nikolozka/Fibel2/Fib2_Docs/Audio/Screenshot 2024-04-28 at 23.19.49.png

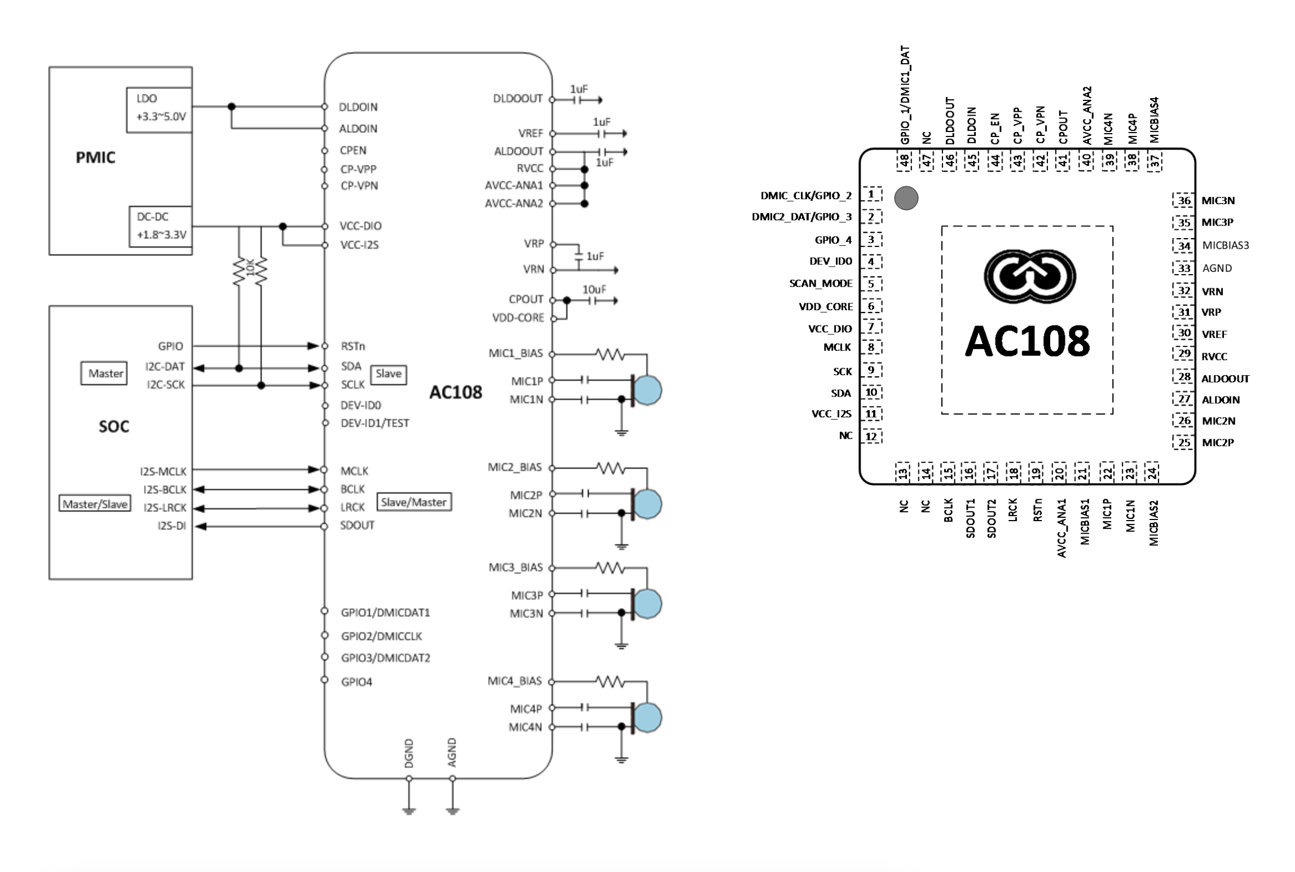
Fib2_Docs/Audio/Screenshot 2024-04-28 at 23.19.49.png
