nikolozka/Fibel2/Fib2_Docs/Jetson/Jetson_Orin_Nano_DevKit_Carrier_Board_Reference_Design_Files_A04_20230320/P3768_A04_BOM.xls

Nvidia Multi-Level BOM With AML
Target Part : | 699-13768-0000-400,NVIDIA,A (Design)
Execution Time : | 2023-02-26 17:52 PST
Configuration : | Date Effectivity: Date=2023-02-25, View=Design, Applied to Top=False, Use Default=False
Name | Qty | Ref Des | Manufacturer Part Number | Manufacturer
CAP NCS X5R 0402 0.1uF +/-10% 6.3V | 1 | C134 | C1005X5R1C104K050BA | TDK Corporation of America
 |  |  | 0402X104K6R3CT | Walsin Technology Corporation USA
 |  |  | CL05A104KQ5NNNC | SAMSUNG ELECTRONICS CO., LTD.
 |  |  | CC0402KRX5R5BB104 | Yageo Corporation
 |  |  | NMC0402X5R104K6.3TRPF | NIC COMPONENTS CORP.
 |  |  | JMK105BJ104KV-F | Taiyo Yuden Co., Ltd.
 |  |  | GRM155R60J104KA01D | Murata Manufacturing Co., Ltd.
 |  |  | C0402C104K9PACTU | KEMET Corporation
 |  |  | 04026D104KAT2A | KYOCERA Corporation
IC SERIAL EEPROM 1.0MHz DFN08 AT24C02D-MAHM-T | 1 | U17 | AT24C02D-MAHM-T | Microchip Technology, Inc.
RES 0402 10kohm 5% 62.5mW | 4 | R129, R126, R127, R131 | NRC04J103TRF | NIC COMPONENTS CORP.
 |  |  | MCR01SMQPJ103 | ROHM Co., Ltd.
 |  |  | RTT02103JTH | RALEC ELEC
 |  |  | RK73B1ETTP103J | KOA Speer Electronics, Inc.
 |  |  | RC0402JR-0710KL | Yageo Corporation
 |  |  | WR04X103 JTL | Walsin Technology Corporation USA
 |  |  | RC1005J103CS | SAMSUNG ELECTRONICS CO., LTD.
 |  |  | CRCW040210K0JNED | Vishay Americas Inc.
 |  |  | TFGL0402R1002J-T10 | Thin Film Technology Corporation
 |  |  | ERJ2GEJ103X | Panasonic Electronic Devices Co., Ltd.
CAP NCS X5R 0402 0.1uF +/-10% 6.3V | 3 | C132, C429, C430 | C1005X5R1C104K050BA | TDK Corporation of America
 |  |  | 0402X104K6R3CT | Walsin Technology Corporation USA
 |  |  | CL05A104KQ5NNNC | SAMSUNG ELECTRONICS CO., LTD.
 |  |  | CC0402KRX5R5BB104 | Yageo Corporation
 |  |  | NMC0402X5R104K6.3TRPF | NIC COMPONENTS CORP.
 |  |  | JMK105BJ104KV-F | Taiyo Yuden Co., Ltd.
 |  |  | GRM155R60J104KA01D | Murata Manufacturing Co., Ltd.
 |  |  | C0402C104K9PACTU | KEMET Corporation
 |  |  | 04026D104KAT2A | KYOCERA Corporation
Connector (TH High Temp) WIRE TO BOARD WAFER MALE VERT 4 POS 1.25mm PITCH 2.4mm MAX PIN LENGTH | 1 | J13 | 50275-00471-003 | Aces Electronic Co., Ltd.
IC GENERAL Level Shifter SC70_6 SN74LVC1T45DCKR | 1 | U15 | SN74LVC1T45DCKR | Texas Instruments, Inc.
RES 0402 100kohm 1% 62.5mW | 1 | R119 | ERJ2RKF1003X | Matsushita Electric Works, Ltd.
 |  |  | WR04X1003FTL | Walsin Technology Corporation USA
 |  |  | TFGL0402R1003F-T10 | Thin Film Technology Corporation
 |  |  | RC1005F104CS | SAMSUNG ELECTRONICS CO., LTD.
 |  |  | RC0402FR-07100KL | Yageo Corporation
 |  |  | NRC04F1003TRF | NIC COMPONENTS CORP.
 |  |  | CRCW0402100KFKED | Vishay Americas Inc.
 |  |  | MCR01SMQPF1003 | ROHM Co., Ltd.
 |  |  | RTT021003FTH | RALEC ELEC
 |  |  | RK73H1ETTP1003F | KOA Speer Electronics, Inc.
RES 0402 10kohm 5% 62.5mW | 2 | R123, R124 | NRC04J103TRF | NIC COMPONENTS CORP.
 |  |  | MCR01SMQPJ103 | ROHM Co., Ltd.
 |  |  | RTT02103JTH | RALEC ELEC
 |  |  | RK73B1ETTP103J | KOA Speer Electronics, Inc.
 |  |  | RC0402JR-0710KL | Yageo Corporation
 |  |  | WR04X103 JTL | Walsin Technology Corporation USA
 |  |  | RC1005J103CS | SAMSUNG ELECTRONICS CO., LTD.
 |  |  | CRCW040210K0JNED | Vishay Americas Inc.
 |  |  | TFGL0402R1002J-T10 | Thin Film Technology Corporation
 |  |  | ERJ2GEJ103X | Panasonic Electronic Devices Co., Ltd.
RES 0402 130ohm 5% 62.5mW | 1 | R543 | MCR01SMQPJ131 | ROHM Co., Ltd.
 |  |  | TFGL0402R1300J-T10 | Thin Film Technology Corporation
 |  |  | ERJ2GEJ131X | Matsushita Electric Works, Ltd.
 |  |  | NRC04J131TRF | NIC COMPONENTS CORP.
 |  |  | WR04X131 JTL | Walsin Technology Corporation USA
 |  |  | RC0402JR-07130RL | Yageo Corporation
 |  |  | RTT02131JTH | RALEC ELEC
 |  |  | RK73B1ETTP131J | KOA Speer Electronics, Inc.
 |  |  | RC1005J131CS | SAMSUNG ELECTRONICS CO., LTD.
 |  |  | CRCW0402130RJNED | Vishay Americas Inc.
RES 0402 4.7kohm 5% 62.5mW | 1 | R122 | RTT02472JTH | RALEC ELEC
 |  |  | CRCW04024K70JNED | Vishay Americas Inc.
 |  |  | WR04X472 JTL | Walsin Technology Corporation USA
 |  |  | ERJ2GEJ472X | Matsushita Electric Works, Ltd.
 |  |  | NRC04J472TRF | NIC COMPONENTS CORP.
 |  |  | RM04JTN472 | TA-I Technology Co., Ltd.
 |  |  | TFGL0402R4701J-T10 | Thin Film Technology Corporation
 |  |  | MCR01SMQPJ472 | ROHM Co., Ltd.
 |  |  | RC0402JR-074K7L | Yageo Corporation
 |  |  | RC1005J472CS | SAMSUNG ELECTRONICS CO., LTD.
 |  |  | RK73B1ETTP472J | KOA Speer Electronics, Inc.
N-CH MOSFET DFN1006 0.95A 12V 0.83W GLS3261NG-1DL3R | 1 | Q20 | GLS3261NG-1DL3R | LISION TECHNOLOGY INC.
OPTO LED SMD BRILLIANT YELLOW GREEN 0603 | 1 | DS1 | EAST1608GA9 | Everlight Electronics Co., Ltd.
RES 0402 1.8kohm 5% 62.5mW | 1 | R7 | RTT02182JTH | RALEC ELEC
 |  |  | RC0402JR-071K8L | Yageo Corporation
 |  |  | TFGL0402R1801J-T10 | Thin Film Technology Corporation
 |  |  | RC1005J182CS | SAMSUNG ELECTRONICS CO., LTD.
 |  |  | RK73B1ETTP182J | KOA Speer Electronics, Inc.
 |  |  | WR04X182 JTL | Walsin Technology Corporation USA
 |  |  | CRCW04021K80JNED | Vishay Americas Inc.
 |  |  | NRC04J182TRF | NIC COMPONENTS CORP.
 |  |  | ERJ2GEJ182X | Matsushita Electric Works, Ltd.
 |  |  | MCR01SMQPJ182 | ROHM Co., Ltd.
RES SCD 0402 0 OHM 1AMP | 1 | R1 | RTT02000JTH | RALEC ELEC
 |  |  | RC1005J000CS | SAMSUNG
 |  |  | WR04X000PTL | Walsin Technology Corporation USA
 |  |  | ERJ2GE0R00X | Panasonic Electric Works Co. Ltd.
 |  |  | TFGL0402WJUMPF-T10 | Thin Film Technology Corporation
N-CH MOSFET DFN1006 0.95A 12V 0.83W GLS3261NG-1DL3R | 1 | Q1 | GLS3261NG-1DL3R | LISION TECHNOLOGY INC.
CAP NCS X5R 0402 0.1uF +/-10% 6.3V | 2 | C129, C130 | C1005X5R1C104K050BA | TDK Corporation of America
 |  |  | 0402X104K6R3CT | Walsin Technology Corporation USA
 |  |  | CL05A104KQ5NNNC | SAMSUNG ELECTRONICS CO., LTD.
 |  |  | CC0402KRX5R5BB104 | Yageo Corporation
 |  |  | NMC0402X5R104K6.3TRPF | NIC COMPONENTS CORP.
 |  |  | JMK105BJ104KV-F | Taiyo Yuden Co., Ltd.
 |  |  | GRM155R60J104KA01D | Murata Manufacturing Co., Ltd.
 |  |  | C0402C104K9PACTU | KEMET Corporation
 |  |  | 04026D104KAT2A | KYOCERA Corporation
IC GENERAL Level Shifter DFN8 TXB0302DQMR | 1 | U16 | TXB0302DQMR | Texas Instruments, Inc.
RES 0402 100kohm 1% 62.5mW | 2 | R121, R125 | ERJ2RKF1003X | Matsushita Electric Works, Ltd.
 |  |  | WR04X1003FTL | Walsin Technology Corporation USA
 |  |  | TFGL0402R1003F-T10 | Thin Film Technology Corporation
 |  |  | RC1005F104CS | SAMSUNG ELECTRONICS CO., LTD.
 |  |  | RC0402FR-07100KL | Yageo Corporation
 |  |  | NRC04F1003TRF | NIC COMPONENTS CORP.
 |  |  | CRCW0402100KFKED | Vishay Americas Inc.
 |  |  | MCR01SMQPF1003 | ROHM Co., Ltd.
 |  |  | RTT021003FTH | RALEC ELEC
 |  |  | RK73H1ETTP1003F | KOA Speer Electronics, Inc.
RES SCD 0402 0 OHM 1AMP | 1 | R120 | RTT02000JTH | RALEC ELEC
 |  |  | RC1005J000CS | SAMSUNG
 |  |  | WR04X000PTL | Walsin Technology Corporation USA
 |  |  | ERJ2GE0R00X | Panasonic Electric Works Co. Ltd.
 |  |  | TFGL0402WJUMPF-T10 | Thin Film Technology Corporation
CAP X5R 0402 1uF +/-20% 16V | 1 | C357 | CC0402KRX5R7BB105 | Yageo Corporation
 |  |  | V105K0402X5R160NBT | Guangdong Viiyong Electronics Technology Co., Ltd
 |  |  | 0402X105M160CT | Walsin Technology Corporation USA
 |  |  | CL05A105KO5NNNC | Samsung Electro-Mechanics Co., Ltd.
 |  |  | EMK105BJ105KV-F | Taiyo Yuden Co., Ltd.
 |  |  | C1005X5R1C105M050BC | TDK Corporation of America
 |  |  | 0402X105K160CT | Walsin Technology Corporation USA
 |  |  | V105M0402X5R160NBT | Guangdong Viiyong Electronics Technology Co., Ltd
CAP NCS X5R 0603 10uF +/-20% 6.3V | 1 | C164 | C0603C106M9PAC | KEMET Corporation
 |  |  | 06036D106MAT2A | AVX Corporation
 |  |  | CC0603MRX5R5BB106 | Yageo Corporation
 |  |  | CL10A106MQ8NNNC | Samsung Electro-Mechanics Co., Ltd.
 |  |  | GRM188R60J106ME47D | Murata Manufacturing Co., Ltd.
 |  |  | JMK107BJ106MA-T | Taiyo Yuden Co., Ltd.
 |  |  | 0603X106M6R3CT | Walsin Technology Corporation USA
 |  |  | V106M0603X5R6R3NKT | Guangdong Viiyong Electronics Technology Co., Ltd
 |  |  | JMK107ABJ106MA-T | TAIYO YUDEN (U.S.A) INC.
CAP C0G 0402 33pF +/-5% 50V | 1 | C165 | GRM1555C1H330JA01D | Murata Manufacturing Co., Ltd.
 |  |  | CL05C330JB5NNNC | SAMSUNG ELECTRONICS CO., LTD.
 |  |  | CC0402JRNPO9BN330 | Yageo Corporation
 |  |  | 04025A330CAT2A | KYOCERA Corporation
 |  |  | C0402C330J5GACTU | KEMET Corporation
 |  |  | UMK105CG330JV-F | Taiyo Yuden Co., Ltd.
 |  |  | 0402N330J500CT | Walsin Technology Corporation USA
 |  |  | NMC0402NP0330J50TRPF | NIC COMPONENTS CORP.
 |  |  | C1005C0G1H330J050BA | TDK Corporation of America
 |  |  | C0402N330J050T | Holy Stone Enterprise (Hong Kong) Co., Ltd.
 |  |  | V330J0402C0G500NBT | Guangdong Viiyong Electronics Technology Co., Ltd
CAP X7R 0402 1.5nF +/-10% 16V | 1 | C428 | CC0402KRX7R7BB152 | Yageo Corporation
 |  |  | EMK105B7152KV-F | Taiyo Yuden Co., Ltd.
 |  |  | 0402B152K160CT | Walsin Technology Corporation USA
 |  |  | V152K0402X7R160NBT | Guangdong Viiyong Electronics Technology Co., Ltd
 |  |  | CL05B152KO5NNNC | Samsung Electro-Mechanics Co., Ltd.
CAP NCS X5R 0805 22uF +/-20% 6.3V | 3 | C358, C166, C167 | CC0805MKX5R5BB226 | Yageo Corporation
 |  |  | V226M0805X5R6R3NHP | Guangdong Viiyong Electronics Technology Co., Ltd
 |  |  | GRM21BR60J226ME39L | Murata Manufacturing Co., Ltd.
 |  |  | C2012X5R0J226MT | TDK Corporation of America
 |  |  | CL21A226MQQNNNE | Samsung Electro-Mechanics Co., Ltd.
 |  |  | CC0805MRX5R5BB226 | Yageo Corporation
 |  |  | GRM21AR60J226ME47 | Murata Manufacturing Co., Ltd.
 |  |  | 0805X226M6R3CT | Walsin Technology Corporation USA
 |  |  | C0805C226M9PAC | KEMET Corporation
 |  |  | JMK212BJ226MG-T | Taiyo Yuden Co., Ltd.
 |  |  | C0805B226M007T | Holy Stone Enterprise (Hong Kong) Co., Ltd.
IND 2520 METAL DUST 2.2uH 20% 2.2A 102mohm 0 0Hz 0Hz | 1 | L19 | HMLQ25201T-2R2MSR | Cyntec Co., Ltd.
RES 0402 100ohm 1% 62.5mW | 1 | R176 | RK73H1ETTP1000F | KOA Speer Electronics, Inc.
 |  |  | MCR01SMQPF1000 | ROHM Co., Ltd.
 |  |  | RC1005F101CS | SAMSUNG ELECTRONICS CO., LTD.
 |  |  | TFGL0402R1000F-T10 | Thin Film Technology Corporation
 |  |  | CRCW0402100RFKED | Vishay Americas Inc.
 |  |  | RC0402FR-07100RL | Yageo Corporation
 |  |  | RTT021000FTH | RALEC ELEC
 |  |  | WR04X1000FTL | Walsin Technology Corporation USA
 |  |  | ERJ2RKF1000X | Matsushita Electric Works, Ltd.
 |  |  | NRC04F1000TRF | NIC COMPONENTS CORP.
 |  |  | RM04FTN1000 | TA-I Technology Co., Ltd.
RES 0402 100kohm 1% 62.5mW | 1 | R177 | ERJ2RKF1003X | Matsushita Electric Works, Ltd.
 |  |  | WR04X1003FTL | Walsin Technology Corporation USA
 |  |  | TFGL0402R1003F-T10 | Thin Film Technology Corporation
 |  |  | RC1005F104CS | SAMSUNG ELECTRONICS CO., LTD.
 |  |  | RC0402FR-07100KL | Yageo Corporation
 |  |  | NRC04F1003TRF | NIC COMPONENTS CORP.
 |  |  | CRCW0402100KFKED | Vishay Americas Inc.
 |  |  | MCR01SMQPF1003 | ROHM Co., Ltd.
 |  |  | RTT021003FTH | RALEC ELEC
 |  |  | RK73H1ETTP1003F | KOA Speer Electronics, Inc.
RES 0402 121kohm 1% 62.5mW | 1 | R178 | TFGL0402R1213F-T10 | Thin Film Technology Corporation
 |  |  | RTT021213FTH | RALEC ELEC
 |  |  | ERJ2RKF1213X | Matsushita Electric Works, Ltd.
 |  |  | WR04X1213FTL | Walsin Technology Corporation USA
 |  |  | CRCW0402121KFKED | Vishay Americas Inc.
 |  |  | RK73H1ETTP1213F | KOA Speer Electronics, Inc.
 |  |  | MCR01SMQPF1213 | ROHM Co., Ltd.
 |  |  | NRC04F1213TRF | NIC COMPONENTS CORP.
 |  |  | RC1005F1213CS | SAMSUNG ELECTRONICS CO., LTD.
 |  |  | RC0402FR-07121KL | Yageo Corporation
RES 0402 130ohm 5% 62.5mW | 1 | R439 | MCR01SMQPJ131 | ROHM Co., Ltd.
 |  |  | TFGL0402R1300J-T10 | Thin Film Technology Corporation
 |  |  | ERJ2GEJ131X | Matsushita Electric Works, Ltd.
 |  |  | NRC04J131TRF | NIC COMPONENTS CORP.
 |  |  | WR04X131 JTL | Walsin Technology Corporation USA
 |  |  | RC0402JR-07130RL | Yageo Corporation
 |  |  | RTT02131JTH | RALEC ELEC
 |  |  | RK73B1ETTP131J | KOA Speer Electronics, Inc.
 |  |  | RC1005J131CS | SAMSUNG ELECTRONICS CO., LTD.
 |  |  | CRCW0402130RJNED | Vishay Americas Inc.
RES SCD 0402 0 OHM 1AMP | 1 | R441 | RTT02000JTH | RALEC ELEC
 |  |  | RC1005J000CS | SAMSUNG
 |  |  | WR04X000PTL | Walsin Technology Corporation USA
 |  |  | ERJ2GE0R00X | Panasonic Electric Works Co. Ltd.
 |  |  | TFGL0402WJUMPF-T10 | Thin Film Technology Corporation
VREG CONTROLLER/DRIVER/FET DFN10 Buck 1Ph 1MHz 0.6V 3.3V 1% % GS7303ACTD-R | 1 | U26 | GS7303ACTD-R | Green Solution Technology Co.,LTD.
CAP X5R 0402 0.47uF +/-10% 25V | 1 | C427 | C1005X5R1E474K050BB | TDK Corporation of America
 |  |  | CL05A474KA5NNNC | Samsung Electro-Mechanics Co., Ltd.
CAP NCS X5R 0805 22uF +/-20% 25V | 1 | C305 | C2012X5R1E226M125AC | TDK Corporation of America
 |  |  | GRM21BR61E226ME44L | Murata Manufacturing Co., Ltd.
 |  |  | CL21A226MAQNNNE | Samsung Electro-Mechanics Co., Ltd.
 |  |  | CL21A226MAYNNNE | Samsung Electro-Mechanics Co., Ltd.
 |  |  | CC0805MKX5R8BB226 | Yageo Corporation
CAP NCS X5R 0805 4.7uF +/-10% 25V | 1 | C303 | 0805X475K250CT | Walsin Technology Corporation USA
 |  |  | CL21A475KAQNNNE | Samsung Electro-Mechanics Co., Ltd.
CAP X7R 0805 1uF +/-10% 25V | 1 | C304 | C2012X7R1E105KT | TDK Corporation of America
 |  |  | TMK212B7105KG-T | Taiyo Yuden Co., Ltd.
 |  |  | CL21B105KAFNNNE | Samsung Electro-Mechanics Co., Ltd.
RES 0402 10kohm 5% 62.5mW | 3 | R381, R523, R380 | NRC04J103TRF | NIC COMPONENTS CORP.
 |  |  | MCR01SMQPJ103 | ROHM Co., Ltd.
 |  |  | RTT02103JTH | RALEC ELEC
 |  |  | RK73B1ETTP103J | KOA Speer Electronics, Inc.
 |  |  | RC0402JR-0710KL | Yageo Corporation
 |  |  | WR04X103 JTL | Walsin Technology Corporation USA
 |  |  | RC1005J103CS | SAMSUNG ELECTRONICS CO., LTD.
 |  |  | CRCW040210K0JNED | Vishay Americas Inc.
 |  |  | TFGL0402R1002J-T10 | Thin Film Technology Corporation
 |  |  | ERJ2GEJ103X | Panasonic Electronic Devices Co., Ltd.
RES 0402 1Mohm 5% 62.5mW | 2 | R524, R479 | WR04X105 JTL | Walsin Technology Corporation USA
 |  |  | RK73B1ETTP105J | KOA Speer Electronics, Inc.
 |  |  | TFGL0402R1004J-T10 | Thin Film Technology Corporation
 |  |  | NRC04J105TRF | NIC COMPONENTS CORP.
 |  |  | RC1005J105CS | SAMSUNG ELECTRONICS CO., LTD.
 |  |  | MCR01SMQPJ105 | ROHM Co., Ltd.
 |  |  | CRCW04021M00JNED | Vishay Americas Inc.
 |  |  | RTT02105JTH | RALEC ELEC
 |  |  | RC0402JR-071ML | Yageo Corporation
 |  |  | ERJ2GEJ105X | Matsushita Electric Works, Ltd.
RES 0402 15kohm 5% 62.5mW | 1 | R384 | WR04X153 JTL | Walsin Technology Corporation USA
 |  |  | RK73B1ETTP153J | KOA Speer Electronics, Inc.
 |  |  | NRC04J153TRF | NIC COMPONENTS CORP.
 |  |  | RC0402JR-0715KL | Yageo Corporation
 |  |  | RC1005J153CS | SAMSUNG ELECTRONICS CO., LTD.
 |  |  | TFGL0402R1502J-T10 | Thin Film Technology Corporation
 |  |  | RTT02153JTH | RALEC ELEC
 |  |  | ERJ2GEJ153X | Matsushita Electric Works, Ltd.
 |  |  | MCR01SMQPJ153 | ROHM Co., Ltd.
 |  |  | CRCW040215K0JNED | Vishay Americas Inc.
RES 0402 33kohm 5% 62.5mW | 1 | R383 | RC0402JR-0733KL | Yageo Corporation
 |  |  | MCR01SMQPJ333 | ROHM Co., Ltd.
 |  |  | NRC04J333TRF | NIC COMPONENTS CORP.
 |  |  | CRCW040233K0JNED | Vishay Americas Inc.
 |  |  | RK73B1ETTP333J | KOA Speer Electronics, Inc.
 |  |  | RC1005J333CS | SAMSUNG ELECTRONICS CO., LTD.
 |  |  | TFGL0402R3302J-T10 | Thin Film Technology Corporation
 |  |  | RTT02333JTH | RALEC ELEC
 |  |  | WR04X333 JTL | Walsin Technology Corporation USA
 |  |  | ERJ2GEJ333X | Matsushita Electric Works, Ltd.
RES SCD 0402 0 OHM 1AMP | 1 | R526 | RTT02000JTH | RALEC ELEC
 |  |  | RC1005J000CS | SAMSUNG
 |  |  | WR04X000PTL | Walsin Technology Corporation USA
 |  |  | ERJ2GE0R00X | Panasonic Electric Works Co. Ltd.
 |  |  | TFGL0402WJUMPF-T10 | Thin Film Technology Corporation
P-CH MOSFET DFN3X3 -17A 25V 30W AONR21357 | 4 | Q47, Q50, Q48, Q49 | AONR21357 | Alpha and Omega Semiconductor Incorporated
N-CH MOSFET NCS SOT323_1G1D1S 0.115A 20V 0.15W 2N7002_SERIES | 1 | Q56 | 2N7002HWG-3T3R | LISION TECHNOLOGY INC.
 |  |  | 2N7002W | PANJIT SEMICONDUCTOR
 |  |  | 2N7002W-7-F | Diodes Incorporated
DUAL N-CH MOSFET NCS SOT363 0.2A 0.2A 20V 20V 0.2W 0.2W BSS138 | 2 | Q57, Q46 | BSS138DW-7-F | Diodes Incorporated
 |  |  | PJT138K_R1_00001 | Pan Jit Americas, Inc.
 |  |  | LS6033DNG-3T6R | LISION TECHNOLOGY INC.
CAP TA-Polymer SMD_7343 100uF +/-20% 25V 40mohm 3.1mm Black | 2 | C146, C145 | T521D107M025ATE040 | KEMET Corporation
CAP NCS X5R 0402 0.1uF +/-10% 6.3V | 2 | C4, C5 | C1005X5R1C104K050BA | TDK Corporation of America
 |  |  | 0402X104K6R3CT | Walsin Technology Corporation USA
 |  |  | CL05A104KQ5NNNC | SAMSUNG ELECTRONICS CO., LTD.
 |  |  | CC0402KRX5R5BB104 | Yageo Corporation
 |  |  | NMC0402X5R104K6.3TRPF | NIC COMPONENTS CORP.
 |  |  | JMK105BJ104KV-F | Taiyo Yuden Co., Ltd.
 |  |  | GRM155R60J104KA01D | Murata Manufacturing Co., Ltd.
 |  |  | C0402C104K9PACTU | KEMET Corporation
 |  |  | 04026D104KAT2A | KYOCERA Corporation
Connector (Edge) DDR4 SO-DIMM SOCKET 260 PIN RA BLACK 0.5mm PITCH | 1 | J2 | 2309413-1 | TE Connectivity Ltd.
DIODE SMD SCHOTTKY BARRIER 40V 3.0A SOD-123 | 1 | D4 | LS34SG | LISION TECHNOLOGY INC.
DIODE NORM TPD1E10B06 1 Line Bi-Directional 6V 12pF | 3 | D1, D3, D2 | TPD1E10B06DPYR | Texas Instruments, Inc.
RES 0402 10kohm 5% 62.5mW | 2 | R9, R231 | NRC04J103TRF | NIC COMPONENTS CORP.
 |  |  | MCR01SMQPJ103 | ROHM Co., Ltd.
 |  |  | RTT02103JTH | RALEC ELEC
 |  |  | RK73B1ETTP103J | KOA Speer Electronics, Inc.
 |  |  | RC0402JR-0710KL | Yageo Corporation
 |  |  | WR04X103 JTL | Walsin Technology Corporation USA
 |  |  | RC1005J103CS | SAMSUNG ELECTRONICS CO., LTD.
 |  |  | CRCW040210K0JNED | Vishay Americas Inc.
 |  |  | TFGL0402R1002J-T10 | Thin Film Technology Corporation
 |  |  | ERJ2GEJ103X | Panasonic Electronic Devices Co., Ltd.
CAP X5R 0603 1uF +/-20% 25V | 1 | C168 | V105M0603X5R250NDT | Guangdong Viiyong Electronics Technology Co., Ltd
 |  |  | CL10A105KA8NNNC | Samsung Electro-Mechanics Co., Ltd.
 |  |  | TMK107 BJ105KA-T | TAIYO YUDEN (U.S.A) INC.
 |  |  | C1608X5R1E105K080AC | TDK Corporation of America
 |  |  | 0603X105K250CT | Walsin Technology Corporation USA
 |  |  | CC0603KRX5R8BB105 | Yageo Corporation
CAP NCS X5R 0805 22uF +/-20% 25V | 2 | C204, C203 | C2012X5R1E226M125AC | TDK Corporation of America
 |  |  | GRM21BR61E226ME44L | Murata Manufacturing Co., Ltd.
 |  |  | CL21A226MAQNNNE | Samsung Electro-Mechanics Co., Ltd.
 |  |  | CL21A226MAYNNNE | Samsung Electro-Mechanics Co., Ltd.
 |  |  | CC0805MKX5R8BB226 | Yageo Corporation
CAP NCS X5R 0603 0.1uF +/-10% 25V | 1 | C171 | 0603X104K250CT | Walsin Technology Corporation USA
 |  |  | GRM188R61E104KA01D | Murata Manufacturing Co., Ltd.
 |  |  | NMC0603X5R104K25TRPF | NIC COMPONENTS CORP.
 |  |  | TMK107BJ104KA-T | Taiyo Yuden Co., Ltd.
 |  |  | 06033D104KAT2A | KYOCERA Corporation
 |  |  | CC0603KRX7R8BB104 | Yageo Corporation
 |  |  | CL10A104KA8NNNC | SAMSUNG ELECTRONICS CO., LTD.
 |  |  | C0603C104K3PACTU | KEMET Corporation
 |  |  | C1608X5R1H104K080AA | TDK Corporation of America
Connector (TH High Temp) POWER JACK 24V 5A | 1 | J16 | 2DC-0005B206F | Singatron Enterprise Co., Ltd. USA
ZENER SOD323 DDZ22BSF-7 0.9V 0.5W NOM 21.71V breakdown voltage | 1 | D65 | DDZ22BSF-7 | Diodes Incorporated
RES 0402 100kohm 1% 62.5mW | 2 | R182, R181 | ERJ2RKF1003X | Matsushita Electric Works, Ltd.
 |  |  | WR04X1003FTL | Walsin Technology Corporation USA
 |  |  | TFGL0402R1003F-T10 | Thin Film Technology Corporation
 |  |  | RC1005F104CS | SAMSUNG ELECTRONICS CO., LTD.
 |  |  | RC0402FR-07100KL | Yageo Corporation
 |  |  | NRC04F1003TRF | NIC COMPONENTS CORP.
 |  |  | CRCW0402100KFKED | Vishay Americas Inc.
 |  |  | MCR01SMQPF1003 | ROHM Co., Ltd.
 |  |  | RTT021003FTH | RALEC ELEC
 |  |  | RK73H1ETTP1003F | KOA Speer Electronics, Inc.
RES 0306_JUMPER 0ohm 0.05ohm 0.1W 0306 power jumper | 2 | R260, R261 | RM06JTN0 | TA-I Technology Co., Ltd.
 |  |  | TFGL0603WJUMPF-T5 | Thin Film Technology Corporation
 |  |  | RC0603JR-070RL | Yageo Corporation
 |  |  | RTT03000JTP | RALEC ELECTRONIC CORPORATION
 |  |  | WR06X000PTL | Walsin Technology Corporation USA
 |  |  | RC1608J000CS | SAMSUNG ELECTRONICS CO., LTD.
P-CH MOSFET DFN3X3 -17A 25V 30W AONR21357 | 1 | Q25 | AONR21357 | Alpha and Omega Semiconductor Incorporated
CAP X7R 0805 4.7uF +/-10% 25V | 1 | C307 | C2012X7R1E475K | TDK Corporation of America
 |  |  | GRM21BR71E475KA73L | Murata Manufacturing Co., Ltd.
 |  |  | TMK212AB7475KG-T | TAIYO YUDEN (U.S.A) INC.
 |  |  | C2012X7R475KFPS | Darfon Electronic Corp
 |  |  | CL21B475KAFNNNE | Samsung Electro-Mechanics Co., Ltd.
CAP NCS X7R 0603 1uF +/-10% 25V | 1 | C316 | CC0603KRX7R8BB105 | Yageo Corporation
 |  |  | CL10B105KA8NNNC | Samsung Electro-Mechanics Co., Ltd.
 |  |  | TMK107 B7105KA-T | TAIYO YUDEN (U.S.A) INC.
 |  |  | GRM188R71E105KA12D | Murata Manufacturing Co., Ltd.
 |  |  | C1608X7R1E105KT | TDK Corporation of America
 |  |  | 0603B105K250CT | Walsin Technology Corporation USA
CAP NCS X6S 0805 22uF +/-20% 16V | 2 | C324, C323 | CM21X6S226M16AT | KYOCERA Corporation
 |  |  | C2012X6S1C226M125AC | TDK Corporation of America
 |  |  | GRM21BC81C226ME44L | Murata Manufacturing Co., Ltd.
 |  |  | 0805S226M160CT | Walsin Technology Corporation USA
 |  |  | CC0805MKX6S7BB226 | Yageo Corporation
 |  |  | C2012X6S226MEPS | Darfon Electronic Corp
 |  |  | C0805S226M016T | Holy Stone Enterprise (Hong Kong) Co., Ltd.
 |  |  | EDK212BC6226MG-T | Taiyo Yuden Co., Ltd.
CAP TA-Polymer SMD_3528 150uF +/-20% 6.3V 25mohm 2mm Black | 1 | C326 | T520B157M006ATE025 | KEMET Corporation
CAP NCS X6S 0805 10uF +/-10% 25V | 3 | C320, C315, C317 | 0805S106K250CT | Walsin Technology Corporation USA
 |  |  | GRM21BC81E106KE11L | Murata Manufacturing Co., Ltd.
 |  |  | CL21X106KAYNNNE | Samsung Electro-Mechanics Co., Ltd.
CAP NCS X7R 0402 0.1uF 10% 16V | 1 | C325 | C0402C104K4RACTU | KEMET Corporation
 |  |  | V104K0402X7R160NBT | Guangdong Viiyong Electronics Technology Co., Ltd
 |  |  | 0402YC104KAT2A | KYOCERA Corporation
 |  |  | HCE0402X104K016T | Holy Stone Enterprise (Hong Kong) Co., Ltd.
 |  |  | GRM155R71C104KA88D | Murata Manufacturing Co., Ltd.
 |  |  | 0402B104K160CT | Walsin Technology Corporation USA
 |  |  | CC0402KRX7R7BB104 | Yageo Corporation
 |  |  | CL05B104KO5NNNC | SAMSUNG ELECTRONICS CO., LTD.
 |  |  | C1005X7R104KETS | Darfon Electronic Corp
CAP X7R 0402 0.1uF +/-20% 50V | 2 | C311, C331 | CC0402KRX7R9BB104 | Yageo Corporation
 |  |  | C1005X7R1H104M050BB | TDK Corporation of America
 |  |  | UMK105B7104KV-FR | Taiyo Yuden Co., Ltd.
 |  |  | C1005X7R104MGTS | Darfon Electronic Corp
 |  |  | GRM155R71H104ME14D | Murata Manufacturing Co., Ltd.
 |  |  | CL05B104KB5NNNC | Samsung Electro-Mechanics Co., Ltd.
 |  |  | V104M0402X7R500NCT | Guangdong Viiyong Electronics Technology Co., Ltd
 |  |  | 04025C104KAT2A | AVX Corporation
CAP X6S 1206 22uF +/-10% 25V | 1 | C321 | CL31X226KAHN3NE | SAMSUNG ELECTRONICS CO., LTD.
CAP X7R 0402 0.1uF +/-10% 25V | 1 | C310 | C1005X7R104KFTS | Darfon Electronic Corp
 |  |  | CC0402JRX7R8BB104 | Yageo Corporation
 |  |  | TMK105B7104KV-FR | Taiyo Yuden Co., Ltd.
 |  |  | GRM155R71E104KE14D | Murata Manufacturing Co., Ltd.
 |  |  | CL05B104KA5NNNC | SAMSUNG ELECTRONICS CO., LTD.
 |  |  | 0402B104K250CT | Walsin Technology Corporation USA
 |  |  | C1005X7R1E104K050BB | TDK Corporation of America
CAP C0G 0402 330pF +/-5% 50V | 1 | C322 | C0402N331J050T | Holy Stone Enterprise (Hong Kong) Co., Ltd.
 |  |  | CL05C331JB5NNNC | SAMSUNG ELECTRONICS CO., LTD.
 |  |  | NMC0402NP0331J50TRPF | NIC COMPONENTS CORP.
 |  |  | GRM1555C1H331JA01D | Murata Manufacturing Co., Ltd.
 |  |  | 0402N331J500CT | Walsin Technology Corporation USA
 |  |  | CC0402JRNPO9BN331 | Yageo Corporation
 |  |  | 04025A331JAT2A | KYOCERA Corporation
 |  |  | C0402C331J5GACTU | KEMET Corporation
 |  |  | V331J0402C0G500NBT | Guangdong Viiyong Electronics Technology Co., Ltd
 |  |  | C1005C0G1H331J050BA | TDK Corporation of America
 |  |  | UMK105CG331JV-F | Taiyo Yuden Co., Ltd.
CAP C0G 0402 560pF +/-5% 50V | 1 | C314 | C1005NP0561JGTS | Darfon Electronic Corp
 |  |  | V561J0402C0G500NBT | Guangdong Viiyong Electronics Technology Co., Ltd
 |  |  | 0402N561J500CT | Walsin Technology Corporation USA
 |  |  | CC0402JRNPO9BN561 | Yageo Corporation
 |  |  | UMK105CG561JV-F | Taiyo Yuden Co., Ltd.
 |  |  | CL05C561JB5NNNC | Samsung Electro-Mechanics Co., Ltd.
CAP X7R 0402 1nF +/-10% 16V | 1 | C312 | 0402YC102KAT2A | KYOCERA Corporation
 |  |  | CC0402KRX7R7BB102 | Yageo Corporation
 |  |  | GRM155R71C102KA01D | Murata Manufacturing Co., Ltd.
 |  |  | NMC0402X7R102K16TRPF | NIC COMPONENTS CORP.
 |  |  | C1005X7R1E102K050BA | TDK Corporation of America
 |  |  | EMK105B7102KV-F | Taiyo Yuden Co., Ltd.
 |  |  | C0402C102K4RACTU | KEMET Corporation
 |  |  | C0402X102K016T | Holy Stone Enterprise (Hong Kong) Co., Ltd.
 |  |  | V102K0402X7R160NBT | Guangdong Viiyong Electronics Technology Co., Ltd
 |  |  | 0402B102K160CT | Walsin Technology Corporation USA
 |  |  | CL05B102KO5NNNC | Samsung Electro-Mechanics Co., Ltd.
CAP X7R 0402 47nF +/-10% 16V | 1 | C309 | C1005X7R1C473K050BC | TDK Corporation of America
 |  |  | GRM155R71C473KA01D | Murata Manufacturing Co., Ltd.
 |  |  | 0402YC473KAT2A | KYOCERA Corporation
 |  |  | C0402C473K4RACTU | KEMET Corporation
 |  |  | C0402X473K016T | Holy Stone Enterprise (Hong Kong) Co., Ltd.
 |  |  | NMC0402X7R473K16TRPF | NIC COMPONENTS CORP.
 |  |  | CC0402KRX7R7BB473 | Yageo Corporation
 |  |  | EMK105B7473KV-F | Taiyo Yuden Co., Ltd.
 |  |  | V473K0402X7R160NBT | Guangdong Viiyong Electronics Technology Co., Ltd
 |  |  | 0402B473K160CT | Walsin Technology Corporation USA
 |  |  | CL05B473KO5NNNC | Samsung Electro-Mechanics Co., Ltd.
CAP NCS X5R 0402 0.1uF +/-20% 25V | 1 | C319 | CC0402MRX5R8BB104 | Yageo Corporation
 |  |  | 0402X104M250CT | Walsin Technology Corporation USA
IND 7_6X7_6 metal 3.3uH 20% 10A 21.45mohm -1 -1KHz 29MHz | 1 | L44 | XAL7030-332MEC | Coilcraft Incorporated
RES 0402 100ohm 1% 62.5mW | 1 | R404 | RK73H1ETTP1000F | KOA Speer Electronics, Inc.
 |  |  | MCR01SMQPF1000 | ROHM Co., Ltd.
 |  |  | RC1005F101CS | SAMSUNG ELECTRONICS CO., LTD.
 |  |  | TFGL0402R1000F-T10 | Thin Film Technology Corporation
 |  |  | CRCW0402100RFKED | Vishay Americas Inc.
 |  |  | RC0402FR-07100RL | Yageo Corporation
 |  |  | RTT021000FTH | RALEC ELEC
 |  |  | WR04X1000FTL | Walsin Technology Corporation USA
 |  |  | ERJ2RKF1000X | Matsushita Electric Works, Ltd.
 |  |  | NRC04F1000TRF | NIC COMPONENTS CORP.
 |  |  | RM04FTN1000 | TA-I Technology Co., Ltd.
RES 0402 10kohm 1% 62.5mW | 3 | R389, R406, R397 | RK73H1ETTP1002F | KOA Speer Electronics, Inc.
 |  |  | TFGL0402R1002F-T10 | Thin Film Technology Corporation
 |  |  | CRCW040210K0FKED | Vishay Americas Inc.
 |  |  | WR04X1002FTL | Walsin Technology Corporation USA
 |  |  | MCR01SMQPF1002 | ROHM Co., Ltd.
 |  |  | RM04FTN1002 | TA-I Technology Co., Ltd.
 |  |  | RTT021002FTH | RALEC ELEC
 |  |  | NRC04F1002TRF | NIC COMPONENTS CORP.
 |  |  | RC1005F103CS | SAMSUNG ELECTRONICS CO., LTD.
 |  |  | RC0402FR-0710KL | Yageo Corporation
 |  |  | ERJ2RKF1002X | Matsushita Electric Works, Ltd.
RES 0402 200kohm 1% 62.5mW | 1 | R403 | CRCW0402200KFKED | Vishay Americas Inc.
 |  |  | RK73H1ETTP2003F | KOA Speer Electronics, Inc.
 |  |  | RC0402FR-07200KL | Yageo Corporation
 |  |  | RC1005F204CS | SAMSUNG ELECTRONICS CO., LTD.
 |  |  | MCR01SMQPF2003 | ROHM Co., Ltd.
 |  |  | ERJ2RKF2003X | Matsushita Electric Works, Ltd.
 |  |  | WR04X2003FTL | Walsin Technology Corporation USA
 |  |  | RTT022003FTH | RALEC ELEC
 |  |  | NRC04F2003TRF | NIC COMPONENTS CORP.
 |  |  | TFGL0402R2003F-T10 | Thin Film Technology Corporation
RES 0402 56.2kohm 1% 62.5mW | 1 | R405 | CRCW040256K2FKED | Vishay Americas Inc.
 |  |  | WR04X5622FTL | Walsin Technology Corporation USA
 |  |  | RC1005F5622CS | SAMSUNG ELECTRONICS CO., LTD.
 |  |  | RM04FTN5622 | TA-I Technology Co., Ltd.
 |  |  | ERJ2RKF5622X | Matsushita Electric Works, Ltd.
 |  |  | TFGL0402R5622F-T10 | Thin Film Technology Corporation
 |  |  | RTT025622FTH | RALEC ELEC
 |  |  | NRC04F5622TRF | NIC COMPONENTS CORP.
 |  |  | RK73H1ETTP5622F | KOA Speer Electronics, Inc.
 |  |  | RC0402FR-0756K2L | Yageo Corporation
 |  |  | MCR01SMQPF5622 | ROHM Co., Ltd.
RES 0402 715kohm 1% 62.5mW | 1 | R402 | RC1005F7153CS | SAMSUNG ELECTRONICS CO., LTD.
 |  |  | TFGL0402R7153F-T10 | Thin Film Technology Corporation
 |  |  | RK73H1ETTP7153F | KOA Speer Electronics, Inc.
 |  |  | RTT027153FTH | RALEC ELEC
 |  |  | WR04X7153FTL | Walsin Technology Corporation USA
 |  |  | RC0402FR-07715KL | Yageo Corporation
 |  |  | MCR01SMQPF7153 | ROHM Co., Ltd.
 |  |  | CRCW0402715KFKED | Vishay Americas Inc.
 |  |  | ERJ2RKF7153X | Matsushita Electric Works, Ltd.
 |  |  | NRC04F7153TRF | NIC COMPONENTS CORP.
RES 0402 56kohm 5% 62.5mW | 1 | R387 | RK73B1ETTP563J | KOA Speer Electronics, Inc.
 |  |  | NRC04J563TRF | NIC COMPONENTS CORP.
 |  |  | TFGL0402R5602J-T10 | Thin Film Technology Corporation
 |  |  | MCR01SMQPJ563 | ROHM Co., Ltd.
 |  |  | ERJ2GEJ563X | Matsushita Electric Works, Ltd.
 |  |  | RTT02563JTH | RALEC ELEC
 |  |  | RC0402JR-0756KL | Yageo Corporation
 |  |  | WR04X563 JTL | Walsin Technology Corporation USA
 |  |  | RC1005J563CS | SAMSUNG ELECTRONICS CO., LTD.
 |  |  | CRCW040256K0JNED | Vishay Americas Inc.
RES 0402 0 OHM JUMPER 0.125W | 1 | R401 | CRCW04020000Z0EDHP | Vishay Americas Inc.
 |  |  | ERJU020R00X | Panasonic Corporation
 |  |  | WF04P000 PTL | Walsin Technology Corporation USA
RES SCD 0402 0 OHM 1AMP | 4 | R407, R510, R392, R399 | RTT02000JTH | RALEC ELEC
 |  |  | RC1005J000CS | SAMSUNG
 |  |  | WR04X000PTL | Walsin Technology Corporation USA
 |  |  | ERJ2GE0R00X | Panasonic Electric Works Co. Ltd.
 |  |  | TFGL0402WJUMPF-T10 | Thin Film Technology Corporation
VREG CONTROLLER/DRIVER/FET QFN4x4 Buck 1Ph 600.0 KHz 0.795 V 20.0 V 1.0 GS9230NVTQ-R | 1 | U3 | GS9230NVTQ-R | Green Solution Technology Co.,LTD.
CAP X7R 0805 4.7uF +/-10% 25V | 1 | C327 | C2012X7R1E475K | TDK Corporation of America
 |  |  | GRM21BR71E475KA73L | Murata Manufacturing Co., Ltd.
 |  |  | TMK212AB7475KG-T | TAIYO YUDEN (U.S.A) INC.
 |  |  | C2012X7R475KFPS | Darfon Electronic Corp
 |  |  | CL21B475KAFNNNE | Samsung Electro-Mechanics Co., Ltd.
CAP NCS X7R 0603 1uF +/-10% 25V | 1 | C336 | CC0603KRX7R8BB105 | Yageo Corporation
 |  |  | CL10B105KA8NNNC | Samsung Electro-Mechanics Co., Ltd.
 |  |  | TMK107 B7105KA-T | TAIYO YUDEN (U.S.A) INC.
 |  |  | GRM188R71E105KA12D | Murata Manufacturing Co., Ltd.
 |  |  | C1608X7R1E105KT | TDK Corporation of America
 |  |  | 0603B105K250CT | Walsin Technology Corporation USA
CAP NCS X6S 0805 22uF +/-20% 16V | 4 | C343, C344, C402, C401 | CM21X6S226M16AT | KYOCERA Corporation
 |  |  | C2012X6S1C226M125AC | TDK Corporation of America
 |  |  | GRM21BC81C226ME44L | Murata Manufacturing Co., Ltd.
 |  |  | 0805S226M160CT | Walsin Technology Corporation USA
 |  |  | CC0805MKX6S7BB226 | Yageo Corporation
 |  |  | C2012X6S226MEPS | Darfon Electronic Corp
 |  |  | C0805S226M016T | Holy Stone Enterprise (Hong Kong) Co., Ltd.
 |  |  | EDK212BC6226MG-T | Taiyo Yuden Co., Ltd.
CAP TA-Polymer SMD_3528 150uF +/-20% 6.3V 25mohm 2mm Black | 1 | C346 | T520B157M006ATE025 | KEMET Corporation
CAP NCS X6S 0805 10uF +/-10% 25V | 3 | C337, C340, C335 | 0805S106K250CT | Walsin Technology Corporation USA
 |  |  | GRM21BC81E106KE11L | Murata Manufacturing Co., Ltd.
 |  |  | CL21X106KAYNNNE | Samsung Electro-Mechanics Co., Ltd.
CAP NCS X7R 0402 0.1uF 10% 16V | 1 | C345 | C0402C104K4RACTU | KEMET Corporation
 |  |  | V104K0402X7R160NBT | Guangdong Viiyong Electronics Technology Co., Ltd
 |  |  | 0402YC104KAT2A | KYOCERA Corporation
 |  |  | HCE0402X104K016T | Holy Stone Enterprise (Hong Kong) Co., Ltd.
 |  |  | GRM155R71C104KA88D | Murata Manufacturing Co., Ltd.
 |  |  | 0402B104K160CT | Walsin Technology Corporation USA
 |  |  | CC0402KRX7R7BB104 | Yageo Corporation
 |  |  | CL05B104KO5NNNC | SAMSUNG ELECTRONICS CO., LTD.
 |  |  | C1005X7R104KETS | Darfon Electronic Corp
CAP X6S 1206 22uF +/-10% 25V | 1 | C341 | CL31X226KAHN3NE | SAMSUNG ELECTRONICS CO., LTD.
CAP X7R 0402 0.1uF +/-10% 25V | 1 | C330 | C1005X7R104KFTS | Darfon Electronic Corp
 |  |  | CC0402JRX7R8BB104 | Yageo Corporation
 |  |  | TMK105B7104KV-FR | Taiyo Yuden Co., Ltd.
 |  |  | GRM155R71E104KE14D | Murata Manufacturing Co., Ltd.
 |  |  | CL05B104KA5NNNC | SAMSUNG ELECTRONICS CO., LTD.
 |  |  | 0402B104K250CT | Walsin Technology Corporation USA
 |  |  | C1005X7R1E104K050BB | TDK Corporation of America
CAP C0G 0402 3.9pF +/-0.25pF 50V | 1 | C413 | GRM1555C1H3R9CA01D | Murata Manufacturing Co., Ltd.
 |  |  | C0402C399C5GACTU | KEMET Corporation
 |  |  | 0402N3R9C500CT | Walsin Technology Corporation USA
 |  |  | C0402N3R9C050T | Holy Stone Enterprise (Hong Kong) Co., Ltd.
 |  |  | C1005C0G1H3R9C050 | TDK Corporation of America
 |  |  | CC0402CRNPO9BN3R9 | Yageo Corporation
 |  |  | 04025A3R9CAT2A | KYOCERA Corporation
 |  |  | V3R9C0402C0G500NBT | Guangdong Viiyong Electronics Technology Co., Ltd
 |  |  | CL05C3R9CB5NNNC | SAMSUNG ELECTRONICS CO., LTD.
 |  |  | NMC0402NP03R9C50TRPF | NIC COMPONENTS CORP.
 |  |  | UMK105 CG3R9CV-F | Taiyo Yuden Co., Ltd.
CAP C0G 0402 330pF +/-5% 50V | 1 | C342 | C0402N331J050T | Holy Stone Enterprise (Hong Kong) Co., Ltd.
 |  |  | CL05C331JB5NNNC | SAMSUNG ELECTRONICS CO., LTD.
 |  |  | NMC0402NP0331J50TRPF | NIC COMPONENTS CORP.
 |  |  | GRM1555C1H331JA01D | Murata Manufacturing Co., Ltd.
 |  |  | 0402N331J500CT | Walsin Technology Corporation USA
 |  |  | CC0402JRNPO9BN331 | Yageo Corporation
 |  |  | 04025A331JAT2A | KYOCERA Corporation
 |  |  | C0402C331J5GACTU | KEMET Corporation
 |  |  | V331J0402C0G500NBT | Guangdong Viiyong Electronics Technology Co., Ltd
 |  |  | C1005C0G1H331J050BA | TDK Corporation of America
 |  |  | UMK105CG331JV-F | Taiyo Yuden Co., Ltd.
CAP C0G 0402 560pF +/-5% 50V | 1 | C334 | C1005NP0561JGTS | Darfon Electronic Corp
 |  |  | V561J0402C0G500NBT | Guangdong Viiyong Electronics Technology Co., Ltd
 |  |  | 0402N561J500CT | Walsin Technology Corporation USA
 |  |  | CC0402JRNPO9BN561 | Yageo Corporation
 |  |  | UMK105CG561JV-F | Taiyo Yuden Co., Ltd.
 |  |  | CL05C561JB5NNNC | Samsung Electro-Mechanics Co., Ltd.
CAP X7R 0402 1nF +/-10% 16V | 1 | C332 | 0402YC102KAT2A | KYOCERA Corporation
 |  |  | CC0402KRX7R7BB102 | Yageo Corporation
 |  |  | GRM155R71C102KA01D | Murata Manufacturing Co., Ltd.
 |  |  | NMC0402X7R102K16TRPF | NIC COMPONENTS CORP.
 |  |  | C1005X7R1E102K050BA | TDK Corporation of America
 |  |  | EMK105B7102KV-F | Taiyo Yuden Co., Ltd.
 |  |  | C0402C102K4RACTU | KEMET Corporation
 |  |  | C0402X102K016T | Holy Stone Enterprise (Hong Kong) Co., Ltd.
 |  |  | V102K0402X7R160NBT | Guangdong Viiyong Electronics Technology Co., Ltd
 |  |  | 0402B102K160CT | Walsin Technology Corporation USA
 |  |  | CL05B102KO5NNNC | Samsung Electro-Mechanics Co., Ltd.
CAP X7R 0402 10nF +/-10% 25V | 1 | C329 | C1005X7R1E103K050BA | TDK Corporation of America
 |  |  | CGA2B2X7R1E103K050BA | TDK Corporation of America
 |  |  | C0402X103K025T | Holy Stone Enterprise (Hong Kong) Co., Ltd.
 |  |  | CC0402KRX7R8BB103 | Yageo Corporation
 |  |  | 04023C103KAT2A | KYOCERA Corporation
 |  |  | CL05B103KA5NNNC | Samsung Electro-Mechanics Co., Ltd.
 |  |  | C0402C103K3RACTU | KEMET Corporation
 |  |  | C1005X7R103KFTS | Darfon Electronic Corp
 |  |  | TMK105B7103KV-F | Taiyo Yuden Co., Ltd.
 |  |  | NMC0402X7R103K25TRPF | NIC COMPONENTS CORP.
 |  |  | 0402B103K250CT | Walsin Technology Corporation USA
 |  |  | GRM155R71E103KA01D | Murata Manufacturing Co., Ltd.
 |  |  | V103K0402X7R250NBT | Guangdong Viiyong Electronics Technology Co., Ltd
CAP NCS X5R 0402 0.1uF +/-20% 25V | 1 | C339 | CC0402MRX5R8BB104 | Yageo Corporation
 |  |  | 0402X104M250CT | Walsin Technology Corporation USA
IND 7_6X7_6 metal 3.3uH 20% 10A 21.45mohm -1 -1KHz 29MHz | 1 | L45 | XAL7030-332MEC | Coilcraft Incorporated
RES 0402 100ohm 1% 62.5mW | 1 | R423 | RK73H1ETTP1000F | KOA Speer Electronics, Inc.
 |  |  | MCR01SMQPF1000 | ROHM Co., Ltd.
 |  |  | RC1005F101CS | SAMSUNG ELECTRONICS CO., LTD.
 |  |  | TFGL0402R1000F-T10 | Thin Film Technology Corporation
 |  |  | CRCW0402100RFKED | Vishay Americas Inc.
 |  |  | RC0402FR-07100RL | Yageo Corporation
 |  |  | RTT021000FTH | RALEC ELEC
 |  |  | WR04X1000FTL | Walsin Technology Corporation USA
 |  |  | ERJ2RKF1000X | Matsushita Electric Works, Ltd.
 |  |  | NRC04F1000TRF | NIC COMPONENTS CORP.
 |  |  | RM04FTN1000 | TA-I Technology Co., Ltd.
RES 0402 10kohm 1% 62.5mW | 1 | R408 | RK73H1ETTP1002F | KOA Speer Electronics, Inc.
 |  |  | TFGL0402R1002F-T10 | Thin Film Technology Corporation
 |  |  | CRCW040210K0FKED | Vishay Americas Inc.
 |  |  | WR04X1002FTL | Walsin Technology Corporation USA
 |  |  | MCR01SMQPF1002 | ROHM Co., Ltd.
 |  |  | RM04FTN1002 | TA-I Technology Co., Ltd.
 |  |  | RTT021002FTH | RALEC ELEC
 |  |  | NRC04F1002TRF | NIC COMPONENTS CORP.
 |  |  | RC1005F103CS | SAMSUNG ELECTRONICS CO., LTD.
 |  |  | RC0402FR-0710KL | Yageo Corporation
 |  |  | ERJ2RKF1002X | Matsushita Electric Works, Ltd.
RES 0402 100kohm 1% 62.5mW | 1 | R204 | ERJ2RKF1003X | Matsushita Electric Works, Ltd.
 |  |  | WR04X1003FTL | Walsin Technology Corporation USA
 |  |  | TFGL0402R1003F-T10 | Thin Film Technology Corporation
 |  |  | RC1005F104CS | SAMSUNG ELECTRONICS CO., LTD.
 |  |  | RC0402FR-07100KL | Yageo Corporation
 |  |  | NRC04F1003TRF | NIC COMPONENTS CORP.
 |  |  | CRCW0402100KFKED | Vishay Americas Inc.
 |  |  | MCR01SMQPF1003 | ROHM Co., Ltd.
 |  |  | RTT021003FTH | RALEC ELEC
 |  |  | RK73H1ETTP1003F | KOA Speer Electronics, Inc.
RES 0402 11.3kohm 1% 62.5mW | 1 | R416 | RC1005F1132CS | SAMSUNG ELECTRONICS CO., LTD.
 |  |  | RM04FTN1132 | TA-I Technology Co., Ltd.
 |  |  | CRCW040211K3FKED | Vishay Americas Inc.
 |  |  | TFGL0402R1132F-T10 | Thin Film Technology Corporation
 |  |  | NRC04F1132TRF | NIC COMPONENTS CORP.
 |  |  | RC0402FR-0711K3L | Yageo Corporation
 |  |  | RK73H1ETTP1132F | KOA Speer Electronics, Inc.
 |  |  | MCR01SMQPF1132 | ROHM Co., Ltd.
 |  |  | WR04X1132FTL | Walsin Technology Corporation USA
 |  |  | RTT021132FTH | RALEC ELEC
 |  |  | ERJ2RKF1132X | Matsushita Electric Works, Ltd.
RES 0402 14.3kohm 1% 62.5mW | 1 | R425 | RTT021432FTH | RALEC ELEC
 |  |  | NRC04F1432TRF | NIC COMPONENTS CORP.
 |  |  | RK73H1ETTP1432F | KOA Speer Electronics, Inc.
 |  |  | RC1005F1432CS | SAMSUNG ELECTRONICS CO., LTD.
 |  |  | MCR01SMQPF1432 | ROHM Co., Ltd.
 |  |  | RC0402FR-0714K3L | Yageo Corporation
 |  |  | CRCW040214K3FKED | Vishay Americas Inc.
 |  |  | WR04X1432FTL | Walsin Technology Corporation USA
 |  |  | TFGL0402R1432F-T10 | Thin Film Technology Corporation
 |  |  | ERJ2RKF1432X | Matsushita Electric Works, Ltd.
 |  |  | RM04FTN1432 | TA-I Technology Co., Ltd.
RES 0402 20kohm 1% 62.5mW | 1 | R414 | RK73H1ETTP2002F | KOA Speer Electronics, Inc.
 |  |  | RC1005F203CS | SAMSUNG ELECTRONICS CO., LTD.
 |  |  | RC0402FR-0720KL | Yageo Corporation
 |  |  | WR04X2002FTL | Walsin Technology Corporation USA
 |  |  | TFGL0402R2002F-T10 | Thin Film Technology Corporation
 |  |  | ERJ2RKF2002X | Matsushita Electric Works, Ltd.
 |  |  | RTT022002FTH | RALEC ELEC
 |  |  | CRCW040220K0FKED | Vishay Americas Inc.
 |  |  | NRC04F2002TRF | NIC COMPONENTS CORP.
 |  |  | MCR01SMQPF2002 | ROHM Co., Ltd.
RES 0402 200kohm 1% 62.5mW | 1 | R422 | CRCW0402200KFKED | Vishay Americas Inc.
 |  |  | RK73H1ETTP2003F | KOA Speer Electronics, Inc.
 |  |  | RC0402FR-07200KL | Yageo Corporation
 |  |  | RC1005F204CS | SAMSUNG ELECTRONICS CO., LTD.
 |  |  | MCR01SMQPF2003 | ROHM Co., Ltd.
 |  |  | ERJ2RKF2003X | Matsushita Electric Works, Ltd.
 |  |  | WR04X2003FTL | Walsin Technology Corporation USA
 |  |  | RTT022003FTH | RALEC ELEC
 |  |  | NRC04F2003TRF | NIC COMPONENTS CORP.
 |  |  | TFGL0402R2003F-T10 | Thin Film Technology Corporation
RES 0402 348kohm 1% 62.5mW | 1 | R421 | RC0402FR-07348KL | Yageo Corporation
 |  |  | ERJ2RKF3483X | Matsushita Electric Works, Ltd.
 |  |  | RK73H1ETTP3483F | KOA Speer Electronics, Inc.
 |  |  | RC1005F3483CS | SAMSUNG ELECTRONICS CO., LTD.
 |  |  | WR04X3483FTL | Walsin Technology Corporation USA
 |  |  | RTT023483FTH | RALEC ELEC
 |  |  | TFGL0402R3483F-T10 | Thin Film Technology Corporation
 |  |  | NRC04F3483TRF | NIC COMPONENTS CORP.
 |  |  | RM04FTN3483 | TA-I Technology Co., Ltd.
 |  |  | CRCW0402348KFKED | Vishay Americas Inc.
 |  |  | MCR01SMQPF3483 | ROHM Co., Ltd.
RES 0402 47.5kohm 1% 62.5mW | 1 | R424 | CRCW040247K5FKED | Vishay Americas Inc.
 |  |  | RC1005F4752CS | SAMSUNG ELECTRONICS CO., LTD.
 |  |  | NRC04F4752TRF | NIC COMPONENTS CORP.
 |  |  | ERJ2RKF4752X | Matsushita Electric Works, Ltd.
 |  |  | RK73H1ETTP4752F | KOA Speer Electronics, Inc.
 |  |  | RTT024752FTH | RALEC ELEC
 |  |  | TFGL0402R4752F-T10 | Thin Film Technology Corporation
 |  |  | RC0402FR-0747K5L | Yageo Corporation
 |  |  | WR04X4752FTL | Walsin Technology Corporation USA
 |  |  | MCR01SMQPF4752 | ROHM Co., Ltd.
RES 0402 390ohm 5% 62.5mW | 1 | R411 | RC0402JR-07390RL | Yageo Corporation
 |  |  | TFGL0402R3900J-T10 | Thin Film Technology Corporation
 |  |  | RC1005J391CS | SAMSUNG ELECTRONICS CO., LTD.
 |  |  | WR04X391 JTL | Walsin Technology Corporation USA
 |  |  | CRCW0402390RJNED | Vishay Americas Inc.
 |  |  | ERJ2GEJ391X | Matsushita Electric Works, Ltd.
 |  |  | NRC04J391TRF | NIC COMPONENTS CORP.
 |  |  | MCR01SMQPJ391 | ROHM Co., Ltd.
 |  |  | RTT02391JTH | RALEC ELEC
 |  |  | RK73B1ETTP391J | KOA Speer Electronics, Inc.
RES 0402 1.27ohm 1% 62.5mW | 1 | R205 | NRC04F1R27TRF | NIC COMPONENTS CORP.
 |  |  | RK73H1ETTP1R27F | KOA Speer Electronics, Inc.
 |  |  | TFGL0402W1R27F-T10 | Thin Film Technology Corporation
 |  |  | RTT021R27FTH | RALEC ELEC
 |  |  | RC0402FR-071R27L | Yageo Corporation
 |  |  | WR04W1R27FTL | Walsin Technology Corporation USA
 |  |  | CRCW04021R27FKED | Vishay Americas Inc.
 |  |  | RC1005F1R27CS | SAMSUNG ELECTRONICS CO., LTD.
RES 0402 0 OHM JUMPER 0.125W | 1 | R420 | CRCW04020000Z0EDHP | Vishay Americas Inc.
 |  |  | ERJU020R00X | Panasonic Corporation
 |  |  | WF04P000 PTL | Walsin Technology Corporation USA
RES SCD 0402 0 OHM 1AMP | 3 | R418, R426, R511 | RTT02000JTH | RALEC ELEC
 |  |  | RC1005J000CS | SAMSUNG
 |  |  | WR04X000PTL | Walsin Technology Corporation USA
 |  |  | ERJ2GE0R00X | Panasonic Electric Works Co. Ltd.
 |  |  | TFGL0402WJUMPF-T10 | Thin Film Technology Corporation
XSTR N-CH ENHANCEMENT MODE MOSFET 20V 1.0A 45mOHM MAX @ 4.5V SOT-323 | 1 | Q37 | DMG1012UW-7 | Diodes Incorporated
N-CH MOSFET DFN1006 140.0mA 10.0V 350.0mW DMN26D0UFB4 | 1 | Q36 | DMN26D0UFB4-7 | Diodes Incorporated
VREG CONTROLLER/DRIVER/FET QFN4x4 Buck 1Ph 600.0 KHz 0.795 V 20.0 V 1.0 GS9230NVTQ-R | 1 | U4 | GS9230NVTQ-R | Green Solution Technology Co.,LTD.
CAP NCS X5R 0603 4.7uF +/-20% 6.3V | 1 | C36 | CC0603KRX5R5BB475 | Yageo Corporation
 |  |  | CL10A475KQ8NNNC | SAMSUNG ELECTRONICS CO., LTD.
 |  |  | 06036D475MAT2A | KYOCERA Corporation
 |  |  | CL10A475MQ8NNNC | Samsung Electro-Mechanics Co., Ltd.
 |  |  | 0603X475M6R3CT | Walsin Technology Corporation USA
 |  |  | V475M0603X5R6R3NDT | Guangdong Viiyong Electronics Technology Co., Ltd
 |  |  | CC0603MRX5R5BB475 | Yageo Corporation
 |  |  | C0603C475M9PAC | KEMET Corporation
 |  |  | C0603C475K9PACTU | KEMET Corporation
 |  |  | 06036D475KAT2A | KYOCERA Corporation
CAP C0G 0402 1nF +/-5% 50V | 1 | C34 | C1005NP0102JGTS | Darfon Electronic Corp
 |  |  | 0402N102J500CT | Walsin Technology Corporation USA
 |  |  | V102J0402C0G500NBT | Guangdong Viiyong Electronics Technology Co., Ltd
 |  |  | CC0402JRNPO9BN102 | Yageo Corporation
 |  |  | CL05C102JB5NNNC | Samsung Electro-Mechanics Co., Ltd.
 |  |  | GRM1555C1H102JA01D | Murata Manufacturing Co., Ltd.
 |  |  | UMK105CG102JV-F | Taiyo Yuden Co., Ltd.
CAP NCS X5R 0402 0.1uF +/-10% 6.3V | 1 | C32 | C1005X5R1C104K050BA | TDK Corporation of America
 |  |  | 0402X104K6R3CT | Walsin Technology Corporation USA
 |  |  | CL05A104KQ5NNNC | SAMSUNG ELECTRONICS CO., LTD.
 |  |  | CC0402KRX5R5BB104 | Yageo Corporation
 |  |  | NMC0402X5R104K6.3TRPF | NIC COMPONENTS CORP.
 |  |  | JMK105BJ104KV-F | Taiyo Yuden Co., Ltd.
 |  |  | GRM155R60J104KA01D | Murata Manufacturing Co., Ltd.
 |  |  | C0402C104K9PACTU | KEMET Corporation
 |  |  | 04026D104KAT2A | KYOCERA Corporation
CAP X5R 0402 1uF +/-10% 6.3V | 2 | C31, C30 | CL05A105KQ5NNNC | SAMSUNG ELECTRONICS CO., LTD.
 |  |  | GRM155R60J105KE19D | Murata Manufacturing Co., Ltd.
 |  |  | CL05A105KP5NNNC | Samsung Electro-Mechanics Co., Ltd.
 |  |  | 04026D105KAT2A | KYOCERA Corporation
 |  |  | V105K0402X5R6R3NBT | Guangdong Viiyong Electronics Technology Co., Ltd
 |  |  | CC0402KRX5R5BB105 | Yageo Corporation
 |  |  | JMK105BJ105KV-F | Taiyo Yuden Co., Ltd.
 |  |  | C0402C105K9PACTU | KEMET Corporation
 |  |  | C1005X5R1C105K050BC | TDK Corporation of America
 |  |  | NMC0402X5R105K6.3TRPF | NIC COMPONENTS CORP.
 |  |  | 0402X105K6R3CT | Walsin Technology Corporation USA
RES 0402 100kohm 1% 62.5mW | 1 | R31 | ERJ2RKF1003X | Matsushita Electric Works, Ltd.
 |  |  | WR04X1003FTL | Walsin Technology Corporation USA
 |  |  | TFGL0402R1003F-T10 | Thin Film Technology Corporation
 |  |  | RC1005F104CS | SAMSUNG ELECTRONICS CO., LTD.
 |  |  | RC0402FR-07100KL | Yageo Corporation
 |  |  | NRC04F1003TRF | NIC COMPONENTS CORP.
 |  |  | CRCW0402100KFKED | Vishay Americas Inc.
 |  |  | MCR01SMQPF1003 | ROHM Co., Ltd.
 |  |  | RTT021003FTH | RALEC ELEC
 |  |  | RK73H1ETTP1003F | KOA Speer Electronics, Inc.
RES 0402 309kohm 1% 62.5mW | 1 | R30 | CRCW0402309KFKED | Vishay Americas Inc.
 |  |  | NRC04F3093TRF | NIC COMPONENTS CORP.
 |  |  | WR04X3093FTL | Walsin Technology Corporation USA
 |  |  | MCR01SMQPF3093 | ROHM Co., Ltd.
 |  |  | RC1005F3093CS | SAMSUNG ELECTRONICS CO., LTD.
 |  |  | RK73H1ETTP3093F | KOA Speer Electronics, Inc.
 |  |  | TFGL0402R3093F-T10 | Thin Film Technology Corporation
 |  |  | ERJ2RKF3093X | Matsushita Electric Works, Ltd.
 |  |  | RC0402FR-07309KL | Yageo Corporation
 |  |  | RTT023093FTH | RALEC ELEC
VREG LINEAR SOT23_5_NOVR Standard 0.45V 0.8V 5.0V 2.0% % GS7116S5-ADJ-R | 1 | U6 | GS7116S5-ADJ-R | Green Solution Technology Co.,LTD.
CAP NCS X5R 0402 0.1uF +/-10% 6.3V | 1 | C410 | C1005X5R1C104K050BA | TDK Corporation of America
 |  |  | 0402X104K6R3CT | Walsin Technology Corporation USA
 |  |  | CL05A104KQ5NNNC | SAMSUNG ELECTRONICS CO., LTD.
 |  |  | CC0402KRX5R5BB104 | Yageo Corporation
 |  |  | NMC0402X5R104K6.3TRPF | NIC COMPONENTS CORP.
 |  |  | JMK105BJ104KV-F | Taiyo Yuden Co., Ltd.
 |  |  | GRM155R60J104KA01D | Murata Manufacturing Co., Ltd.
 |  |  | C0402C104K9PACTU | KEMET Corporation
 |  |  | 04026D104KAT2A | KYOCERA Corporation
CAP X5R 0402 1uF +/-10% 6.3V | 2 | C409, C411 | CL05A105KQ5NNNC | SAMSUNG ELECTRONICS CO., LTD.
 |  |  | GRM155R60J105KE19D | Murata Manufacturing Co., Ltd.
 |  |  | CL05A105KP5NNNC | Samsung Electro-Mechanics Co., Ltd.
 |  |  | 04026D105KAT2A | KYOCERA Corporation
 |  |  | V105K0402X5R6R3NBT | Guangdong Viiyong Electronics Technology Co., Ltd
 |  |  | CC0402KRX5R5BB105 | Yageo Corporation
 |  |  | JMK105BJ105KV-F | Taiyo Yuden Co., Ltd.
 |  |  | C0402C105K9PACTU | KEMET Corporation
 |  |  | C1005X5R1C105K050BC | TDK Corporation of America
 |  |  | NMC0402X5R105K6.3TRPF | NIC COMPONENTS CORP.
 |  |  | 0402X105K6R3CT | Walsin Technology Corporation USA
RES SCD 0402 0 OHM 1AMP | 1 | R516 | RTT02000JTH | RALEC ELEC
 |  |  | RC1005J000CS | SAMSUNG
 |  |  | WR04X000PTL | Walsin Technology Corporation USA
 |  |  | ERJ2GE0R00X | Panasonic Electric Works Co. Ltd.
 |  |  | TFGL0402WJUMPF-T10 | Thin Film Technology Corporation
VREG LINEAR SOT235 Low Drop Out/Fixed 0.6V 1.8V 1.8V 2% % AP2127K-1.8TRG1 | 1 | U5 | AP2127K-1.8TRG1 | Diodes Incorporated
CAP NCS X5R 0402 0.1uF +/-10% 6.3V | 2 | C142, C135 | C1005X5R1C104K050BA | TDK Corporation of America
 |  |  | 0402X104K6R3CT | Walsin Technology Corporation USA
 |  |  | CL05A104KQ5NNNC | SAMSUNG ELECTRONICS CO., LTD.
 |  |  | CC0402KRX5R5BB104 | Yageo Corporation
 |  |  | NMC0402X5R104K6.3TRPF | NIC COMPONENTS CORP.
 |  |  | JMK105BJ104KV-F | Taiyo Yuden Co., Ltd.
 |  |  | GRM155R60J104KA01D | Murata Manufacturing Co., Ltd.
 |  |  | C0402C104K9PACTU | KEMET Corporation
 |  |  | 04026D104KAT2A | KYOCERA Corporation
CAP X5R 0402 10nF +/-10% 16V | 1 | C169 | CL05B103KO5NNNC | SAMSUNG ELECTRONICS CO., LTD.
 |  |  | C1005X5R1C103K050BA | TDK Corporation of America
 |  |  | GRM155R61C103KA01D | Murata Manufacturing Co., Ltd.
 |  |  | 0402YD103KAT2A | KYOCERA Corporation
 |  |  | NMC0402X5R103K16TRPF | NIC COMPONENTS CORP.
 |  |  | C0402C103K4PACTU | KEMET Corporation
 |  |  | C0402B103K016T | Holy Stone Enterprise (Hong Kong) Co., Ltd.
 |  |  | V103K0402X5R160NBT | Guangdong Viiyong Electronics Technology Co., Ltd
 |  |  | EMK105BJ103KV-F | Taiyo Yuden Co., Ltd.
 |  |  | 0402B103K160CT | Walsin Technology Corporation USA
 |  |  | CC0402KRX5R8BB103 | Yageo Corporation
ZENER SOD523 BZT52C3V3T 0.9V 0.3W | 1 | D66 | BZT52C3V3T-7 | Diodes Incorporated
DIODE SMD DUAL SERIES SCHOTTKY 30V 200mA SOT-323 | 2 | D63, D62 | BAT54CW-7-F | Diodes Incorporated
IC NCS LOGIC Buffer - 74LVC1G07 SC70 Open-Drain Output | 1 | U19 | 74LVC1G07GW,125 | NEXPERIA
 |  |  | SN74LVC1G07DCKR | Texas Instruments, Inc.
IC GENERAL Level Shifter SC70_5 SN74LV1T125 | 2 | U23, U22 | SN74LV1T125DCKR | Texas Instruments, Inc.
IC PROCESSOR MICROCONTROLLER QFN20 EFM8SB10F2G | 1 | U18 | EFM8SB10F2G-A-QFN20 | Silicon Laboratories Inc.
RES 0402 10kohm 1% 62.5mW | 5 | R184, R139, R183, R224, R141 | RK73H1ETTP1002F | KOA Speer Electronics, Inc.
 |  |  | TFGL0402R1002F-T10 | Thin Film Technology Corporation
 |  |  | CRCW040210K0FKED | Vishay Americas Inc.
 |  |  | WR04X1002FTL | Walsin Technology Corporation USA
 |  |  | MCR01SMQPF1002 | ROHM Co., Ltd.
 |  |  | RM04FTN1002 | TA-I Technology Co., Ltd.
 |  |  | RTT021002FTH | RALEC ELEC
 |  |  | NRC04F1002TRF | NIC COMPONENTS CORP.
 |  |  | RC1005F103CS | SAMSUNG ELECTRONICS CO., LTD.
 |  |  | RC0402FR-0710KL | Yageo Corporation
 |  |  | ERJ2RKF1002X | Matsushita Electric Works, Ltd.
RES 0402 100kohm 1% 62.5mW | 6 | R144, R196, R138, R170, R203, R166 | ERJ2RKF1003X | Matsushita Electric Works, Ltd.
 |  |  | WR04X1003FTL | Walsin Technology Corporation USA
 |  |  | TFGL0402R1003F-T10 | Thin Film Technology Corporation
 |  |  | RC1005F104CS | SAMSUNG ELECTRONICS CO., LTD.
 |  |  | RC0402FR-07100KL | Yageo Corporation
 |  |  | NRC04F1003TRF | NIC COMPONENTS CORP.
 |  |  | CRCW0402100KFKED | Vishay Americas Inc.
 |  |  | MCR01SMQPF1003 | ROHM Co., Ltd.
 |  |  | RTT021003FTH | RALEC ELEC
 |  |  | RK73H1ETTP1003F | KOA Speer Electronics, Inc.
RES 0402 19.6kohm 1% 62.5mW | 1 | R142 | TFGL0402R1962F-T10 | Thin Film Technology Corporation
 |  |  | NRC04F1962TRF | NIC COMPONENTS CORP.
 |  |  | RTT021962FTH | RALEC ELEC
 |  |  | RC0402FR-0719K6L | Yageo Corporation
 |  |  | RK73H1ETTP1962F | KOA Speer Electronics, Inc.
 |  |  | CRCW040219K6FKED | Vishay Americas Inc.
 |  |  | WR04X1962FTL | Walsin Technology Corporation USA
 |  |  | MCR01SMQPF1962 | ROHM Co., Ltd.
 |  |  | RC1005F1962CS | SAMSUNG ELECTRONICS CO., LTD.
 |  |  | RM04FTN1962 | TA-I Technology Co., Ltd.
 |  |  | ERJ2RKF1962X | Matsushita Electric Works, Ltd.
RES 0402 5.11kohm 1% 62.5mW | 1 | R195 | RTT025111FTH | RALEC ELEC
 |  |  | NRC04F5111TRF | NIC COMPONENTS CORP.
 |  |  | RK73H1ETTP5111F | KOA Speer Electronics, Inc.
 |  |  | TFGL0402R5111F-T10 | Thin Film Technology Corporation
 |  |  | RC1005F5111CS | SAMSUNG ELECTRONICS CO., LTD.
 |  |  | MCR01SMQPF5111 | ROHM Co., Ltd.
 |  |  | RC0402FR-075K11L | Yageo Corporation
 |  |  | ERJ2RKF5111X | Matsushita Electric Works, Ltd.
 |  |  | CRCW04025K11FKED | Vishay Americas Inc.
 |  |  | WR04X5111FTL | Walsin Technology Corporation USA
RES 0402 1kohm 5% 62.5mW | 2 | R542, R525 | NRC04J102TRF | NIC COMPONENTS CORP.
 |  |  | RTT02102JTH | RALEC ELEC
 |  |  | MCR01SMQPJ102 | ROHM Co., Ltd.
 |  |  | CRCW04021K00JNED | Vishay Americas Inc.
 |  |  | TFGL0402R1001J-T10 | Thin Film Technology Corporation
 |  |  | WR04X102 JTL | Walsin Technology Corporation USA
 |  |  | RK73B1ETTP102J | KOA Speer Electronics, Inc.
 |  |  | RC0402JR-071KL | Yageo Corporation
 |  |  | RC1005J102CS | SAMSUNG ELECTRONICS CO., LTD.
 |  |  | ERJ2GEJ102X | Matsushita Electric Works, Ltd.
RES 0402 110ohm 5% 62.5mW | 1 | R165 | CRCW0402110RJNED | Vishay Americas Inc.
 |  |  | RTT02111JTH | RALEC ELEC
 |  |  | WR04X111 JTL | Walsin Technology Corporation USA
 |  |  | MCR01SMQPJ111 | ROHM Co., Ltd.
 |  |  | RK73B1ETTP111J | KOA Speer Electronics, Inc.
 |  |  | ERJ2GEJ111X | Matsushita Electric Works, Ltd.
 |  |  | RC1005J111CS | SAMSUNG ELECTRONICS CO., LTD.
 |  |  | NRC04J111TRF | NIC COMPONENTS CORP.
 |  |  | TFGL0402R1100J-T10 | Thin Film Technology Corporation
 |  |  | RC0402JR-07110RL | Yageo Corporation
RES 0402 4.7kohm 5% 62.5mW | 1 | R140 | RTT02472JTH | RALEC ELEC
 |  |  | CRCW04024K70JNED | Vishay Americas Inc.
 |  |  | WR04X472 JTL | Walsin Technology Corporation USA
 |  |  | ERJ2GEJ472X | Matsushita Electric Works, Ltd.
 |  |  | NRC04J472TRF | NIC COMPONENTS CORP.
 |  |  | RM04JTN472 | TA-I Technology Co., Ltd.
 |  |  | TFGL0402R4701J-T10 | Thin Film Technology Corporation
 |  |  | MCR01SMQPJ472 | ROHM Co., Ltd.
 |  |  | RC0402JR-074K7L | Yageo Corporation
 |  |  | RC1005J472CS | SAMSUNG ELECTRONICS CO., LTD.
 |  |  | RK73B1ETTP472J | KOA Speer Electronics, Inc.
RES 0402 91kohm 5% 62.5mW | 1 | R226 | RTT02913JTH | RALEC ELEC
 |  |  | RK73B1ETTP913J | KOA Speer Electronics, Inc.
 |  |  | RC1005J913CS | SAMSUNG ELECTRONICS CO., LTD.
 |  |  | NRC04J913TRF | NIC COMPONENTS CORP.
 |  |  | WR04X913 JTL | Walsin Technology Corporation USA
 |  |  | RC0402JR-0791KL | Yageo Corporation
 |  |  | ERJ2GEJ913X | Matsushita Electric Works, Ltd.
 |  |  | MCR01SMQPJ913 | ROHM Co., Ltd.
 |  |  | CRCW040291K0JNED | Vishay Americas Inc.
 |  |  | TFGL0402R9102J-T10 | Thin Film Technology Corporation
XSTR P-CH ENHANCEMENT MODE FET 20V -130mA 10OHM MAX @ -5V SOT-323 | 1 | Q28 | BSS84W-7-F | Diodes Incorporated
N-CH MOSFET NCS SOT323_1G1D1S 0.115A 20V 0.15W 2N7002_SERIES | 1 | Q29 | 2N7002HWG-3T3R | LISION TECHNOLOGY INC.
 |  |  | 2N7002W | PANJIT SEMICONDUCTOR
 |  |  | 2N7002W-7-F | Diodes Incorporated
CAP NCS X5R 0402 0.1uF +/-10% 6.3V | 4 | C125, C126, C128, C124 | C1005X5R1C104K050BA | TDK Corporation of America
 |  |  | 0402X104K6R3CT | Walsin Technology Corporation USA
 |  |  | CL05A104KQ5NNNC | SAMSUNG ELECTRONICS CO., LTD.
 |  |  | CC0402KRX5R5BB104 | Yageo Corporation
 |  |  | NMC0402X5R104K6.3TRPF | NIC COMPONENTS CORP.
 |  |  | JMK105BJ104KV-F | Taiyo Yuden Co., Ltd.
 |  |  | GRM155R60J104KA01D | Murata Manufacturing Co., Ltd.
 |  |  | C0402C104K9PACTU | KEMET Corporation
 |  |  | 04026D104KAT2A | KYOCERA Corporation
Header (TH High Temp) DUAL ROW 2X20 MALE VERT 2.54mm PITCH | 1 | J12 | 27-0169H-220-1G-H | Astron Technology Corp.
DIODE Bi-Directional Protection Diode 1 Line LESD5VD8LCG-R 5.5V 1.2pF | 4 | D79, D78, D80, D77 | LESD5VD8LCG-R | LISION TECHNOLOGY INC.
IC GENERAL LevelShifter QFN20 TXB0108RGYR | 3 | U12, U13, U14 | TXB0108RGYR | Texas Instruments, Inc.
RES 0402 100kohm 1% 62.5mW | 3 | R117, R118, R179 | ERJ2RKF1003X | Matsushita Electric Works, Ltd.
 |  |  | WR04X1003FTL | Walsin Technology Corporation USA
 |  |  | TFGL0402R1003F-T10 | Thin Film Technology Corporation
 |  |  | RC1005F104CS | SAMSUNG ELECTRONICS CO., LTD.
 |  |  | RC0402FR-07100KL | Yageo Corporation
 |  |  | NRC04F1003TRF | NIC COMPONENTS CORP.
 |  |  | CRCW0402100KFKED | Vishay Americas Inc.
 |  |  | MCR01SMQPF1003 | ROHM Co., Ltd.
 |  |  | RTT021003FTH | RALEC ELEC
 |  |  | RK73H1ETTP1003F | KOA Speer Electronics, Inc.
RES 0402 20kohm 1% 62.5mW | 1 | R115 | RK73H1ETTP2002F | KOA Speer Electronics, Inc.
 |  |  | RC1005F203CS | SAMSUNG ELECTRONICS CO., LTD.
 |  |  | RC0402FR-0720KL | Yageo Corporation
 |  |  | WR04X2002FTL | Walsin Technology Corporation USA
 |  |  | TFGL0402R2002F-T10 | Thin Film Technology Corporation
 |  |  | ERJ2RKF2002X | Matsushita Electric Works, Ltd.
 |  |  | RTT022002FTH | RALEC ELEC
 |  |  | CRCW040220K0FKED | Vishay Americas Inc.
 |  |  | NRC04F2002TRF | NIC COMPONENTS CORP.
 |  |  | MCR01SMQPF2002 | ROHM Co., Ltd.
RES 0402 1Mohm 5% 62.5mW | 1 | R116 | WR04X105 JTL | Walsin Technology Corporation USA
 |  |  | RK73B1ETTP105J | KOA Speer Electronics, Inc.
 |  |  | TFGL0402R1004J-T10 | Thin Film Technology Corporation
 |  |  | NRC04J105TRF | NIC COMPONENTS CORP.
 |  |  | RC1005J105CS | SAMSUNG ELECTRONICS CO., LTD.
 |  |  | MCR01SMQPJ105 | ROHM Co., Ltd.
 |  |  | CRCW04021M00JNED | Vishay Americas Inc.
 |  |  | RTT02105JTH | RALEC ELEC
 |  |  | RC0402JR-071ML | Yageo Corporation
 |  |  | ERJ2GEJ105X | Matsushita Electric Works, Ltd.
RES 0402 47kohm 5% 62.5mW | 1 | R180 | WR04X473 JTL | Walsin Technology Corporation USA
 |  |  | RK73B1ETTP473J | KOA Speer Electronics, Inc.
 |  |  | RC0402JR-0747KL | Yageo Corporation
 |  |  | ERJ2GEJ473X | Matsushita Electric Works, Ltd.
 |  |  | NRC04J473TRF | NIC COMPONENTS CORP.
 |  |  | TFGL0402R4702J-T10 | Thin Film Technology Corporation
 |  |  | CRCW040247K0JNED | Vishay Americas Inc.
 |  |  | MCR01SMQPJ473 | ROHM Co., Ltd.
 |  |  | RC1005J473CS | SAMSUNG ELECTRONICS CO., LTD.
 |  |  | RTT02473JTH | RALEC ELEC
P-CH MOSFET SOT323_1G1D1S -1.37A 8.0V 0.329W NTS4101PT1G | 1 | Q23 | NTS4101PT1G | ON Semiconductor Corporation
BJTD SOT363 -100.0mA -100.0mA -50.0V NST45010MW6T1G 0.1mW 0.1mW | 1 | Q24 | NST45010MW6T1G | ON Semiconductor Corporation
CAP X5R 0402 10nF +/-10% 16V | 1 | C133 | CL05B103KO5NNNC | SAMSUNG ELECTRONICS CO., LTD.
 |  |  | C1005X5R1C103K050BA | TDK Corporation of America
 |  |  | GRM155R61C103KA01D | Murata Manufacturing Co., Ltd.
 |  |  | 0402YD103KAT2A | KYOCERA Corporation
 |  |  | NMC0402X5R103K16TRPF | NIC COMPONENTS CORP.
 |  |  | C0402C103K4PACTU | KEMET Corporation
 |  |  | C0402B103K016T | Holy Stone Enterprise (Hong Kong) Co., Ltd.
 |  |  | V103K0402X5R160NBT | Guangdong Viiyong Electronics Technology Co., Ltd
 |  |  | EMK105BJ103KV-F | Taiyo Yuden Co., Ltd.
 |  |  | 0402B103K160CT | Walsin Technology Corporation USA
 |  |  | CC0402KRX5R8BB103 | Yageo Corporation
Header (TH High Temp) 1X12 RA Black HF 2.54mm PITCH | 1 | J14 | G2100CE04C-016-H | Wieson America Inc.
DIODE NORM TPD1E10B06 1 Line Bi-Directional 6V 12pF | 3 | D49, D81, D48 | TPD1E10B06DPYR | Texas Instruments, Inc.
RES 0402 499ohm 1% 62.5mW | 1 | R136 | CRCW0402499RFKED | Vishay Americas Inc.
 |  |  | NRC04F4990TRF | NIC COMPONENTS CORP.
 |  |  | RK73H1ETTP4990F | KOA Speer Electronics, Inc.
 |  |  | TFGL0402R4990F-T10 | Thin Film Technology Corporation
 |  |  | RC1005F4990CS | SAMSUNG ELECTRONICS CO., LTD.
 |  |  | RC0402FR-07499RL | Yageo Corporation
 |  |  | MCR01SMQPF4990 | ROHM Co., Ltd.
 |  |  | RTT024990FTH | RALEC ELEC
 |  |  | WR04X4990FTL | Walsin Technology Corporation USA
 |  |  | ERJ2RKF4990X | Matsushita Electric Works, Ltd.
RES 0402 10kohm 5% 62.5mW | 2 | R223, R135 | NRC04J103TRF | NIC COMPONENTS CORP.
 |  |  | MCR01SMQPJ103 | ROHM Co., Ltd.
 |  |  | RTT02103JTH | RALEC ELEC
 |  |  | RK73B1ETTP103J | KOA Speer Electronics, Inc.
 |  |  | RC0402JR-0710KL | Yageo Corporation
 |  |  | WR04X103 JTL | Walsin Technology Corporation USA
 |  |  | RC1005J103CS | SAMSUNG ELECTRONICS CO., LTD.
 |  |  | CRCW040210K0JNED | Vishay Americas Inc.
 |  |  | TFGL0402R1002J-T10 | Thin Film Technology Corporation
 |  |  | ERJ2GEJ103X | Panasonic Electronic Devices Co., Ltd.
RES SCD 0402 0 OHM 1AMP | 1 | R133 | RTT02000JTH | RALEC ELEC
 |  |  | RC1005J000CS | SAMSUNG
 |  |  | WR04X000PTL | Walsin Technology Corporation USA
 |  |  | ERJ2GE0R00X | Panasonic Electric Works Co. Ltd.
 |  |  | TFGL0402WJUMPF-T10 | Thin Film Technology Corporation
N-CH MOSFET DFN1006 0.95A 12V 0.83W GLS3261NG-1DL3R | 1 | Q21 | GLS3261NG-1DL3R | LISION TECHNOLOGY INC.
CAP NCS X5R 0402 0.1uF +/-10% 6.3V | 2 | C371, C106 | C1005X5R1C104K050BA | TDK Corporation of America
 |  |  | 0402X104K6R3CT | Walsin Technology Corporation USA
 |  |  | CL05A104KQ5NNNC | SAMSUNG ELECTRONICS CO., LTD.
 |  |  | CC0402KRX5R5BB104 | Yageo Corporation
 |  |  | NMC0402X5R104K6.3TRPF | NIC COMPONENTS CORP.
 |  |  | JMK105BJ104KV-F | Taiyo Yuden Co., Ltd.
 |  |  | GRM155R60J104KA01D | Murata Manufacturing Co., Ltd.
 |  |  | C0402C104K9PACTU | KEMET Corporation
 |  |  | 04026D104KAT2A | KYOCERA Corporation
Interconnect (SMD) FFC 22PIN BLACK RA | 2 | J20, J21 | 54548-2272 | Molex-Japan Co., Ltd
DIODE Bi-Directional Protection Diode 1 Line LESD5VD8LCG-R 5.5V 1.2pF | 24 | D35, D34, D26, D37, D32, D31, D39, D33, D42, D41, D46, D40, D38, D36, D28, D27, D30, D43, D25, D45, D47, D24, D29, D44 | LESD5VD8LCG-R | LISION TECHNOLOGY INC.
IC ESD PROTECTED HIGH-SPEED USB 2.0 (480-Mbps) 1:2 MULTIPLEXER/DEMULTIPLEXER SWITCH WITH SINGLE ENABLE UQFN-10 | 1 | U11 | TS3USB30ERSWR | Texas Instruments, Inc.
IC GENERAL Level Shifter SC70_5 SN74LV1T125 | 2 | U57, U58 | SN74LV1T125DCKR | Texas Instruments, Inc.
RES 0402 1kohm 5% 62.5mW | 4 | R453, R452, R454, R451 | NRC04J102TRF | NIC COMPONENTS CORP.
 |  |  | RTT02102JTH | RALEC ELEC
 |  |  | MCR01SMQPJ102 | ROHM Co., Ltd.
 |  |  | CRCW04021K00JNED | Vishay Americas Inc.
 |  |  | TFGL0402R1001J-T10 | Thin Film Technology Corporation
 |  |  | WR04X102 JTL | Walsin Technology Corporation USA
 |  |  | RK73B1ETTP102J | KOA Speer Electronics, Inc.
 |  |  | RC0402JR-071KL | Yageo Corporation
 |  |  | RC1005J102CS | SAMSUNG ELECTRONICS CO., LTD.
 |  |  | ERJ2GEJ102X | Matsushita Electric Works, Ltd.
RES 0402 10kohm 5% 62.5mW | 1 | R450 | NRC04J103TRF | NIC COMPONENTS CORP.
 |  |  | MCR01SMQPJ103 | ROHM Co., Ltd.
 |  |  | RTT02103JTH | RALEC ELEC
 |  |  | RK73B1ETTP103J | KOA Speer Electronics, Inc.
 |  |  | RC0402JR-0710KL | Yageo Corporation
 |  |  | WR04X103 JTL | Walsin Technology Corporation USA
 |  |  | RC1005J103CS | SAMSUNG ELECTRONICS CO., LTD.
 |  |  | CRCW040210K0JNED | Vishay Americas Inc.
 |  |  | TFGL0402R1002J-T10 | Thin Film Technology Corporation
 |  |  | ERJ2GEJ103X | Panasonic Electronic Devices Co., Ltd.
RES SCD 0402 0 OHM 1AMP | 1 | R95 | RTT02000JTH | RALEC ELEC
 |  |  | RC1005J000CS | SAMSUNG
 |  |  | WR04X000PTL | Walsin Technology Corporation USA
 |  |  | ERJ2GE0R00X | Panasonic Electric Works Co. Ltd.
 |  |  | TFGL0402WJUMPF-T10 | Thin Film Technology Corporation
CAP TA-Polymer SMD_3528 330uF +/-20% 6.3V 40mohm 2.1mm Black | 1 | C105 | T520B337M006ATE040 | KEMET Corporation
CAP NCS X7R 0402 0.1uF 10% 16V | 6 | C174, C236, C359, C364, C365, C102 | C0402C104K4RACTU | KEMET Corporation
 |  |  | V104K0402X7R160NBT | Guangdong Viiyong Electronics Technology Co., Ltd
 |  |  | 0402YC104KAT2A | KYOCERA Corporation
 |  |  | HCE0402X104K016T | Holy Stone Enterprise (Hong Kong) Co., Ltd.
 |  |  | GRM155R71C104KA88D | Murata Manufacturing Co., Ltd.
 |  |  | 0402B104K160CT | Walsin Technology Corporation USA
 |  |  | CC0402KRX7R7BB104 | Yageo Corporation
 |  |  | CL05B104KO5NNNC | SAMSUNG ELECTRONICS CO., LTD.
 |  |  | C1005X7R104KETS | Darfon Electronic Corp
CAP NCS X5R 0603 4.7uF +/-20% 6.3V | 1 | C360 | CC0603KRX5R5BB475 | Yageo Corporation
 |  |  | CL10A475KQ8NNNC | SAMSUNG ELECTRONICS CO., LTD.
 |  |  | 06036D475MAT2A | KYOCERA Corporation
 |  |  | CL10A475MQ8NNNC | Samsung Electro-Mechanics Co., Ltd.
 |  |  | 0603X475M6R3CT | Walsin Technology Corporation USA
 |  |  | V475M0603X5R6R3NDT | Guangdong Viiyong Electronics Technology Co., Ltd
 |  |  | CC0603MRX5R5BB475 | Yageo Corporation
 |  |  | C0603C475M9PAC | KEMET Corporation
 |  |  | C0603C475K9PACTU | KEMET Corporation
 |  |  | 06036D475KAT2A | KYOCERA Corporation
CAP NCS X5R 0603 10uF +/-20% 6.3V | 2 | C362, C363 | C0603C106M9PAC | KEMET Corporation
 |  |  | 06036D106MAT2A | AVX Corporation
 |  |  | CC0603MRX5R5BB106 | Yageo Corporation
 |  |  | CL10A106MQ8NNNC | Samsung Electro-Mechanics Co., Ltd.
 |  |  | GRM188R60J106ME47D | Murata Manufacturing Co., Ltd.
 |  |  | JMK107BJ106MA-T | Taiyo Yuden Co., Ltd.
 |  |  | 0603X106M6R3CT | Walsin Technology Corporation USA
 |  |  | V106M0603X5R6R3NKT | Guangdong Viiyong Electronics Technology Co., Ltd
 |  |  | JMK107ABJ106MA-T | TAIYO YUDEN (U.S.A) INC.
CAP C0G 0402 220pF +/-5% 50V | 2 | C368, C369 | C0402N221J050T | Holy Stone Enterprise (Hong Kong) Co., Ltd.
 |  |  | 0402N221J500CT | Walsin Technology Corporation USA
 |  |  | C1005C0G1H221J050BA | TDK Corporation of America
 |  |  | CL05C221JB5NNNC | SAMSUNG ELECTRONICS CO., LTD.
 |  |  | UMK105CG221JV-F | Taiyo Yuden Co., Ltd.
 |  |  | V221J0402C0G500NBT | Guangdong Viiyong Electronics Technology Co., Ltd
 |  |  | CC0402JRNPO9BN221 | Yageo Corporation
 |  |  | NMC0402NP0221J50TRPF | NIC COMPONENTS CORP.
 |  |  | VJ0402A221JXACW1BC | Vishay Americas Inc.
 |  |  | 04025A221JAT2A | KYOCERA Corporation
 |  |  | GRM1555C1H221JA01D | Murata Manufacturing Co., Ltd.
 |  |  | C0402C221J5GACTU | KEMET Corporation
CAP X7R 0402 10nF +/-10% 25V | 1 | C361 | C1005X7R1E103K050BA | TDK Corporation of America
 |  |  | CGA2B2X7R1E103K050BA | TDK Corporation of America
 |  |  | C0402X103K025T | Holy Stone Enterprise (Hong Kong) Co., Ltd.
 |  |  | CC0402KRX7R8BB103 | Yageo Corporation
 |  |  | 04023C103KAT2A | KYOCERA Corporation
 |  |  | CL05B103KA5NNNC | Samsung Electro-Mechanics Co., Ltd.
 |  |  | C0402C103K3RACTU | KEMET Corporation
 |  |  | C1005X7R103KFTS | Darfon Electronic Corp
 |  |  | TMK105B7103KV-F | Taiyo Yuden Co., Ltd.
 |  |  | NMC0402X7R103K25TRPF | NIC COMPONENTS CORP.
 |  |  | 0402B103K250CT | Walsin Technology Corporation USA
 |  |  | GRM155R71E103KA01D | Murata Manufacturing Co., Ltd.
 |  |  | V103K0402X7R250NBT | Guangdong Viiyong Electronics Technology Co., Ltd
CAP NCS X5R 0402 0.1uF +/-10% 6.3V | 8 | C94, C101, C99, C100, C97, C95, C98, C96 | C1005X5R1C104K050BA | TDK Corporation of America
 |  |  | 0402X104K6R3CT | Walsin Technology Corporation USA
 |  |  | CL05A104KQ5NNNC | SAMSUNG ELECTRONICS CO., LTD.
 |  |  | CC0402KRX5R5BB104 | Yageo Corporation
 |  |  | NMC0402X5R104K6.3TRPF | NIC COMPONENTS CORP.
 |  |  | JMK105BJ104KV-F | Taiyo Yuden Co., Ltd.
 |  |  | GRM155R60J104KA01D | Murata Manufacturing Co., Ltd.
 |  |  | C0402C104K9PACTU | KEMET Corporation
 |  |  | 04026D104KAT2A | KYOCERA Corporation
Interconnect (SMD) DISPLAY PORT FEMALE RA 20 POS 0.5mm PITCH BLACK Short NPTH | 1 | J8 | AC3167-0011-014-HH | Wieson America Inc.
PROTECT TPD4E02B04DQAR 2 Diffpair Bi-Directional 6.7V 0.37pF | 3 | D22, D21, D23 | TPD4E02B04DQAR | Texas Instruments, Inc.
IC LOGIC Gates - NOT SN74LVC1G04 SC70 | 1 | U49 | SN74LVC1G04DCKR | Texas Instruments, Inc.
IC GENERAL AUX / DDC Interface QFN12 PI3AUX221ZTAEX AUX / DDC INTERFACE | 1 | U50 | PI3AUX221ZTAEX | Diodes Incorporated
RES 0402 5.1Mohm 5% 62.5mW | 1 | R306 | RTT02515JTH | RALEC ELEC
 |  |  | ERJ2GEJ515X | Matsushita Electric Works, Ltd.
 |  |  | TFGL0402R5104J-T10 | Thin Film Technology Corporation
 |  |  | MCR01SMQPJ515 | ROHM Co., Ltd.
 |  |  | RC0402JR-075M1L | Yageo Corporation
 |  |  | RK73B1ETTP515J | KOA Speer Electronics, Inc.
 |  |  | WR04X515 JTL | Walsin Technology Corporation USA
 |  |  | RC1005J515CS | SAMSUNG ELECTRONICS CO., LTD.
 |  |  | NRC04J515TRF | NIC COMPONENTS CORP.
 |  |  | CRCW04025M10JNED | Vishay Americas Inc.
RES SCD 0402 0 OHM 1AMP | 11 | R557, R77, R83, R91, R79, R78, R81, R446, R84, R82, R80 | RTT02000JTH | RALEC ELEC
 |  |  | RC1005J000CS | SAMSUNG
 |  |  | WR04X000PTL | Walsin Technology Corporation USA
 |  |  | ERJ2GE0R00X | Panasonic Electric Works Co. Ltd.
 |  |  | TFGL0402WJUMPF-T10 | Thin Film Technology Corporation
VREG SOT23_5B Switch 2.0V 5.5V GS7612S5MC-R | 1 | U10 | GS7612S5MC-R | Green Solution Technology Co.,LTD.
CAP C0G 0402 100pF +/-5% 50V | 1 | C138 | UMK105CG101JV-F | Taiyo Yuden Co., Ltd.
 |  |  | 0402N101F500CT | Walsin Technology Corporation USA
 |  |  | GRM1555C1H101JA01D | Murata Manufacturing Co., Ltd.
 |  |  | 0402N101J500CT | Walsin Technology Corporation USA
 |  |  | C0402C101J5GACTU | KEMET Corporation
 |  |  | C1005C0G1H101J050BA | TDK Corporation of America
 |  |  | CL05C101JB5NNNC | Samsung Electro-Mechanics Co., Ltd.
 |  |  | V101F0402C0G500NBT | Guangdong Viiyong Electronics Technology Co., Ltd
 |  |  | CL05C101JB5NNNC | SAMSUNG ELECTRONICS CO., LTD.
 |  |  | GCM1555C1H101FA16D | Murata Manufacturing Co., Ltd.
 |  |  | C0402N101J050T | Holy Stone Enterprise (Hong Kong) Co., Ltd.
 |  |  | 04025A101JAT2A | KYOCERA Corporation
 |  |  | CC0402JRNPO9BN101 | Yageo Corporation
 |  |  | C1005NP0101JGTS | Darfon Electronic Corp
 |  |  | V101J0402C0G500NBT | Guangdong Viiyong Electronics Technology Co., Ltd
 |  |  | NMC0402NP0101J50TRPF | NIC COMPONENTS CORP.
CAP NCS X5R 0402 0.1uF +/-10% 6.3V | 1 | C137 | C1005X5R1C104K050BA | TDK Corporation of America
 |  |  | 0402X104K6R3CT | Walsin Technology Corporation USA
 |  |  | CL05A104KQ5NNNC | SAMSUNG ELECTRONICS CO., LTD.
 |  |  | CC0402KRX5R5BB104 | Yageo Corporation
 |  |  | NMC0402X5R104K6.3TRPF | NIC COMPONENTS CORP.
 |  |  | JMK105BJ104KV-F | Taiyo Yuden Co., Ltd.
 |  |  | GRM155R60J104KA01D | Murata Manufacturing Co., Ltd.
 |  |  | C0402C104K9PACTU | KEMET Corporation
 |  |  | 04026D104KAT2A | KYOCERA Corporation
CAP X5R 0402 10nF +/-10% 16V | 1 | C136 | CL05B103KO5NNNC | SAMSUNG ELECTRONICS CO., LTD.
 |  |  | C1005X5R1C103K050BA | TDK Corporation of America
 |  |  | GRM155R61C103KA01D | Murata Manufacturing Co., Ltd.
 |  |  | 0402YD103KAT2A | KYOCERA Corporation
 |  |  | NMC0402X5R103K16TRPF | NIC COMPONENTS CORP.
 |  |  | C0402C103K4PACTU | KEMET Corporation
 |  |  | C0402B103K016T | Holy Stone Enterprise (Hong Kong) Co., Ltd.
 |  |  | V103K0402X5R160NBT | Guangdong Viiyong Electronics Technology Co., Ltd
 |  |  | EMK105BJ103KV-F | Taiyo Yuden Co., Ltd.
 |  |  | 0402B103K160CT | Walsin Technology Corporation USA
 |  |  | CC0402KRX5R8BB103 | Yageo Corporation
Connector (TH High Temp) RJ45 w/ Magnetics GigaBit and PoE RA FEMALE 18POS | 1 | J15 | G7412CE04K-004-H | Wieson America Inc.
RES 0402 110ohm 5% 62.5mW | 1 | R146 | CRCW0402110RJNED | Vishay Americas Inc.
 |  |  | RTT02111JTH | RALEC ELEC
 |  |  | WR04X111 JTL | Walsin Technology Corporation USA
 |  |  | MCR01SMQPJ111 | ROHM Co., Ltd.
 |  |  | RK73B1ETTP111J | KOA Speer Electronics, Inc.
 |  |  | ERJ2GEJ111X | Matsushita Electric Works, Ltd.
 |  |  | RC1005J111CS | SAMSUNG ELECTRONICS CO., LTD.
 |  |  | NRC04J111TRF | NIC COMPONENTS CORP.
 |  |  | TFGL0402R1100J-T10 | Thin Film Technology Corporation
 |  |  | RC0402JR-07110RL | Yageo Corporation
RES 0402 120ohm 5% 62.5mW | 1 | R147 | ERJ2GEJ121X | Matsushita Electric Works, Ltd.
 |  |  | RC1005J121CS | SAMSUNG ELECTRONICS CO., LTD.
 |  |  | TFGL0402R1200J-T10 | Thin Film Technology Corporation
 |  |  | CRCW0402120RJNED | Vishay Americas Inc.
 |  |  | RTT02121JTH | RALEC ELEC
 |  |  | RC0402JR-07120RL | Yageo Corporation
 |  |  | MCR01SMQPJ121 | ROHM Co., Ltd.
 |  |  | WR04X121 JTL | Walsin Technology Corporation USA
 |  |  | RK73B1ETTP121J | KOA Speer Electronics, Inc.
 |  |  | NRC04J121TRF | NIC COMPONENTS CORP.
RES SCD 0603 0R0 JUMPER Rmax R05 1/10W | 3 | R152, R151, R153 | TFGL0603WJUMPF-T5 | Thin Film Technology Corporation
 |  |  | RC0603JR-070RL | Yageo Corporation
 |  |  | RC1608J000CS | SAMSUNG
 |  |  | RTT03000JTP | RALEC ELECTRONIC CORPORATION
 |  |  | WR06X000PTL | Walsin Technology Corporation USA
RES SCD 0402 0 OHM 1AMP | 3 | R148, R149, R150 | RTT02000JTH | RALEC ELEC
 |  |  | RC1005J000CS | SAMSUNG
 |  |  | WR04X000PTL | Walsin Technology Corporation USA
 |  |  | ERJ2GE0R00X | Panasonic Electric Works Co. Ltd.
 |  |  | TFGL0402WJUMPF-T10 | Thin Film Technology Corporation
CAP NCS X5R 0603 10uF +/-20% 6.3V | 2 | C109, C108 | C0603C106M9PAC | KEMET Corporation
 |  |  | 06036D106MAT2A | AVX Corporation
 |  |  | CC0603MRX5R5BB106 | Yageo Corporation
 |  |  | CL10A106MQ8NNNC | Samsung Electro-Mechanics Co., Ltd.
 |  |  | GRM188R60J106ME47D | Murata Manufacturing Co., Ltd.
 |  |  | JMK107BJ106MA-T | Taiyo Yuden Co., Ltd.
 |  |  | 0603X106M6R3CT | Walsin Technology Corporation USA
 |  |  | V106M0603X5R6R3NKT | Guangdong Viiyong Electronics Technology Co., Ltd
 |  |  | JMK107ABJ106MA-T | TAIYO YUDEN (U.S.A) INC.
CAP NCS X5R 0402 0.1uF +/-10% 6.3V | 5 | C375, C111, C112, C113, C110 | C1005X5R1C104K050BA | TDK Corporation of America
 |  |  | 0402X104K6R3CT | Walsin Technology Corporation USA
 |  |  | CL05A104KQ5NNNC | SAMSUNG ELECTRONICS CO., LTD.
 |  |  | CC0402KRX5R5BB104 | Yageo Corporation
 |  |  | NMC0402X5R104K6.3TRPF | NIC COMPONENTS CORP.
 |  |  | JMK105BJ104KV-F | Taiyo Yuden Co., Ltd.
 |  |  | GRM155R60J104KA01D | Murata Manufacturing Co., Ltd.
 |  |  | C0402C104K9PACTU | KEMET Corporation
 |  |  | 04026D104KAT2A | KYOCERA Corporation
Interconnect (SMD) CONN SMD M.2 TYPE FEMALE RA 67 POS 0.5MM PITCH KEY E | 1 | J10 | 2199230-4 | Tyco Electronics Corporation
DIODE Bi-Directional Protection Diode 1 Line LESD5VD8LCG-R 5.5V 1.2pF | 2 | D76, D75 | LESD5VD8LCG-R | LISION TECHNOLOGY INC.
IC NCS LOGIC Buffer - 74LVC1G07 SC70 Open-Drain Output | 2 | U53, U1 | 74LVC1G07GW,125 | NEXPERIA
 |  |  | SN74LVC1G07DCKR | Texas Instruments, Inc.
Standoff Round F-F M3 x 2.5mm x 5.56mm Steel Plated | 1 | MEC1 | DCS-00517-N1-GP3 | Cooler Master Co. Ltd
RES 0402 10kohm 5% 62.5mW | 1 | R13 | NRC04J103TRF | NIC COMPONENTS CORP.
 |  |  | MCR01SMQPJ103 | ROHM Co., Ltd.
 |  |  | RTT02103JTH | RALEC ELEC
 |  |  | RK73B1ETTP103J | KOA Speer Electronics, Inc.
 |  |  | RC0402JR-0710KL | Yageo Corporation
 |  |  | WR04X103 JTL | Walsin Technology Corporation USA
 |  |  | RC1005J103CS | SAMSUNG ELECTRONICS CO., LTD.
 |  |  | CRCW040210K0JNED | Vishay Americas Inc.
 |  |  | TFGL0402R1002J-T10 | Thin Film Technology Corporation
 |  |  | ERJ2GEJ103X | Panasonic Electronic Devices Co., Ltd.
RES 0402 47kohm 5% 62.5mW | 3 | R103, R102, R99 | WR04X473 JTL | Walsin Technology Corporation USA
 |  |  | RK73B1ETTP473J | KOA Speer Electronics, Inc.
 |  |  | RC0402JR-0747KL | Yageo Corporation
 |  |  | ERJ2GEJ473X | Matsushita Electric Works, Ltd.
 |  |  | NRC04J473TRF | NIC COMPONENTS CORP.
 |  |  | TFGL0402R4702J-T10 | Thin Film Technology Corporation
 |  |  | CRCW040247K0JNED | Vishay Americas Inc.
 |  |  | MCR01SMQPJ473 | ROHM Co., Ltd.
 |  |  | RC1005J473CS | SAMSUNG ELECTRONICS CO., LTD.
 |  |  | RTT02473JTH | RALEC ELEC
N-CH MOSFET DFN1006 0.95A 12V 0.83W GLS3261NG-1DL3R | 2 | Q17, Q18 | GLS3261NG-1DL3R | LISION TECHNOLOGY INC.
CAP NCS X5R 0603 10uF +/-20% 6.3V | 1 | C114 | C0603C106M9PAC | KEMET Corporation
 |  |  | 06036D106MAT2A | AVX Corporation
 |  |  | CC0603MRX5R5BB106 | Yageo Corporation
 |  |  | CL10A106MQ8NNNC | Samsung Electro-Mechanics Co., Ltd.
 |  |  | GRM188R60J106ME47D | Murata Manufacturing Co., Ltd.
 |  |  | JMK107BJ106MA-T | Taiyo Yuden Co., Ltd.
 |  |  | 0603X106M6R3CT | Walsin Technology Corporation USA
 |  |  | V106M0603X5R6R3NKT | Guangdong Viiyong Electronics Technology Co., Ltd
 |  |  | JMK107ABJ106MA-T | TAIYO YUDEN (U.S.A) INC.
CAP NCS X5R 0402 0.1uF +/-10% 6.3V | 2 | C144, C115 | C1005X5R1C104K050BA | TDK Corporation of America
 |  |  | 0402X104K6R3CT | Walsin Technology Corporation USA
 |  |  | CL05A104KQ5NNNC | SAMSUNG ELECTRONICS CO., LTD.
 |  |  | CC0402KRX5R5BB104 | Yageo Corporation
 |  |  | NMC0402X5R104K6.3TRPF | NIC COMPONENTS CORP.
 |  |  | JMK105BJ104KV-F | Taiyo Yuden Co., Ltd.
 |  |  | GRM155R60J104KA01D | Murata Manufacturing Co., Ltd.
 |  |  | C0402C104K9PACTU | KEMET Corporation
 |  |  | 04026D104KAT2A | KYOCERA Corporation
CAP NCS X5R 0402 0.22uF +/-10% 6.3V | 8 | C117, C120, C118, C119, C122, C121, C116, C123 | 04026D224KAT2A | KYOCERA Corporation
 |  |  | C1005X5R1C224K050BB | TDK Corporation of America
 |  |  | JMK105BJ224KV-F | Taiyo Yuden Co., Ltd.
 |  |  | 0402X224K6R3CT | Walsin Technology Corporation USA
 |  |  | GRM155R60J224KE01D | Murata Manufacturing Co., Ltd.
 |  |  | CL05A224KQ5NNNC | SAMSUNG ELECTRONICS CO., LTD.
 |  |  | NMC0402X5R224K6.3TRPF | NIC COMPONENTS CORP.
 |  |  | C0402C224K9PACTU | KEMET Corporation
 |  |  | CC0402KRX5R5BB224 | Yageo Corporation
Interconnect (SMD) CONN SMD M.2 TYPE FEMALE RA 67 POS 0.5MM PITCH | 1 | J11 | 1-2199230-5 | TE Connectivity Ltd.
OSC SMD_32X25 32.768KHz 25ppm 2.97V 3.63V 15pF D3SX003270004E | 1 | Y2 | D3SX003270004E | HOSONIC ELECTRONIC CO., LTD.
Standoff Round F-F M3 x 2.5mm x 5.56mm Steel Plated | 1 | MEC2 | DCS-00517-N1-GP3 | Cooler Master Co. Ltd
RES 0402 33ohm 5% 62.5mW | 1 | R517 | ERJ2GEJ330X | Matsushita Electric Works, Ltd.
 |  |  | RK73B1ETTP330J | KOA Speer Electronics, Inc.
 |  |  | RM04JTN330 | TA-I Technology Co., Ltd.
 |  |  | RC1005J330CS | SAMSUNG ELECTRONICS CO., LTD.
 |  |  | CRCW040233R0JNED | Vishay Americas Inc.
 |  |  | RTT02330JTH | RALEC ELEC
 |  |  | MCR01SMQPJ330 | ROHM Co., Ltd.
 |  |  | TFGL0402R33R0J-T10 | Thin Film Technology Corporation
 |  |  | RC0402JR-0733RL | Yageo Corporation
 |  |  | WR04X330 JTL | Walsin Technology Corporation USA
 |  |  | NRC04J330TRF | NIC COMPONENTS CORP.
CAP NCS X5R 0603 10uF +/-20% 6.3V | 1 | C393 | C0603C106M9PAC | KEMET Corporation
 |  |  | 06036D106MAT2A | AVX Corporation
 |  |  | CC0603MRX5R5BB106 | Yageo Corporation
 |  |  | CL10A106MQ8NNNC | Samsung Electro-Mechanics Co., Ltd.
 |  |  | GRM188R60J106ME47D | Murata Manufacturing Co., Ltd.
 |  |  | JMK107BJ106MA-T | Taiyo Yuden Co., Ltd.
 |  |  | 0603X106M6R3CT | Walsin Technology Corporation USA
 |  |  | V106M0603X5R6R3NKT | Guangdong Viiyong Electronics Technology Co., Ltd
 |  |  | JMK107ABJ106MA-T | TAIYO YUDEN (U.S.A) INC.
CAP NCS X5R 0402 0.1uF +/-10% 6.3V | 3 | C391, C394, C392 | C1005X5R1C104K050BA | TDK Corporation of America
 |  |  | 0402X104K6R3CT | Walsin Technology Corporation USA
 |  |  | CL05A104KQ5NNNC | SAMSUNG ELECTRONICS CO., LTD.
 |  |  | CC0402KRX5R5BB104 | Yageo Corporation
 |  |  | NMC0402X5R104K6.3TRPF | NIC COMPONENTS CORP.
 |  |  | JMK105BJ104KV-F | Taiyo Yuden Co., Ltd.
 |  |  | GRM155R60J104KA01D | Murata Manufacturing Co., Ltd.
 |  |  | C0402C104K9PACTU | KEMET Corporation
 |  |  | 04026D104KAT2A | KYOCERA Corporation
CAP NCS X5R 0402 0.22uF +/-10% 6.3V | 4 | C395, C396, C398, C397 | 04026D224KAT2A | KYOCERA Corporation
 |  |  | C1005X5R1C224K050BB | TDK Corporation of America
 |  |  | JMK105BJ224KV-F | Taiyo Yuden Co., Ltd.
 |  |  | 0402X224K6R3CT | Walsin Technology Corporation USA
 |  |  | GRM155R60J224KE01D | Murata Manufacturing Co., Ltd.
 |  |  | CL05A224KQ5NNNC | SAMSUNG ELECTRONICS CO., LTD.
 |  |  | NMC0402X5R224K6.3TRPF | NIC COMPONENTS CORP.
 |  |  | C0402C224K9PACTU | KEMET Corporation
 |  |  | CC0402KRX5R5BB224 | Yageo Corporation
Interconnect (SMD) CONN SMD M.2 TYPE FEMALE RA 67 POS 0.5MM PITCH | 1 | J24 | 1-2199230-5 | TE Connectivity Ltd.
OSC SMD_32X25 32.768KHz 25ppm 2.97V 3.63V 15pF D3SX003270004E | 1 | Y4 | D3SX003270004E | HOSONIC ELECTRONIC CO., LTD.
IC NCS LOGIC Buffer - 74LVC1G07 SC70 Open-Drain Output | 1 | U56 | 74LVC1G07GW,125 | NEXPERIA
 |  |  | SN74LVC1G07DCKR | Texas Instruments, Inc.
Standoff Round F-F M3 x 2.5mm x 5.56mm Steel Plated | 1 | MEC3 | DCS-00517-N1-GP3 | Cooler Master Co. Ltd
RES 0402 10kohm 5% 62.5mW | 2 | R497, R518 | NRC04J103TRF | NIC COMPONENTS CORP.
 |  |  | MCR01SMQPJ103 | ROHM Co., Ltd.
 |  |  | RTT02103JTH | RALEC ELEC
 |  |  | RK73B1ETTP103J | KOA Speer Electronics, Inc.
 |  |  | RC0402JR-0710KL | Yageo Corporation
 |  |  | WR04X103 JTL | Walsin Technology Corporation USA
 |  |  | RC1005J103CS | SAMSUNG ELECTRONICS CO., LTD.
 |  |  | CRCW040210K0JNED | Vishay Americas Inc.
 |  |  | TFGL0402R1002J-T10 | Thin Film Technology Corporation
 |  |  | ERJ2GEJ103X | Panasonic Electronic Devices Co., Ltd.
RES 0402 33ohm 5% 62.5mW | 1 | R519 | ERJ2GEJ330X | Matsushita Electric Works, Ltd.
 |  |  | RK73B1ETTP330J | KOA Speer Electronics, Inc.
 |  |  | RM04JTN330 | TA-I Technology Co., Ltd.
 |  |  | RC1005J330CS | SAMSUNG ELECTRONICS CO., LTD.
 |  |  | CRCW040233R0JNED | Vishay Americas Inc.
 |  |  | RTT02330JTH | RALEC ELEC
 |  |  | MCR01SMQPJ330 | ROHM Co., Ltd.
 |  |  | TFGL0402R33R0J-T10 | Thin Film Technology Corporation
 |  |  | RC0402JR-0733RL | Yageo Corporation
 |  |  | WR04X330 JTL | Walsin Technology Corporation USA
 |  |  | NRC04J330TRF | NIC COMPONENTS CORP.
RES SCD 0402 0 OHM 1AMP | 11 | R467, R458, R469, R512, R465, R471, R463, R460, R513, R473, R514 | RTT02000JTH | RALEC ELEC
 |  |  | RC1005J000CS | SAMSUNG
 |  |  | WR04X000PTL | Walsin Technology Corporation USA
 |  |  | ERJ2GE0R00X | Panasonic Electric Works Co. Ltd.
 |  |  | TFGL0402WJUMPF-T10 | Thin Film Technology Corporation
CAP X5R 0402 1uF +/-20% 16V | 1 | C390 | CC0402KRX5R7BB105 | Yageo Corporation
 |  |  | V105K0402X5R160NBT | Guangdong Viiyong Electronics Technology Co., Ltd
 |  |  | 0402X105M160CT | Walsin Technology Corporation USA
 |  |  | CL05A105KO5NNNC | Samsung Electro-Mechanics Co., Ltd.
 |  |  | EMK105BJ105KV-F | Taiyo Yuden Co., Ltd.
 |  |  | C1005X5R1C105M050BC | TDK Corporation of America
 |  |  | 0402X105K160CT | Walsin Technology Corporation USA
 |  |  | V105M0402X5R160NBT | Guangdong Viiyong Electronics Technology Co., Ltd
CAP NCS X7R 0402 0.1uF 10% 16V | 4 | C386, C384, C385, C388 | C0402C104K4RACTU | KEMET Corporation
 |  |  | V104K0402X7R160NBT | Guangdong Viiyong Electronics Technology Co., Ltd
 |  |  | 0402YC104KAT2A | KYOCERA Corporation
 |  |  | HCE0402X104K016T | Holy Stone Enterprise (Hong Kong) Co., Ltd.
 |  |  | GRM155R71C104KA88D | Murata Manufacturing Co., Ltd.
 |  |  | 0402B104K160CT | Walsin Technology Corporation USA
 |  |  | CC0402KRX7R7BB104 | Yageo Corporation
 |  |  | CL05B104KO5NNNC | SAMSUNG ELECTRONICS CO., LTD.
 |  |  | C1005X7R104KETS | Darfon Electronic Corp
CAP NCS X5R 0603 4.7uF +/-20% 6.3V | 2 | C381, C389 | CC0603KRX5R5BB475 | Yageo Corporation
 |  |  | CL10A475KQ8NNNC | SAMSUNG ELECTRONICS CO., LTD.
 |  |  | 06036D475MAT2A | KYOCERA Corporation
 |  |  | CL10A475MQ8NNNC | Samsung Electro-Mechanics Co., Ltd.
 |  |  | 0603X475M6R3CT | Walsin Technology Corporation USA
 |  |  | V475M0603X5R6R3NDT | Guangdong Viiyong Electronics Technology Co., Ltd
 |  |  | CC0603MRX5R5BB475 | Yageo Corporation
 |  |  | C0603C475M9PAC | KEMET Corporation
 |  |  | C0603C475K9PACTU | KEMET Corporation
 |  |  | 06036D475KAT2A | KYOCERA Corporation
CAP C0G 0402 390pF +/-5% 50V | 2 | C383, C382 | V391J0402C0G500NBT | Guangdong Viiyong Electronics Technology Co., Ltd
 |  |  | 0402N391J500CT | Walsin Technology Corporation USA
 |  |  | CC0402JRNPO9BN391 | Yageo Corporation
 |  |  | CL05C391JB5NNNC | Samsung Electro-Mechanics Co., Ltd.
 |  |  | UMK105CG391JV-F | Taiyo Yuden Co., Ltd.
CAP NCS X5R 0402 0.1uF +/-10% 6.3V | 5 | C377, C379, C380, C39, C378 | C1005X5R1C104K050BA | TDK Corporation of America
 |  |  | 0402X104K6R3CT | Walsin Technology Corporation USA
 |  |  | CL05A104KQ5NNNC | SAMSUNG ELECTRONICS CO., LTD.
 |  |  | CC0402KRX5R5BB104 | Yageo Corporation
 |  |  | NMC0402X5R104K6.3TRPF | NIC COMPONENTS CORP.
 |  |  | JMK105BJ104KV-F | Taiyo Yuden Co., Ltd.
 |  |  | GRM155R60J104KA01D | Murata Manufacturing Co., Ltd.
 |  |  | C0402C104K9PACTU | KEMET Corporation
 |  |  | 04026D104KAT2A | KYOCERA Corporation
CONNECTOR SMD USB TYPE C FEMALE RA 24 POS 0.5mm PITCH | 1 | J5 | 12401826E412A | Amphenol Interconnect Products Corporation
PROTECT TPD4E02B04DQAR 2 Diffpair Bi-Directional 6.7V 0.37pF | 3 | D69, D68, D67 | TPD4E02B04DQAR | Texas Instruments, Inc.
PROTECT MSMP20A-M3/89A 1 Line Uni-Directional 22.2V 102pF HBM 8KV contact ESD | 1 | D5 | MSMP20A-M3/89A | Vishay Americas Inc.
IC LOGIC PCIE MUX - 1 Differential Channel - 2:1 PI3DBS12212AZBSEX TQFN_20_R | 1 | U37 | PI3DBS12212AZBSEX | Diodes Incorporated
IC GENERAL Integrated Load Switch SOT23_5B AP22811AW5-7 UL switch w/ 2A limit and fault indicator | 1 | U55 | AP22811AW5-7 | Diodes Incorporated
IC CONTROLLER USB FUSB301TMX QFN10 Type-C CC Controller | 1 | U54 | FUSB301TMX | ON Semiconductor Corporation
RES 0402 10kohm 5% 62.5mW | 2 | R491, R492 | NRC04J103TRF | NIC COMPONENTS CORP.
 |  |  | MCR01SMQPJ103 | ROHM Co., Ltd.
 |  |  | RTT02103JTH | RALEC ELEC
 |  |  | RK73B1ETTP103J | KOA Speer Electronics, Inc.
 |  |  | RC0402JR-0710KL | Yageo Corporation
 |  |  | WR04X103 JTL | Walsin Technology Corporation USA
 |  |  | RC1005J103CS | SAMSUNG ELECTRONICS CO., LTD.
 |  |  | CRCW040210K0JNED | Vishay Americas Inc.
 |  |  | TFGL0402R1002J-T10 | Thin Film Technology Corporation
 |  |  | ERJ2GEJ103X | Panasonic Electronic Devices Co., Ltd.
RES 0402 100kohm 5% 62.5mW | 1 | R485 | ERJ2GEJ104X | Matsushita Electric Works, Ltd.
 |  |  | MCR01SMQPJ104 | ROHM Co., Ltd.
 |  |  | WR04X104 JTL | Walsin Technology Corporation USA
 |  |  | RC1005J104CS | SAMSUNG ELECTRONICS CO., LTD.
 |  |  | CRCW0402100KJNED | Vishay Americas Inc.
 |  |  | RTT02104JTH | RALEC ELEC
 |  |  | NRC04J104TRF | NIC COMPONENTS CORP.
 |  |  | RK73B1ETTP104J | KOA Speer Electronics, Inc.
 |  |  | RC0402JR-07100KL | Yageo Corporation
 |  |  | TFGL0402R1003J-T10 | Thin Film Technology Corporation
RES 0402 5.1kohm 5% 62.5mW | 1 | R486 | RK73B1ETTP512J | KOA Speer Electronics, Inc.
 |  |  | CRCW04025K10JNED | Vishay Americas Inc.
 |  |  | TFGL0402R5101J-T10 | Thin Film Technology Corporation
 |  |  | NRC04J512TRF | NIC COMPONENTS CORP.
 |  |  | RTT02512JTH | RALEC ELEC
 |  |  | MCR01SMQPJ512 | ROHM Co., Ltd.
 |  |  | ERJ2GEJ512X | Matsushita Electric Works, Ltd.
 |  |  | RC1005J512CS | SAMSUNG ELECTRONICS CO., LTD.
 |  |  | WR04X512 JTL | Walsin Technology Corporation USA
 |  |  | RC0402JR-075K1L | Yageo Corporation
RES SCD 0402 0 OHM 1AMP | 8 | R488, R499, R490, R482, R489, R487, R493, R498 | RTT02000JTH | RALEC ELEC
 |  |  | RC1005J000CS | SAMSUNG
 |  |  | WR04X000PTL | Walsin Technology Corporation USA
 |  |  | ERJ2GE0R00X | Panasonic Electric Works Co. Ltd.
 |  |  | TFGL0402WJUMPF-T10 | Thin Film Technology Corporation
N-CH MOSFET SOT323_1G1D1S 0.27A 20V 0.44W DMN61D9UW-7 | 1 | Q54 | DMN61D9UW-7 | Diodes Incorporated
CAP TA-Polymer SMD_3528 330uF +/-20% 6.3V 40mohm 2.1mm Black | 2 | C160, C376 | T520B337M006ATE040 | KEMET Corporation
CAP NCS X5R 0603 4.7uF +/-20% 6.3V | 2 | C158, C127 | CC0603KRX5R5BB475 | Yageo Corporation
 |  |  | CL10A475KQ8NNNC | SAMSUNG ELECTRONICS CO., LTD.
 |  |  | 06036D475MAT2A | KYOCERA Corporation
 |  |  | CL10A475MQ8NNNC | Samsung Electro-Mechanics Co., Ltd.
 |  |  | 0603X475M6R3CT | Walsin Technology Corporation USA
 |  |  | V475M0603X5R6R3NDT | Guangdong Viiyong Electronics Technology Co., Ltd
 |  |  | CC0603MRX5R5BB475 | Yageo Corporation
 |  |  | C0603C475M9PAC | KEMET Corporation
 |  |  | C0603C475K9PACTU | KEMET Corporation
 |  |  | 06036D475KAT2A | KYOCERA Corporation
CAP NCS X5R 0603 10uF +/-20% 6.3V | 2 | C52, C58 | C0603C106M9PAC | KEMET Corporation
 |  |  | 06036D106MAT2A | AVX Corporation
 |  |  | CC0603MRX5R5BB106 | Yageo Corporation
 |  |  | CL10A106MQ8NNNC | Samsung Electro-Mechanics Co., Ltd.
 |  |  | GRM188R60J106ME47D | Murata Manufacturing Co., Ltd.
 |  |  | JMK107BJ106MA-T | Taiyo Yuden Co., Ltd.
 |  |  | 0603X106M6R3CT | Walsin Technology Corporation USA
 |  |  | V106M0603X5R6R3NKT | Guangdong Viiyong Electronics Technology Co., Ltd
 |  |  | JMK107ABJ106MA-T | TAIYO YUDEN (U.S.A) INC.
CAP C0G 0402 22pF +/-5% 50V | 2 | C61, C63 | GRM1555C1H220JA01D | Murata Manufacturing Co., Ltd.
 |  |  | C1005C0G1H220J050BA | TDK Corporation of America
 |  |  | C0402N220J050T | Holy Stone Enterprise (Hong Kong) Co., Ltd.
 |  |  | V220J0402C0G500NBT | Guangdong Viiyong Electronics Technology Co., Ltd
 |  |  | CC0402JRNPO9BN220 | Yageo Corporation
 |  |  | NMC0402NP0220J50TRPF | NIC COMPONENTS CORP.
 |  |  | 0402N220J500CT | Walsin Technology Corporation USA
 |  |  | 04025A220JAT2A | KYOCERA Corporation
 |  |  | CL05C220JB5NNNC | SAMSUNG ELECTRONICS CO., LTD.
 |  |  | C0402C220J5GACTU | KEMET Corporation
 |  |  | UMK105CG220JV-F | Taiyo Yuden Co., Ltd.
CAP NCS X5R 0402 0.1uF +/-10% 6.3V | 28 | C73, C74, C155, C45, C72, C75, C170, C252, C62, C48, C41, C51, C47, C40, C49, C172, C60, C65, C44, C67, C66, C55, C56, C64, C173, C46, C43, C42 | C1005X5R1C104K050BA | TDK Corporation of America
 |  |  | 0402X104K6R3CT | Walsin Technology Corporation USA
 |  |  | CL05A104KQ5NNNC | SAMSUNG ELECTRONICS CO., LTD.
 |  |  | CC0402KRX5R5BB104 | Yageo Corporation
 |  |  | NMC0402X5R104K6.3TRPF | NIC COMPONENTS CORP.
 |  |  | JMK105BJ104KV-F | Taiyo Yuden Co., Ltd.
 |  |  | GRM155R60J104KA01D | Murata Manufacturing Co., Ltd.
 |  |  | C0402C104K9PACTU | KEMET Corporation
 |  |  | 04026D104KAT2A | KYOCERA Corporation
Connector (TH High Temp) Dual USB3.1 Gen2 receptacle connector dip type | 2 | J7, J6 | G3509CE04C-008-H | Wieson America Inc.
XTAL SMD_32X25 12MHz 15ppm Fundamental 10pF 7M12070053 12MHz 15ppm Fundamental 10pF | 1 | Y1 | 7M12070053 | TXC CORPORATION
PROTECT TPD4E02B04DQAR 2 Diffpair Bi-Directional 6.7V 0.37pF | 6 | D13, D9, D10, D11, D12, D8 | TPD4E02B04DQAR | Texas Instruments, Inc.
IC GENERAL Integrated Load Switch SOT23_5B AP22811AW5-7 UL switch w/ 2A limit and fault indicator | 2 | U21, U25 | AP22811AW5-7 | Diodes Incorporated
IC CONTROLLER USB RTS5420-GR QFN88 USB 3.2 GEN2 HUB 4-PORT | 1 | U7 | RTS5420-GR | Realtek Semiconductor Corp.
IC SERIAL FLASH 104MHz SO8 W25Q20CLSNIG DUAL BANK 2M-bit 3.3V | 1 | U28 | W25Q20CLSNIG | Winbond Electronics Corporation
RES 0402 100kohm 1% 62.5mW | 2 | R36, R38 | ERJ2RKF1003X | Matsushita Electric Works, Ltd.
 |  |  | WR04X1003FTL | Walsin Technology Corporation USA
 |  |  | TFGL0402R1003F-T10 | Thin Film Technology Corporation
 |  |  | RC1005F104CS | SAMSUNG ELECTRONICS CO., LTD.
 |  |  | RC0402FR-07100KL | Yageo Corporation
 |  |  | NRC04F1003TRF | NIC COMPONENTS CORP.
 |  |  | CRCW0402100KFKED | Vishay Americas Inc.
 |  |  | MCR01SMQPF1003 | ROHM Co., Ltd.
 |  |  | RTT021003FTH | RALEC ELEC
 |  |  | RK73H1ETTP1003F | KOA Speer Electronics, Inc.
RES 0402 6.19kohm 1% 62.5mW | 1 | R35 | TFGL0402R6191F-T10 | Thin Film Technology Corporation
 |  |  | RK73H1ETTP6191F | KOA Speer Electronics, Inc.
 |  |  | NRC04F6191TRF | NIC COMPONENTS CORP.
 |  |  | RTT026191FTH | RALEC ELEC
 |  |  | ERJ2RKF6191X | Matsushita Electric Works, Ltd.
 |  |  | MCR01SMQPF6191 | ROHM Co., Ltd.
 |  |  | RC1005F6191CS | SAMSUNG ELECTRONICS CO., LTD.
 |  |  | CRCW04026K19FKED | Vishay Americas Inc.
 |  |  | RC0402FR-076K19L | Yageo Corporation
 |  |  | WR04X6191FTL | Walsin Technology Corporation USA
RES 0402 10kohm 5% 62.5mW | 6 | R40, R201, R200, R37, R174, R199 | NRC04J103TRF | NIC COMPONENTS CORP.
 |  |  | MCR01SMQPJ103 | ROHM Co., Ltd.
 |  |  | RTT02103JTH | RALEC ELEC
 |  |  | RK73B1ETTP103J | KOA Speer Electronics, Inc.
 |  |  | RC0402JR-0710KL | Yageo Corporation
 |  |  | WR04X103 JTL | Walsin Technology Corporation USA
 |  |  | RC1005J103CS | SAMSUNG ELECTRONICS CO., LTD.
 |  |  | CRCW040210K0JNED | Vishay Americas Inc.
 |  |  | TFGL0402R1002J-T10 | Thin Film Technology Corporation
 |  |  | ERJ2GEJ103X | Panasonic Electronic Devices Co., Ltd.
RES SCD 0402 0 OHM 1AMP | 24 | R169, R206, R219, R215, R220, R207, R212, R41, R217, R216, R44, R46, R167, R209, R221, R211, R47, R210, R214, R42, R45, R208, R213, R218 | RTT02000JTH | RALEC ELEC
 |  |  | RC1005J000CS | SAMSUNG
 |  |  | WR04X000PTL | Walsin Technology Corporation USA
 |  |  | ERJ2GE0R00X | Panasonic Electric Works Co. Ltd.
 |  |  | TFGL0402WJUMPF-T10 | Thin Film Technology Corporation
