nikolozka/Fibel2/Fib2_Docs/E-Ink/EPDiy/epdiy-v7_schematic.pdf

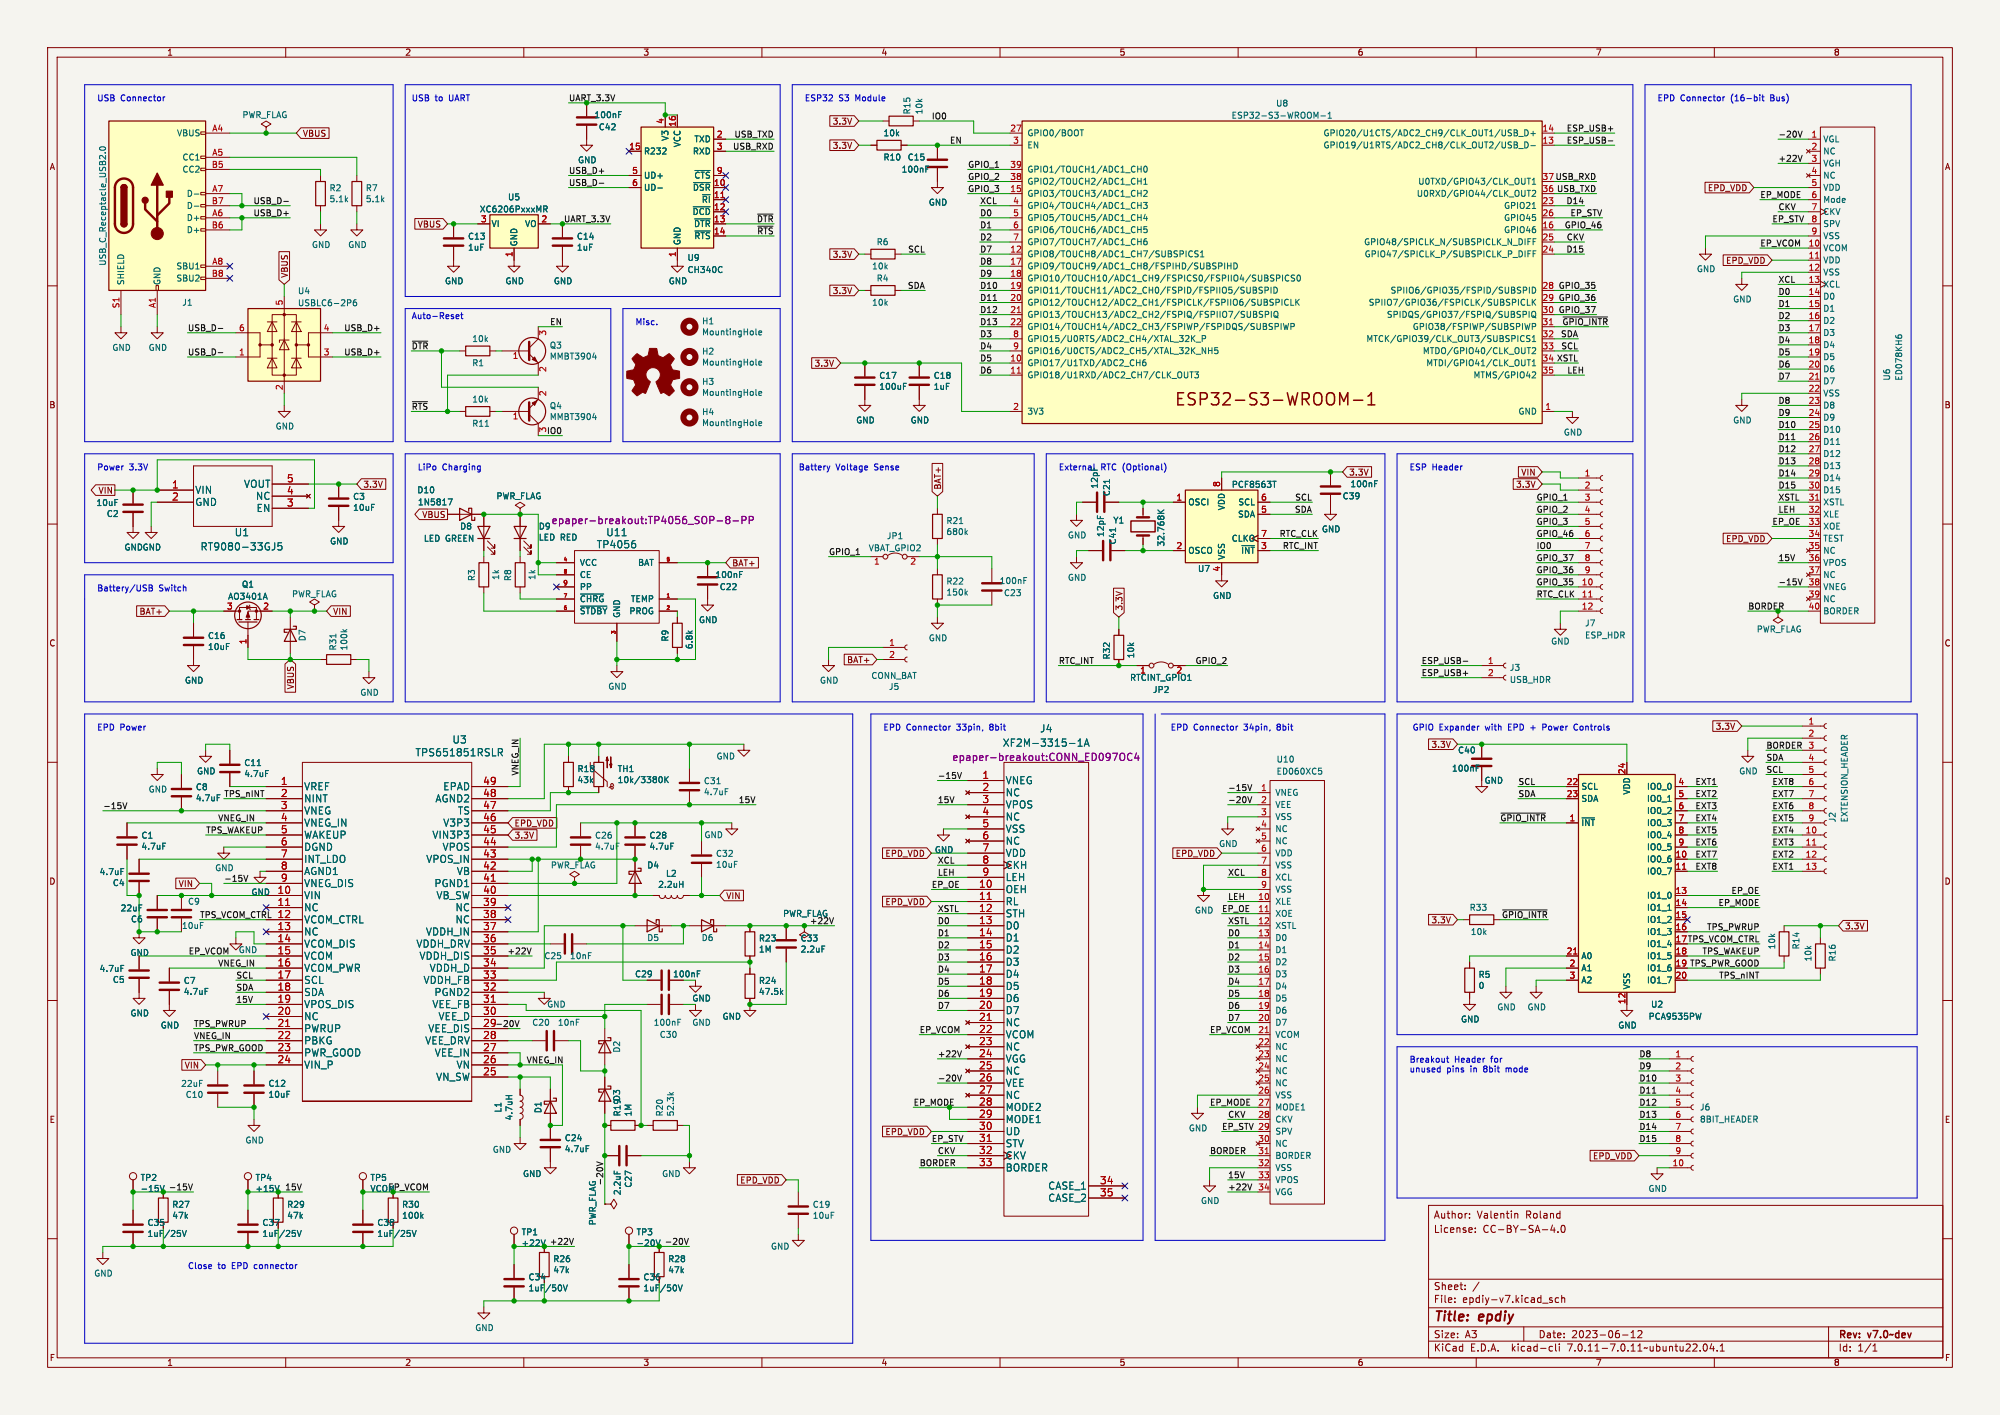
[picture p2: page 1]

1 ~{DSR} 10 ~{RI} 11 ~{DCD} 12 ~{DTR} 13 ~{RTS} 14 R232 15 VCC 16 TXD 2 RXD 3 V3

4 UD+ 5 UD- 6 ~{CTS}9 U9 CH340C GND R32 10k

4 UD+ 5 UD- 6 ~{CTS}9 GND

4 SDA 5 SCL 6 CLKO 7 VDD

3 VCC 4 BAT 5 ~{STDBY} 6 ~{CHRG} 7 CE 8 PP 9 D9

3 VCC 4 BAT 5 ~{STDBY} 6 ~{CHRG} 7 CE 8 PP 9 U11 TP4056

Close to EPD connector
