nikolozka/Fibel2/Fib2_Docs/E-Ink/6inch-e-Paper-Adapter-Schematic.pdf

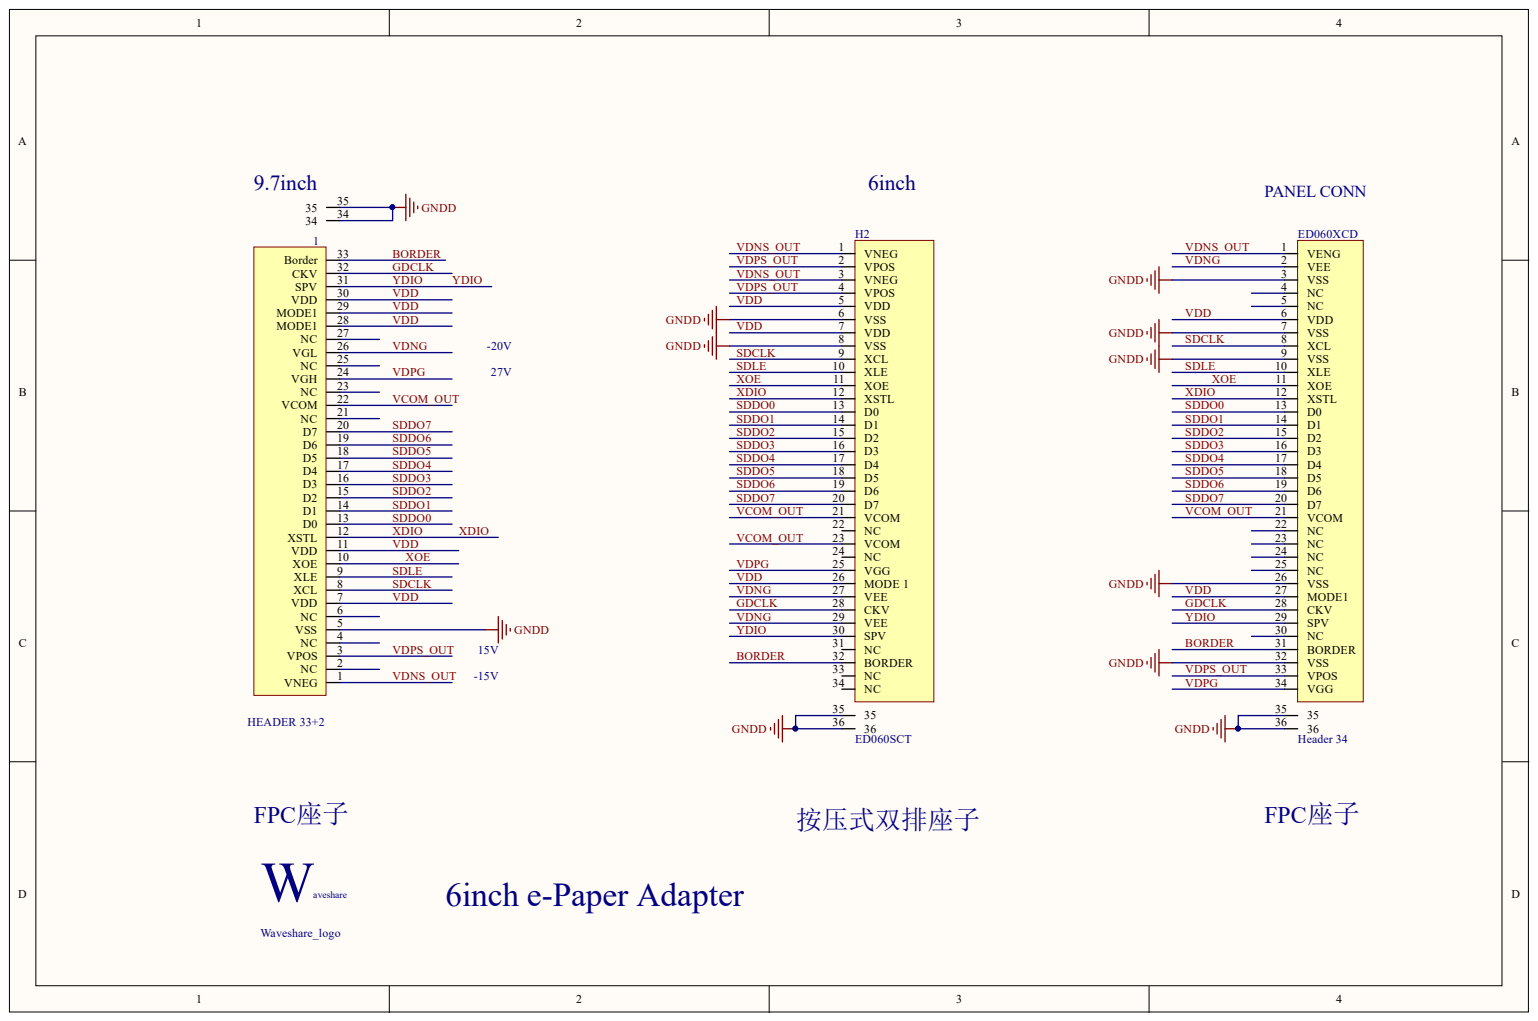
[picture p3: page 1]
