nikolozka/Fibel2/Fibel2.kicad_pcb

## KiCad design Fibel2.kicad_pcb (2024-07-19)

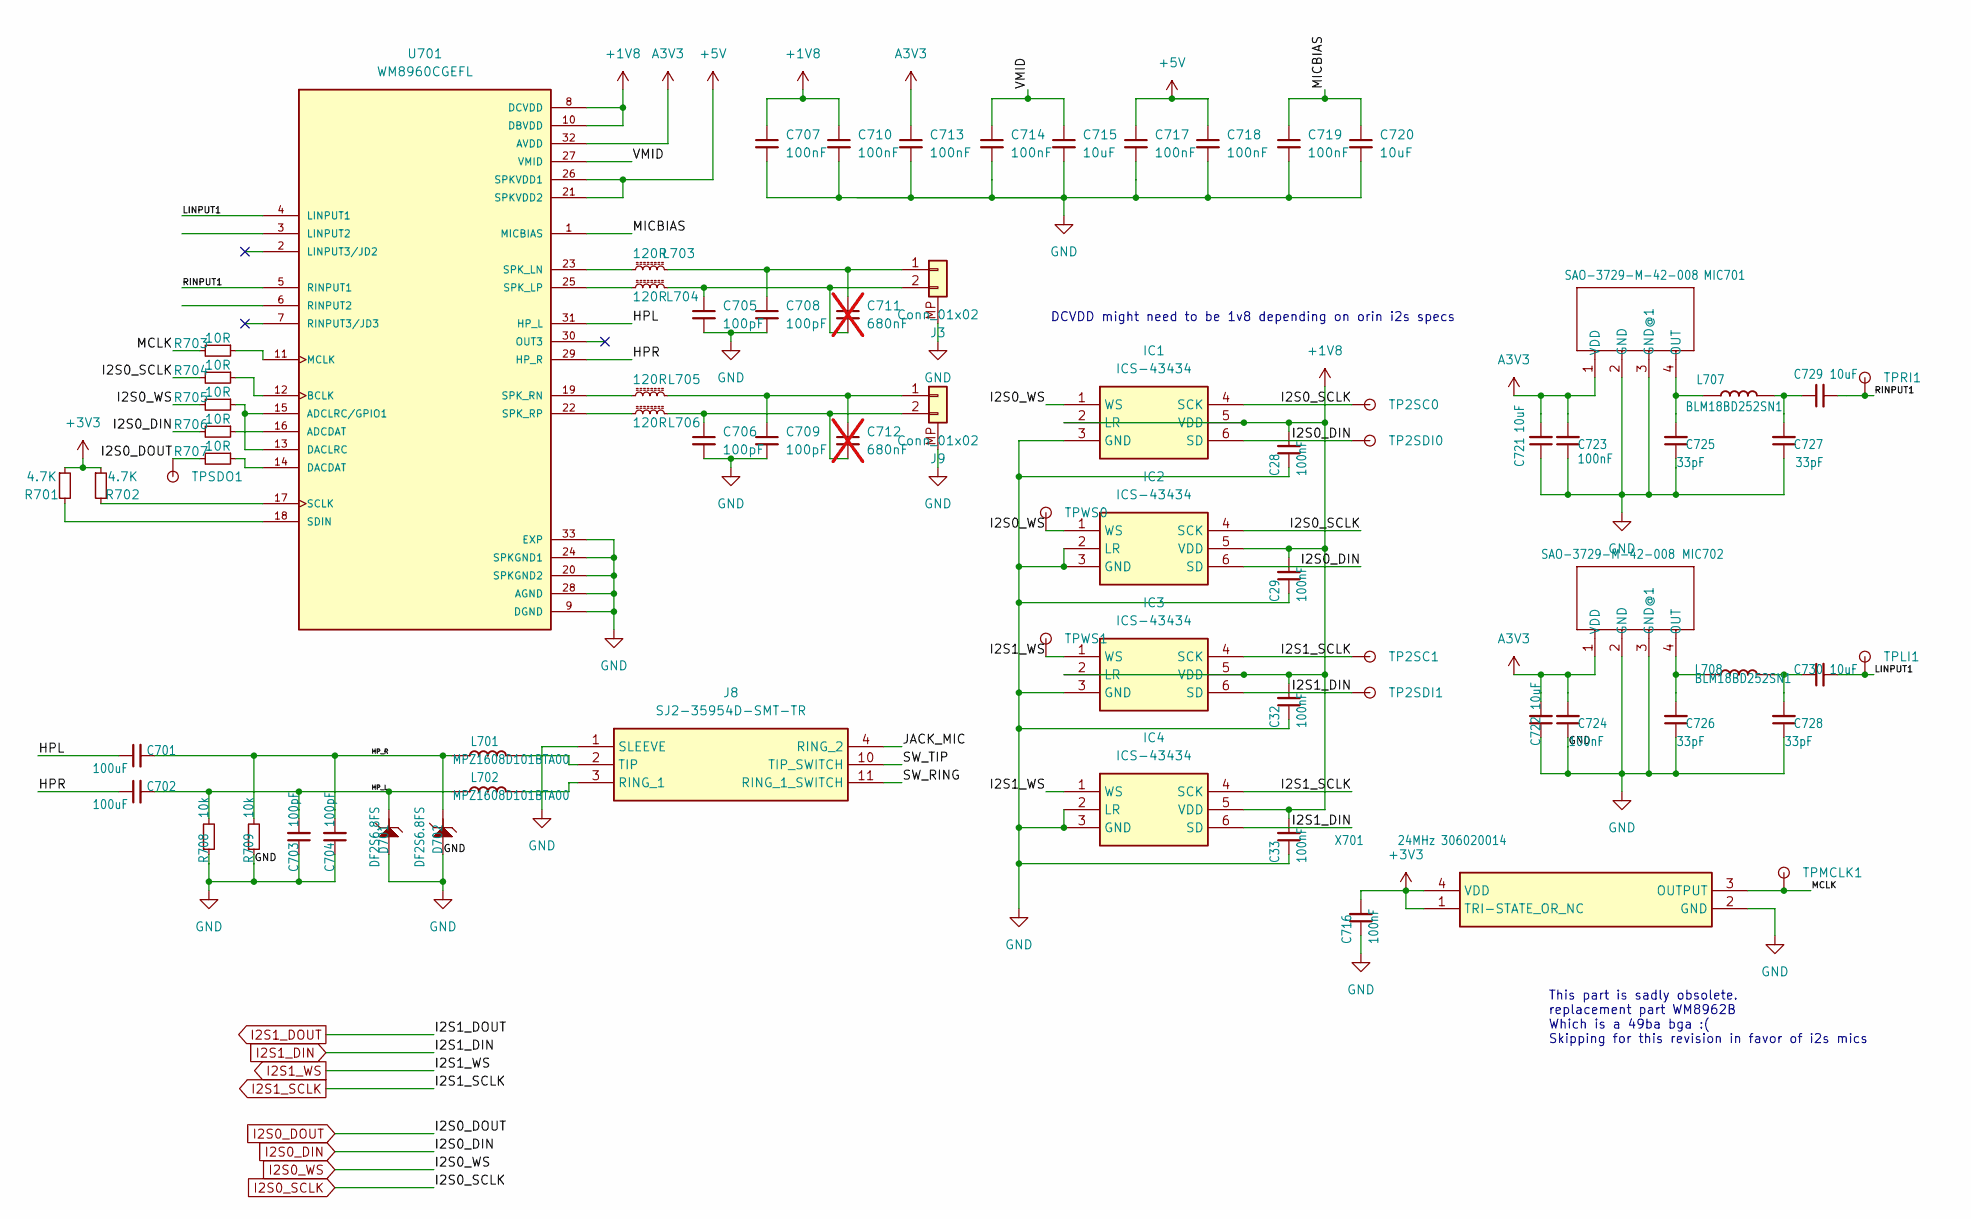
[picture p4: schematic fib_audio.kicad_sch]

Parts:
C28, C29, C32, C33, C707, C710, C713, C714, C716, C717, C718, C719, C723, C724: 100nF; C_0402_1005Metric
C701, C702: 100uF; C_0805_2012Metric
C703, C704, C705, C706, C708, C709: 100pF; C_0402_1005Metric
C711, C712: 680nF; C_0402_1005Metric; not fitted
C715, C720, C721, C722, C729, C730: 10uF; C_0603_1608Metric
C725, C726, C727, C728: 33pF; C_0402_1005Metric
D701, D702: DF2S6.8FS; D_SOD-923
IC1, IC2, IC3, IC4: ICS-43434; ICS43434; Mouser Part Number 410-ICS-43434
J3, J9: Conn_01x02; JST_PH_S2B-PH-SM4-TB_1x02-1MP_P2.00mm_Horizontal
J8: SJ2-35954D-SMT-TR; SJ235954DSMTTR; Mouser Part Number 490-SJ2-35954DSMT-TR
L701, L702: MPZ1608D101BTA00; L_0603_1608Metric
L703, L704, L705, L706: 120R; L_0603_1608Metric
L707, L708: BLM18BD252SN1; L_0603_1608Metric
MIC701, MIC702: SAO-3729-M-42-008; MIC_Respeaker
R701, R702: 4.7K; R_0402_1005Metric
R703, R704, R705, R706, R707: 10R; R_0402_1005Metric
R708, R709: 10k; R_0402_1005Metric
TP2SC0, TP2SC1, TP2SDI0, TP2SDI1: TestPoint; TestPoint_Pad_D1.0mm
TPLI1: TestPoint; TestPoint_Pad_D1.0mm
TPMCLK1: TestPoint; TestPoint_Pad_D1.0mm
TPRI1: TestPoint; TestPoint_Pad_D1.0mm
TPSDO1: TestPoint; TestPoint_Pad_D1.0mm
TPWS0, TPWS1: TestPoint; TestPoint_Pad_D1.0mm
U701: WM8960CGEFL; QFN50P500X500X100-33N
X701: 24MHz 306020014; ECS2520MV; Mouser Part Number 520-327ATQ2520MVBSTR

Connections:
+1V8: C28.2, C29.2, C32.2, C33.2, C707.1, C710.1, IC1.2 (LR), IC1.5 (VDD), IC2.5 (VDD), IC3.2 (LR), IC3.5 (VDD), IC4.5 (VDD), U701.8 (DCVDD), U701.10 (DBVDD); also elsewhere on the board
+3V3: C716.2, R701.1, R702.1, X701.1 (TRI-STATE_OR_NC), X701.4 (VDD); also elsewhere on the board
+5V: C717.1, C718.1, U701.21 (SPKVDD2), U701.26 (SPKVDD1); also elsewhere on the board
/Audio/HPL: C701.1, U701.31 (HP_L)
/Audio/HPR: C702.1, U701.29 (HP_R)
/Audio/HP_L: C702.2, C703.2, D701.1 (2), L702.1, R708.2
/Audio/HP_R: C701.2, C704.2, D702.1 (2), L701.1, R709.2
/Audio/JACK_MIC: J8.4 (RING_2)
/Audio/LINPUT1: C730.2, TPLI1.1, U701.4 (LINPUT1)
/Audio/MCLK: R703.2, TPMCLK1.1, X701.3 (OUTPUT)
/Audio/MICBIAS: C719.1, C720.1, U701.1 (MICBIAS)
/Audio/RINPUT1: C729.2, TPRI1.1, U701.5 (RINPUT1)
/Audio/SW_RING: J8.11 (RING_1_SWITCH)
/Audio/SW_TIP: J8.10 (TIP_SWITCH)
/Audio/VMID: C714.1, C715.1, U701.27 (VMID)
A3V3: C713.1, C721.2, C722.2, C723.2, C724.2, MIC701.1 (VDD), MIC702.1 (VDD), U701.32 (AVDD); also elsewhere on the board
GND: C28.1, C29.1, C32.1, C33.1, C703.1, C704.1, C705.2, C706.2, C707.2, C708.2, C709.2, C710.2, C713.2, C714.2, C715.2, C716.1, C717.2, C718.2, C719.2, C720.2, C721.1, C722.1, C723.1, C724.1, C725.1, C726.1, C727.1, C728.1, D701.2 (1), D702.2 (1), IC1.3 (GND), IC2.2 (LR), IC2.3 (GND), IC3.3 (GND), IC4.2 (LR), IC4.3 (GND), J3.MP, J8.1 (SLEEVE), J9.MP, MIC701.2 (GND), MIC701.3 (GND@1), MIC702.2 (GND), MIC702.3 (GND@1), R708.1, R709.1, U701.9 (DGND), U701.20 (SPKGND2), U701.24 (SPKGND1), U701.28 (AGND), U701.33 (EXP), X701.2 (GND); also elsewhere on the board
I2S0_DIN: IC1.6 (SD), IC2.6 (SD), R706.2, TP2SDI0.1; also elsewhere on the board
I2S0_DOUT: R707.2, TPSDO1.1; also elsewhere on the board
I2S0_SCLK: IC1.4 (SCK), IC2.4 (SCK), R704.2, TP2SC0.1; also elsewhere on the board
I2S0_WS: IC1.1 (WS), IC2.1 (WS), R705.2, TPWS0.1; also elsewhere on the board
I2S1_DIN: IC3.6 (SD), IC4.6 (SD), TP2SDI1.1; also elsewhere on the board
I2S1_SCLK: IC3.4 (SCK), IC4.4 (SCK), TP2SC1.1; also elsewhere on the board
I2S1_WS: IC3.1 (WS), IC4.1 (WS), TPWS1.1; also elsewhere on the board
unnamed: C727.2, C729.1, L707.2
unnamed: C728.2, C730.1, L708.2
unnamed: C708.1, C711.1, J3.1, L703.2
unnamed: C705.1, C711.2, J3.2, L704.2
unnamed: J8.3 (RING_1), L702.2
unnamed: J8.2 (TIP), L701.2
unnamed: C709.1, C712.1, J9.1, L705.2
unnamed: C706.1, C712.2, J9.2, L706.2
unnamed: C725.2, L707.1, MIC701.4 (OUT)
unnamed: C726.2, L708.1, MIC702.4 (OUT)
unnamed: R706.1, U701.16 (ADCDAT)
unnamed: R705.1, U701.13 (DACLRC), U701.15 (ADCLRC/GPIO1)
unnamed: R704.1, U701.12 (BCLK)
unnamed: R707.1, U701.14 (DACDAT)
unnamed: R703.1, U701.11 (MCLK)
unnamed: R702.2, U701.17 (SCLK)
unnamed: R701.2, U701.18 (SDIN)
unnamed: L703.1, U701.23 (SPK_LN)
unnamed: L704.1, U701.25 (SPK_LP)
unnamed: L705.1, U701.19 (SPK_RN)
unnamed: L706.1, U701.22 (SPK_RP)

Notes on the sheet:
DCVDD might need to be 1v8 depending on orin i2s specs
This part is sadly obsolete. replacement part WM8962B Which is a 49ba bga :( Skipping for this revision in favor of i2s mics

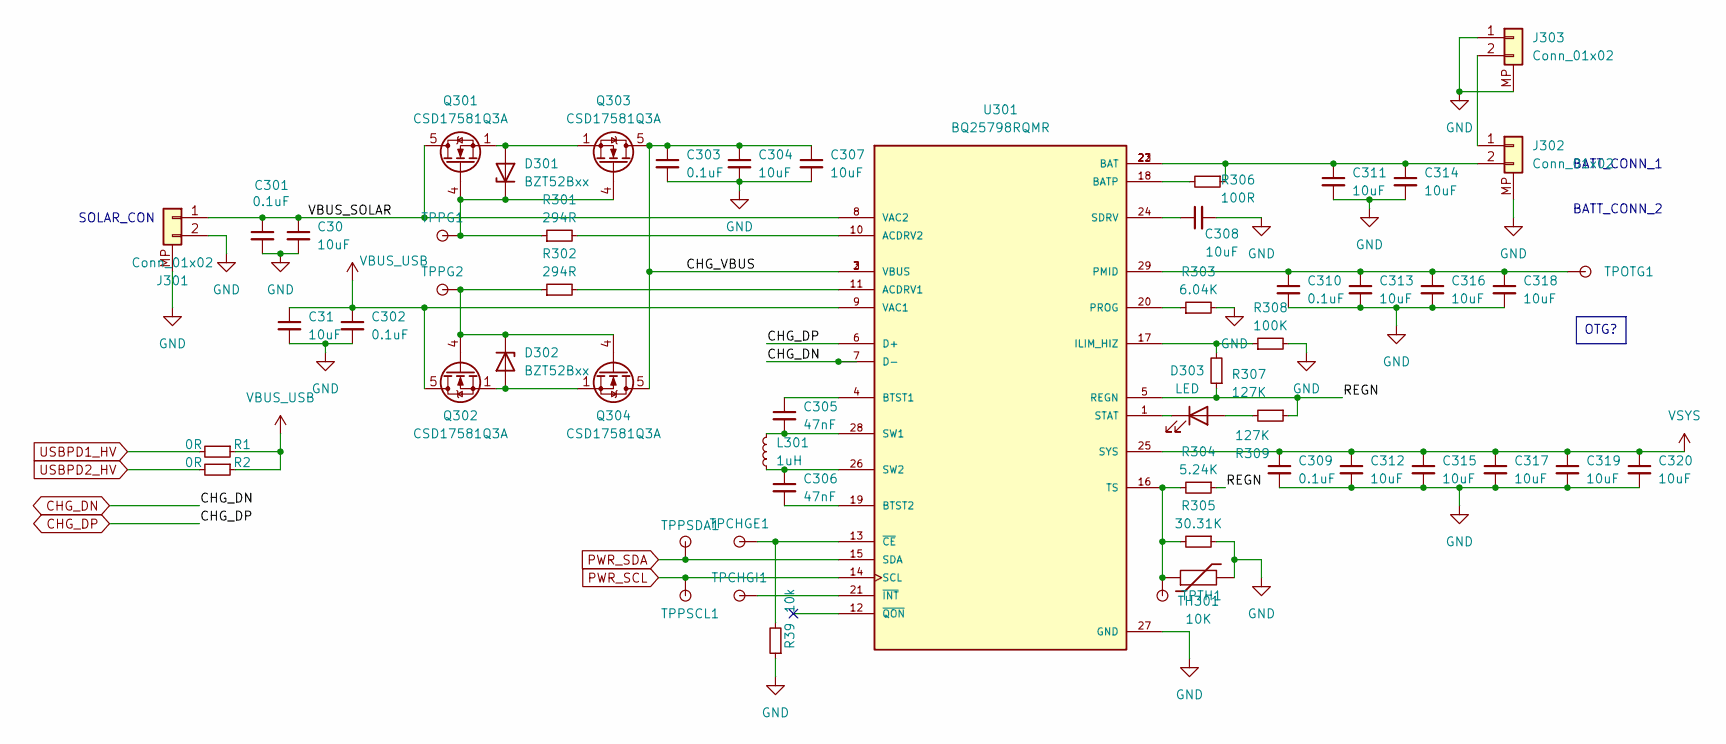
[picture p5: schematic fib_charging.kicad_sch]

Parts:
C30, C31, C304, C307, C308, C311, C312, C313, C314, C315, C316, C317, C318, C319, C320: 10uF; C_0603_1608Metric
C301, C302, C303, C309, C310: 0.1uF; C_0402_1005Metric
C305, C306: 47nF; C_0402_1005Metric
D301, D302: BZT52Bxx; D_SOD-123F
D303: LED; LED_0603_1608Metric
J301, J302, J303: Conn_01x02; JST_PH_S2B-PH-SM4-TB_1x02-1MP_P2.00mm_Horizontal
L301: 1uH; SPM6530
Q301, Q302, Q303, Q304: CSD17581Q3A; VSON-8_3.3x3.3mm_P0.65mm_NexFET
R1, R2: 0R; R_0603_1608Metric
R39: 10K; R_0402_1005Metric; Tolerance 1%; MPN CR0402-FX-1002GLF
R301, R302: 294R; R_0402_1005Metric
R303: 6.04K; R_0402_1005Metric
R304: 5.24K; R_0402_1005Metric
R305: 30.31K; R_0402_1005Metric
R306: 100R; R_0402_1005Metric
R307, R309: 127K; R_0402_1005Metric
R308: 100K; R_0402_1005Metric
TH301: 10K; R_0402_1005Metric
TPCHGE1: TestPoint; TestPoint_Pad_D1.0mm
TPCHGI1: TestPoint; TestPoint_Pad_D1.0mm
TPOTG1: TestPoint; TestPoint_Pad_D1.0mm
TPPG1, TPPG2: TestPoint; TestPoint_Pad_D1.0mm
TPPSCL1: TestPoint; TestPoint_Pad_D1.0mm
TPPSDA1: TestPoint; TestPoint_Pad_D1.0mm
TPTH1: TestPoint; TestPoint_Pad_D1.0mm
U301: BQ25798RQMR; IBQ25798RQMR

Connections:
/Charging/CHG_VBUS: C303.1, C304.1, C307.1, Q303.5 (D), Q304.5 (D), U301.2 (VBUS), U301.3 (VBUS)
/Charging/REGN: R304.1, R307.1, R309.1, U301.5 (REGN)
/Charging/VBUS_SOLAR: C30.1, C301.1, J301.1, Q301.5 (D), U301.8 (VAC2)
CHG_DN: U301.7 (D-); also elsewhere on the board
CHG_DP: U301.6 (D+); also elsewhere on the board
GND: C30.2, C31.2, C301.2, C302.2, C303.2, C304.2, C307.2, C308.2, C309.2, C310.2, C311.2, C312.2, C313.2, C314.2, C315.2, C316.2, C317.2, C318.2, C319.2, C320.2, J301.2, J301.MP, J302.MP, J303.1, J303.MP, R39.1, R303.2, R305.1, R308.2, TH301.2, U301.27 (GND); also elsewhere on the board
unnamed: D301.2 (A), Q301.1 (S), Q301.2 (S), Q301.3 (S), Q303.1 (S), Q303.2 (S), Q303.3 (S)
unnamed: D301.1 (K), Q301.4 (G), Q303.4 (G), R301.1, TPPG1.1
unnamed: D302.2 (A), Q302.1 (S), Q302.2 (S), Q302.3 (S), Q304.1 (S), Q304.2 (S), Q304.3 (S)
unnamed: D302.1 (K), Q302.4 (G), Q304.4 (G), R302.1, TPPG2.1
unnamed: D303.2 (A), R309.2
unnamed: D303.1 (K), U301.1 (STAT)
unnamed: J302.1, J303.2
unnamed: C311.1, C314.1, J302.2, R306.1, U301.22 (BAT), U301.23 (BAT)
unnamed: R302.2, U301.11 (ACDRV1)
unnamed: R301.2, U301.10 (ACDRV2)
unnamed: R306.2, U301.18 (BATP)
unnamed: C305.1, U301.4 (BTST1)
unnamed: C306.2, U301.19 (BTST2)
unnamed: R307.2, R308.1, U301.17 (ILIM_HIZ)
unnamed: C310.1, C313.1, C316.1, C318.1, TPOTG1.1, U301.29 (PMID)
unnamed: R303.1, U301.20 (PROG)
unnamed: C308.1, U301.24 (SDRV)
unnamed: C305.2, L301.2, U301.28 (SW1)
unnamed: C306.1, L301.1, U301.26 (SW2)
unnamed: R304.2, R305.2, TH301.1, TPTH1.1, U301.16 (TS)
unnamed: R39.2, TPCHGE1.1, U301.13 (~CE)
unnamed: TPCHGI1.1, U301.21 (~INT)
PWR_SCL: TPPSCL1.1, U301.14 (SCL); also elsewhere on the board
PWR_SDA: TPPSDA1.1, U301.15 (SDA); also elsewhere on the board
USBPD1_HV: R1.2; also elsewhere on the board
USBPD2_HV: R2.2; also elsewhere on the board
VBUS_USB: C31.1, C302.1, Q302.5 (D), R1.1, R2.1, U301.9 (VAC1); also elsewhere on the board
VSYS: C309.1, C312.1, C315.1, C317.1, C319.1, C320.1, U301.25 (SYS); also elsewhere on the board

Notes on the sheet:
OTG?
BATT_CONN_2
SOLAR_CON
BATT_CONN_1

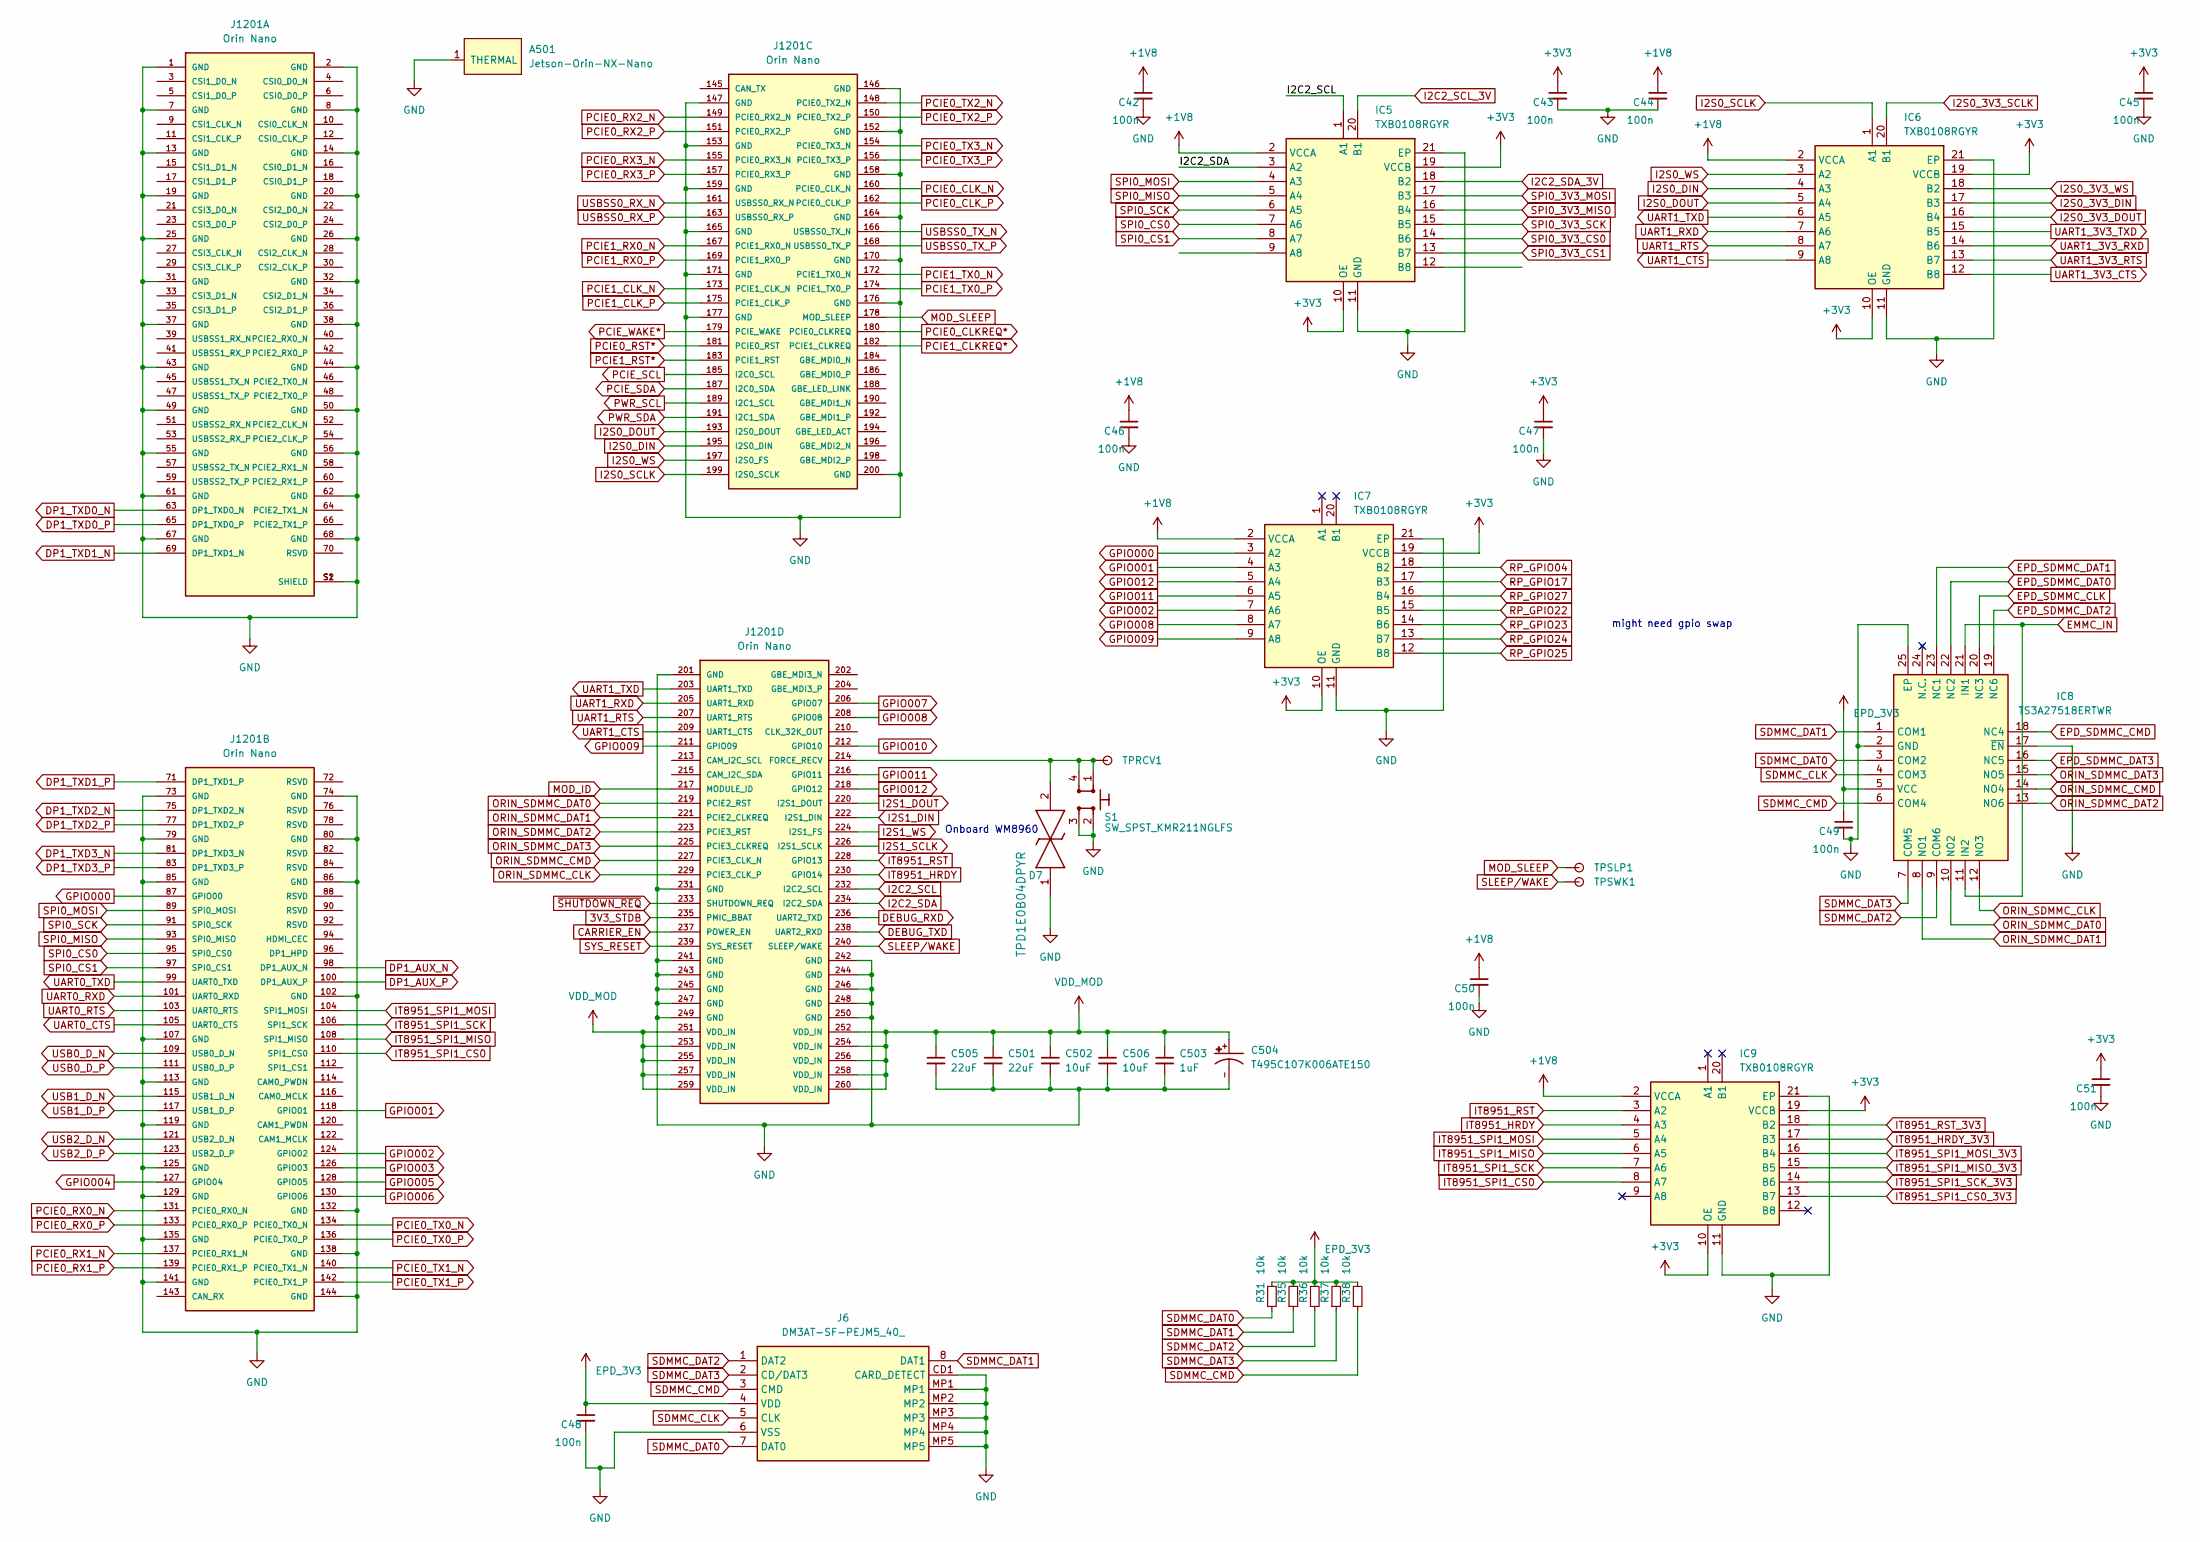
[picture p6: schematic fib_orin.kicad_sch]

Parts:
A501: Jetson-Orin-NX-Nano; jetson-orin-nx-nano-module; MPN 900-13767-0000-000
C42, C43, C44, C45, C46, C47, C48, C49, C50, C51: 100nF; C_0402_1005Metric; Voltage 50V; MPN GRM155R61H104KE14D
C501, C505: 22uF; C_0805_2012Metric
C502, C506: 10uF; C_0603_1608Metric
C503: 1uF; C_0402_1005Metric
C504: T495C107K006ATE150; CAPMP6032X250
D7: TPD1E0B04_XDFN-2; TPD1E0B04DPYT; MPN TPD1E0B04DPYR; Mouser Part Number 595-TPD1E0B04DPYT
IC5, IC6, IC7, IC9: TXB0108RGYR; TXB0108; Mouser Part Number 595-TXB0108RGYR
IC8: TS3A27518ERTWR; QFN50P400X400X80-25N; Mouser Part Number 595-TS3A27518ERTWR
J6: DM3AT-SF-PEJM5_40_; DM3ATSFPEJM540; Mouser Part Number 798-DM3AT-SF-PEJM540
J1201: Orin Nano; SODIMM_REVERSED
R31, R35, R36, R37, R38: 10K; R_0402_1005Metric; Tolerance 1%; MPN CR0402-FX-1002GLF
S1: SW_SPST_KMR211NGLFS; KMR211NGLFS; MPN KMR211NGLFS
TPRCV1: TestPoint; TestPoint_Pad_D1.0mm
TPSLP1: TestPoint; TestPoint_Pad_D1.0mm
TPSWK1: TestPoint; TestPoint_Pad_D1.0mm

Connections:
3V3_STDB: J1201.235 (PMIC_BBAT); also elsewhere on the board
+1V8: C42.1, C44.1, C46.1, C50.1, IC5.2 (VCCA), IC6.2 (VCCA), IC7.2 (VCCA), IC9.2 (VCCA); also elsewhere on the board
+3V3: C43.1, C45.1, C47.1, C51.1, IC5.10 (OE), IC5.19 (VCCB), IC6.10 (OE), IC6.19 (VCCB), IC7.10 (OE), IC7.19 (VCCB), IC9.10 (OE), IC9.19 (VCCB); also elsewhere on the board
CARRIER_EN: J1201.237 (POWER_EN); also elsewhere on the board
DEBUG_RXD: J1201.236 (UART2_TXD); also elsewhere on the board
DEBUG_TXD: J1201.238 (UART2_RXD); also elsewhere on the board
DP1_AUX_N: J1201.98 (DP1_AUX_N); also elsewhere on the board
DP1_AUX_P: J1201.100 (DP1_AUX_P); also elsewhere on the board
DP1_TXD0_N: J1201.63 (DP1_TXD0_N); also elsewhere on the board
DP1_TXD0_P: J1201.65 (DP1_TXD0_P); also elsewhere on the board
DP1_TXD1_N: J1201.69 (DP1_TXD1_N); also elsewhere on the board
DP1_TXD1_P: J1201.71 (DP1_TXD1_P); also elsewhere on the board
DP1_TXD2_N: J1201.75 (DP1_TXD2_N); also elsewhere on the board
DP1_TXD2_P: J1201.77 (DP1_TXD2_P); also elsewhere on the board
DP1_TXD3_N: J1201.81 (DP1_TXD3_N); also elsewhere on the board
DP1_TXD3_P: J1201.83 (DP1_TXD3_P); also elsewhere on the board
EMMC_IN: IC8.11 (IN2), IC8.21 (IN1); also elsewhere on the board
EPD_3V3: C48.1, C49.1, IC8.5 (VCC), J6.4 (VDD), R31.2, R35.2, R36.2, R37.2, R38.2; also elsewhere on the board
EPD_SDMMC_CLK: IC8.20 (NC3); also elsewhere on the board
EPD_SDMMC_CMD: IC8.18 (NC4); also elsewhere on the board
EPD_SDMMC_DAT0: IC8.22 (NC2); also elsewhere on the board
EPD_SDMMC_DAT1: IC8.23 (NC1); also elsewhere on the board
EPD_SDMMC_DAT2: IC8.19 (NC6); also elsewhere on the board
EPD_SDMMC_DAT3: IC8.16 (NC5); also elsewhere on the board
GND: A501.1 (THERMAL), C42.2, C43.2, C44.2, C45.2, C46.2, C47.2, C48.2, C49.2, C50.2, C51.2, C501.2, C502.2, C503.2, C504.-, C505.2, C506.2, D7.1, IC5.11 (GND), IC5.21 (EP), IC6.11 (GND), IC6.21 (EP), IC7.11 (GND), IC7.21 (EP), IC8.2 (GND), IC8.17 (~EN), IC8.25 (EP), IC9.11 (GND), IC9.21 (EP), J6.6 (VSS), J6.CD1 (CARD_DETECT), J6.MP1, J6.MP2, J6.MP3, J6.MP4, J6.MP5, J1201.1 (GND), J1201.2 (GND), J1201.7 (GND), J1201.8 (GND), J1201.13 (GND), J1201.14 (GND), J1201.19 (GND), J1201.20 (GND), J1201.25 (GND), J1201.26 (GND), J1201.31 (GND), J1201.32 (GND), J1201.37 (GND), J1201.38 (GND), J1201.43 (GND), J1201.44 (GND), J1201.49 (GND), J1201.50 (GND), J1201.55 (GND), J1201.56 (GND), J1201.61 (GND), J1201.62 (GND), J1201.67 (GND), J1201.68 (GND), J1201.73 (GND), J1201.74 (GND), J1201.79 (GND), J1201.80 (GND), J1201.85 (GND), J1201.86 (GND), J1201.102 (GND), J1201.107 (GND), J1201.113 (GND), J1201.119 (GND), J1201.125 (GND), J1201.129 (GND), J1201.132 (GND), J1201.135 (GND), J1201.138 (GND), J1201.141 (GND), J1201.144 (GND), J1201.146 (GND), J1201.147 (GND), J1201.152 (GND), J1201.153 (GND), J1201.158 (GND), J1201.159 (GND), J1201.164 (GND), J1201.165 (GND), J1201.170 (GND), J1201.171 (GND), J1201.176 (GND), J1201.177 (GND), J1201.200 (GND), J1201.201 (GND), J1201.231 (GND), J1201.241 (GND), J1201.242 (GND), J1201.243 (GND), J1201.244 (GND), J1201.245 (GND), J1201.246 (GND), J1201.247 (GND), J1201.248 (GND), J1201.249 (GND), J1201.250 (GND), J1201.S1 (SHIELD), J1201.S2 (SHIELD), S1.2, S1.3; also elsewhere on the board
GPIO000: IC7.3 (A2), J1201.87 (GPIO00)
GPIO001: IC7.4 (A3), J1201.118 (GPIO01)
GPIO002: IC7.7 (A6), J1201.124 (GPIO02)
GPIO003: J1201.126 (GPIO03); also elsewhere on the board
GPIO004: J1201.127 (GPIO04)
GPIO005: J1201.128 (GPIO05); also elsewhere on the board
GPIO006: J1201.130 (GPIO06); also elsewhere on the board
GPIO007: J1201.206 (GPIO07); also elsewhere on the board
GPIO008: IC7.8 (A7), J1201.208 (GPIO08)
GPIO009: IC7.9 (A8), J1201.211 (GPIO09)
GPIO010: J1201.212 (GPIO10); also elsewhere on the board
GPIO011: IC7.6 (A5), J1201.216 (GPIO11)
GPIO012: IC7.5 (A4), J1201.218 (GPIO12)
I2C2_SCL: IC5.1 (A1), J1201.232 (I2C2_SCL)
I2C2_SCL_3V: IC5.20 (B1); also elsewhere on the board
I2C2_SDA: IC5.3 (A2), J1201.234 (I2C2_SDA)
I2C2_SDA_3V: IC5.18 (B2); also elsewhere on the board
I2S0_3V3_DIN: IC6.17 (B3); also elsewhere on the board
I2S0_3V3_DOUT: IC6.16 (B4); also elsewhere on the board
I2S0_3V3_SCLK: IC6.20 (B1); also elsewhere on the board
I2S0_3V3_WS: IC6.18 (B2); also elsewhere on the board
I2S0_DIN: IC6.4 (A3), J1201.195 (I2S0_DIN); also elsewhere on the board
I2S0_DOUT: IC6.5 (A4), J1201.193 (I2S0_DOUT); also elsewhere on the board
I2S0_SCLK: IC6.1 (A1), J1201.199 (I2S0_SCLK); also elsewhere on the board
I2S0_WS: IC6.3 (A2), J1201.197 (I2S0_FS); also elsewhere on the board
I2S1_DIN: J1201.222 (I2S1_DIN); also elsewhere on the board
I2S1_DOUT: J1201.220 (I2S1_DOUT); also elsewhere on the board
I2S1_SCLK: J1201.226 (I2S1_SCLK); also elsewhere on the board
I2S1_WS: J1201.224 (I2S1_FS); also elsewhere on the board
IT8951_HRDY: IC9.4 (A3), J1201.230 (GPIO14)
IT8951_HRDY_3V3: IC9.17 (B3); also elsewhere on the board
IT8951_RST: IC9.3 (A2), J1201.228 (GPIO13)
IT8951_RST_3V3: IC9.18 (B2); also elsewhere on the board
IT8951_SPI1_CS0: IC9.8 (A7), J1201.110 (SPI1_CS0)
IT8951_SPI1_CS0_3V3: IC9.13 (B7); also elsewhere on the board
IT8951_SPI1_MISO: IC9.6 (A5), J1201.108 (SPI1_MISO)
IT8951_SPI1_MISO_3V3: IC9.15 (B5); also elsewhere on the board
IT8951_SPI1_MOSI: IC9.5 (A4), J1201.104 (SPI1_MOSI)
IT8951_SPI1_MOSI_3V3: IC9.16 (B4); also elsewhere on the board
IT8951_SPI1_SCK: IC9.7 (A6), J1201.106 (SPI1_SCK)
IT8951_SPI1_SCK_3V3: IC9.14 (B6); also elsewhere on the board
MOD_ID: J1201.217 (MODULE_ID)
MOD_SLEEP: J1201.178 (MOD_SLEEP), TPSLP1.1
unnamed: D7.2, J1201.214 (FORCE_RECV), S1.1, S1.4, TPRCV1.1
ORIN_SDMMC_CLK: IC8.12 (NO3), J1201.229 (PCIE3_CLK_P)
ORIN_SDMMC_CMD: IC8.14 (NO4), J1201.227 (PCIE3_CLK_N)
ORIN_SDMMC_DAT0: IC8.10 (NO2), J1201.219 (PCIE2_RST)
ORIN_SDMMC_DAT1: IC8.8 (NO1), J1201.221 (PCIE2_CLKREQ)
ORIN_SDMMC_DAT2: IC8.13 (NO6), J1201.223 (PCIE3_RST)
ORIN_SDMMC_DAT3: IC8.15 (NO5), J1201.225 (PCIE3_CLKREQ)
PCIE0_CLKREQ*: J1201.180 (PCIE0_CLKREQ); also elsewhere on the board
PCIE0_CLK_N: J1201.160 (PCIE0_CLK_N); also elsewhere on the board
PCIE0_CLK_P: J1201.162 (PCIE0_CLK_P); also elsewhere on the board
PCIE0_RST*: J1201.181 (PCIE0_RST); also elsewhere on the board
PCIE0_RX0_N: J1201.131 (PCIE0_RX0_N); also elsewhere on the board
PCIE0_RX0_P: J1201.133 (PCIE0_RX0_P); also elsewhere on the board
PCIE0_RX1_N: J1201.137 (PCIE0_RX1_N); also elsewhere on the board
PCIE0_RX1_P: J1201.139 (PCIE0_RX1_P); also elsewhere on the board
PCIE0_RX2_N: J1201.149 (PCIE0_RX2_N); also elsewhere on the board
PCIE0_RX2_P: J1201.151 (PCIE0_RX2_P); also elsewhere on the board
PCIE0_RX3_N: J1201.155 (PCIE0_RX3_N); also elsewhere on the board
PCIE0_RX3_P: J1201.157 (PCIE0_RX3_P); also elsewhere on the board
PCIE0_TX0_N: J1201.134 (PCIE0_TX0_N); also elsewhere on the board
PCIE0_TX0_P: J1201.136 (PCIE0_TX0_P); also elsewhere on the board
PCIE0_TX1_N: J1201.140 (PCIE0_TX1_N); also elsewhere on the board
PCIE0_TX1_P: J1201.142 (PCIE0_TX1_P); also elsewhere on the board
PCIE0_TX2_N: J1201.148 (PCIE0_TX2_N); also elsewhere on the board
PCIE0_TX2_P: J1201.150 (PCIE0_TX2_P); also elsewhere on the board
PCIE0_TX3_N: J1201.154 (PCIE0_TX3_N); also elsewhere on the board
PCIE0_TX3_P: J1201.156 (PCIE0_TX3_P); also elsewhere on the board
PCIE1_CLKREQ*: J1201.182 (PCIE1_CLKREQ); also elsewhere on the board
PCIE1_CLK_N: J1201.173 (PCIE1_CLK_N); also elsewhere on the board
PCIE1_CLK_P: J1201.175 (PCIE1_CLK_P); also elsewhere on the board
PCIE1_RST*: J1201.183 (PCIE1_RST); also elsewhere on the board
PCIE1_RX0_N: J1201.167 (PCIE1_RX0_N); also elsewhere on the board
PCIE1_RX0_P: J1201.169 (PCIE1_RX0_P); also elsewhere on the board
PCIE1_TX0_N: J1201.172 (PCIE1_TX0_N); also elsewhere on the board
PCIE1_TX0_P: J1201.174 (PCIE1_TX0_P); also elsewhere on the board
PCIE_SCL: J1201.185 (I2C0_SCL); also elsewhere on the board
PCIE_SDA: J1201.187 (I2C0_SDA); also elsewhere on the board
PCIE_WAKE*: J1201.179 (PCIE_WAKE); also elsewhere on the board
PWR_SCL: J1201.189 (I2C1_SCL); also elsewhere on the board
PWR_SDA: J1201.191 (I2C1_SDA); also elsewhere on the board
RP_GPIO04: IC7.18 (B2); also elsewhere on the board
RP_GPIO17: IC7.17 (B3); also elsewhere on the board
RP_GPIO22: IC7.15 (B5); also elsewhere on the board
RP_GPIO23: IC7.14 (B6); also elsewhere on the board
RP_GPIO24: IC7.13 (B7); also elsewhere on the board
RP_GPIO25: IC7.12 (B8); also elsewhere on the board
RP_GPIO27: IC7.16 (B4); also elsewhere on the board
SDMMC_CLK: IC8.4 (COM3), J6.5 (CLK)
SDMMC_CMD: IC8.6 (COM4), J6.3 (CMD), R38.1
SDMMC_DAT0: IC8.3 (COM2), J6.7 (DAT0), R31.1
SDMMC_DAT1: IC8.1 (COM1), J6.8 (DAT1), R35.1
SDMMC_DAT2: IC8.9 (COM6), J6.1 (DAT2), R36.1
SDMMC_DAT3: IC8.7 (COM5), J6.2 (CD/DAT3), R37.1
SLEEP/WAKE: J1201.240 (SLEEP/WAKE), TPSWK1.1
SPI0_3V3_CS0: IC5.14 (B6); also elsewhere on the board
SPI0_3V3_CS1: IC5.13 (B7); also elsewhere on the board
SPI0_3V3_MISO: IC5.16 (B4); also elsewhere on the board
SPI0_3V3_MOSI: IC5.17 (B3); also elsewhere on the board
SPI0_3V3_SCK: IC5.15 (B5); also elsewhere on the board
SPI0_CS0: IC5.7 (A6), J1201.95 (SPI0_CS0)
SPI0_CS1: IC5.8 (A7), J1201.97 (SPI0_CS1)
SPI0_MISO: IC5.5 (A4), J1201.93 (SPI0_MISO)
SPI0_MOSI: IC5.4 (A3), J1201.89 (SPI0_MOSI)
SPI0_SCK: IC5.6 (A5), J1201.91 (SPI0_SCK)
SYS_RESET: J1201.239 (SYS_RESET); also elsewhere on the board
UART0_CTS: J1201.105 (UART0_CTS); also elsewhere on the board
UART0_RTS: J1201.103 (UART0_RTS); also elsewhere on the board
UART0_RXD: J1201.101 (UART0_RXD); also elsewhere on the board
UART0_TXD: J1201.99 (UART0_TXD); also elsewhere on the board
UART1_3V3_CTS: IC6.12 (B8); also elsewhere on the board
UART1_3V3_RTS: IC6.13 (B7); also elsewhere on the board
UART1_3V3_RXD: IC6.14 (B6); also elsewhere on the board
UART1_3V3_TXD: IC6.15 (B5); also elsewhere on the board
UART1_CTS: IC6.9 (A8), J1201.209 (UART1_CTS)
UART1_RTS: IC6.8 (A7), J1201.207 (UART1_RTS)
UART1_RXD: IC6.7 (A6), J1201.205 (UART1_RXD)
UART1_TXD: IC6.6 (A5), J1201.203 (UART1_TXD)
USB0_D_N: J1201.109 (USB0_D_N); also elsewhere on the board
USB0_D_P: J1201.111 (USB0_D_P); also elsewhere on the board
USB1_D_N: J1201.115 (USB1_D_N); also elsewhere on the board
USB1_D_P: J1201.117 (USB1_D_P); also elsewhere on the board
USB2_D_N: J1201.121 (USB2_D_N); also elsewhere on the board
USB2_D_P: J1201.123 (USB2_D_P); also elsewhere on the board
USBSS0_RX_N: J1201.161 (USBSS0_RX_N); also elsewhere on the board
USBSS0_RX_P: J1201.163 (USBSS0_RX_P); also elsewhere on the board
USBSS0_TX_N: J1201.166 (USBSS0_TX_N); also elsewhere on the board
USBSS0_TX_P: J1201.168 (USBSS0_TX_P); also elsewhere on the board
VDD_MOD: C501.1, C502.1, C503.1, C504.+, C505.1, C506.1, J1201.251 (VDD_IN), J1201.252 (VDD_IN), J1201.253 (VDD_IN), J1201.254 (VDD_IN), J1201.255 (VDD_IN), J1201.256 (VDD_IN), J1201.257 (VDD_IN), J1201.258 (VDD_IN), J1201.259 (VDD_IN), J1201.260 (VDD_IN); also elsewhere on the board
~SHUTDOWN_REQ: J1201.233 (SHUTDOWN_REQ); also elsewhere on the board

Notes on the sheet:
Onboard WM8960
might need gpio swap
