nikolozka/Fibel2/Fibel2.kicad_pcb

## KiCad design Fibel2.kicad_pcb (continued)

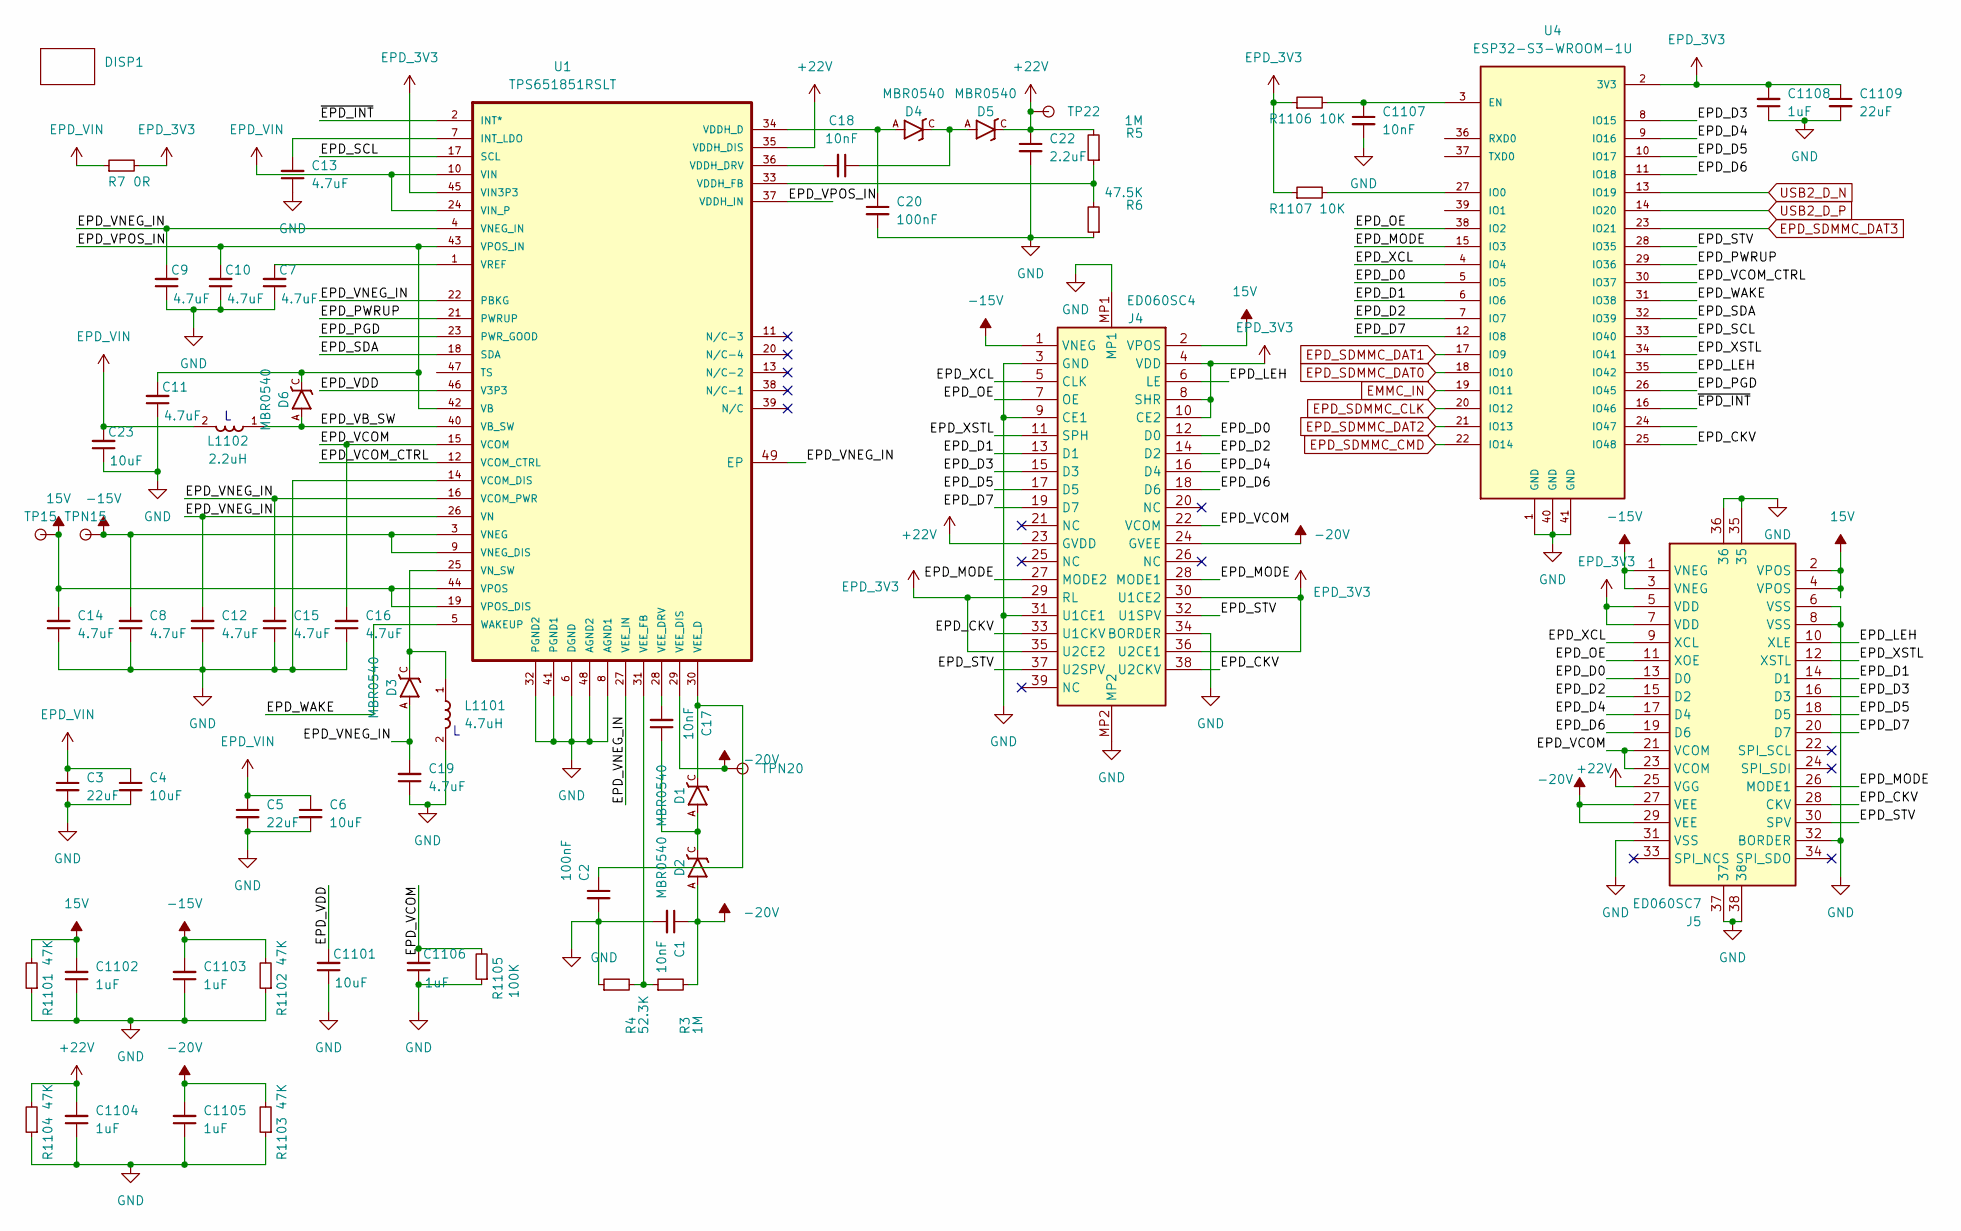
[picture p7: schematic fib_epd.kicad_sch]

Parts:
C1, C17, C18, C1107: 10nF; C_0402_1005Metric
C2, C20: 100nF; C_0402_1005Metric
C3, C5, C1109: 22uF; C_0805_2012Metric
C4, C6, C23: 10uF; C_0603_1608Metric
C7, C8, C9, C10, C11, C12, C13, C14, C15, C16, C19: 4.7uF; C_0402_1005Metric
C22: 2.2uF; C_0402_1005Metric
C1101: 10uF; C_0805_2012Metric
C1102, C1103, C1104, C1105, C1106, C1108: 1uF; C_0805_2012Metric
D1, D2, D3, D4, D5, D6: MBR0540; SOD-123
DISP1: 7.8 EInk
J4: ED060SC4; Mouser Part Number 798-FH26W39S03SHW60
J5: ED060SC7; Mouser Part Number 769-AXT334124
L1101: 4.7uH; IND_LQH5BPB4R7NT0L
L1102: 2.2uH; IND_LQH44PN4R7MP0L
R3, R5: 1M; R_0402_1005Metric
R4: 52.3K; R_0402_1005Metric
R6: 47.5K; R_0402_1005Metric
R7: 0R; R_0603_1608Metric
R1101, R1102, R1103, R1104: 47K; R_0402_1005Metric
R1105: 100K; R_0402_1005Metric
R1106, R1107: 10K; R_0402_1005Metric
TP15, TP22: TestPoint; TestPoint_Pad_D1.0mm
TPN15, TPN20: TestPoint; TestPoint_Pad_D1.0mm
U1: TPS651851RSLT; IC_TPS651851
U4: ESP32-S3-WROOM-1U; XCVR_ESP32-S3-WROOM-1U

Connections:
15V: C14.2, C1102.2, J4.2 (VPOS), J5.2 (VPOS), J5.4 (VPOS), R1101.2, TP15.1, U1.19 (VPOS_DIS), U1.44 (VPOS)
+22V: C22.1, C1104.2, D5.C, J4.23 (GVDD), J5.25 (VGG), R5.2, R1104.2, TP22.1, U1.35 (VDDH_DIS)
-15V: C8.2, C1103.2, J4.1 (VNEG), J5.1 (VNEG), J5.3 (VNEG), R1102.2, TPN15.1, U1.3 (VNEG), U1.9 (VNEG_DIS)
-20V: C1.1, C1105.2, D2.A, J4.24 (GVEE), J5.27 (VEE), J5.29 (VEE), R3.2, R1103.2, TPN20.1, U1.29 (VEE_DIS)
/EPD/EPD_CKV: J4.33 (U1CKV), J4.38 (U2CKV), J5.28 (CKV), U4.25 (IO48)
/EPD/EPD_D0: J4.12 (D0), J5.13 (D0), U4.5 (IO5)
/EPD/EPD_D1: J4.13 (D1), J5.14 (D1), U4.6 (IO6)
/EPD/EPD_D2: J4.14 (D2), J5.15 (D2), U4.7 (IO7)
/EPD/EPD_D3: J4.15 (D3), J5.16 (D3), U4.8 (IO15)
/EPD/EPD_D4: J4.16 (D4), J5.17 (D4), U4.9 (IO16)
/EPD/EPD_D5: J4.17 (D5), J5.18 (D5), U4.10 (IO17)
/EPD/EPD_D6: J4.18 (D6), J5.19 (D6), U4.11 (IO18)
/EPD/EPD_D7: J4.19 (D7), J5.20 (D7), U4.12 (IO8)
/EPD/EPD_LEH: J4.6 (LE), J5.10 (XLE), U4.35 (IO42)
/EPD/EPD_MODE: J4.27 (MODE2), J4.28 (MODE1), J5.26 (MODE1), U4.15 (IO3)
/EPD/EPD_OE: J4.7 (OE), J5.11 (XOE), U4.38 (IO2)
/EPD/EPD_PGD: U1.23 (PWR_GOOD), U4.26 (IO45)
/EPD/EPD_PWRUP: U1.21 (PWRUP), U4.29 (IO36)
/EPD/EPD_SCL: U1.17 (SCL), U4.33 (IO40)
/EPD/EPD_SDA: U1.18 (SDA), U4.32 (IO39)
/EPD/EPD_STV: J4.32 (U1SPV), J4.37 (U2SPV), J5.30 (SPV), U4.28 (IO35)
/EPD/EPD_VB_SW: D6.A, L1102.1, U1.40 (VB_SW)
/EPD/EPD_VCOM: C16.2, C1106.2, J4.22 (VCOM), J5.21 (VCOM), J5.23 (VCOM), R1105.2, U1.15 (VCOM)
/EPD/EPD_VCOM_CTRL: U1.12 (VCOM_CTRL), U4.30 (IO37)
/EPD/EPD_VDD: C1101.2, U1.46 (V3P3)
/EPD/EPD_VNEG_IN: C9.2, C12.2, C15.2, C19.2, D3.A, U1.4 (VNEG_IN), U1.16 (VCOM_PWR), U1.22 (PBKG), U1.26 (VN), U1.27 (VEE_IN), U1.49 (EP)
/EPD/EPD_VPOS_IN: C10.2, C11.2, D6.C, U1.37 (VDDH_IN), U1.42 (VB), U1.43 (VPOS_IN)
/EPD/EPD_WAKE: U1.5 (WAKEUP), U4.31 (IO38)
/EPD/EPD_XCL: J4.5 (CLK), J5.9 (XCL), U4.4 (IO4)
/EPD/EPD_XSTL: J4.11 (SPH), J5.12 (XSTL), U4.34 (IO41)
/EPD/~EPD_INT: U1.2 (INT*), U4.16 (IO46)
EMMC_IN: U4.19 (IO11); also elsewhere on the board
EPD_3V3: C1108.2, C1109.1, J4.4 (VDD), J4.8 (SHR), J4.10 (CE2), J4.29 (RL), J4.30 (U1CE2), J4.35 (U2CE2), J4.36 (U2CE1), J5.5 (VDD), J5.7 (VDD), R7.2, R1106.1, R1107.1, U1.45 (VIN3P3), U4.2 (3V3); also elsewhere on the board
EPD_SDMMC_CLK: U4.20 (IO12); also elsewhere on the board
EPD_SDMMC_CMD: U4.22 (IO14); also elsewhere on the board
EPD_SDMMC_DAT0: U4.18 (IO10); also elsewhere on the board
EPD_SDMMC_DAT1: U4.17 (IO9); also elsewhere on the board
EPD_SDMMC_DAT2: U4.21 (IO13); also elsewhere on the board
EPD_SDMMC_DAT3: U4.23 (IO21); also elsewhere on the board
EPD_VIN: C3.1, C4.1, C5.1, C6.1, C23.2, L1102.2, R7.1, U1.10 (VIN), U1.24 (VIN_P)
GND: C1.2, C2.2, C3.2, C4.2, C5.2, C6.2, C7.1, C8.1, C9.1, C10.1, C11.1, C12.1, C13.1, C14.1, C15.1, C16.1, C19.1, C20.2, C22.2, C23.1, C1101.1, C1102.1, C1103.1, C1104.1, C1105.1, C1106.1, C1107.2, C1108.1, C1109.2, J4.3 (GND), J4.9 (CE1), J4.31 (U1CE1), J4.34 (BORDER), J4.MP1, J4.MP2, J5.6 (VSS), J5.8 (VSS), J5.31 (VSS), J5.32 (BORDER), J5.35, J5.36, J5.37, J5.38, L1101.2, R4.1, R6.1, R1101.1, R1102.1, R1103.1, R1104.1, R1105.1, U1.6 (DGND), U1.8 (AGND1), U1.14 (VCOM_DIS), U1.32 (PGND2), U1.41 (PGND1), U1.48 (AGND2), U4.1 (GND), U4.40 (GND), U4.41 (GND); also elsewhere on the board
unnamed: C17.1, D1.A, D2.C
unnamed: C18.1, D4.C, D5.A
unnamed: C13.2, U1.7 (INT_LDO)
unnamed: C20.1, D4.A, U1.34 (VDDH_D)
unnamed: C18.2, U1.36 (VDDH_DRV)
unnamed: R5.1, R6.2, U1.33 (VDDH_FB)
unnamed: C2.1, D1.C, U1.30 (VEE_D)
unnamed: C17.2, U1.28 (VEE_DRV)
unnamed: R3.1, R4.2, U1.31 (VEE_FB)
unnamed: D3.C, L1101.1, U1.25 (VN_SW)
unnamed: C7.2, U1.1 (VREF)
unnamed: C1107.1, R1106.2, U4.3 (EN)
unnamed: R1107.2, U4.27 (IO0)
USB2_D_N: U4.13 (IO19); also elsewhere on the board
USB2_D_P: U4.14 (IO20); also elsewhere on the board

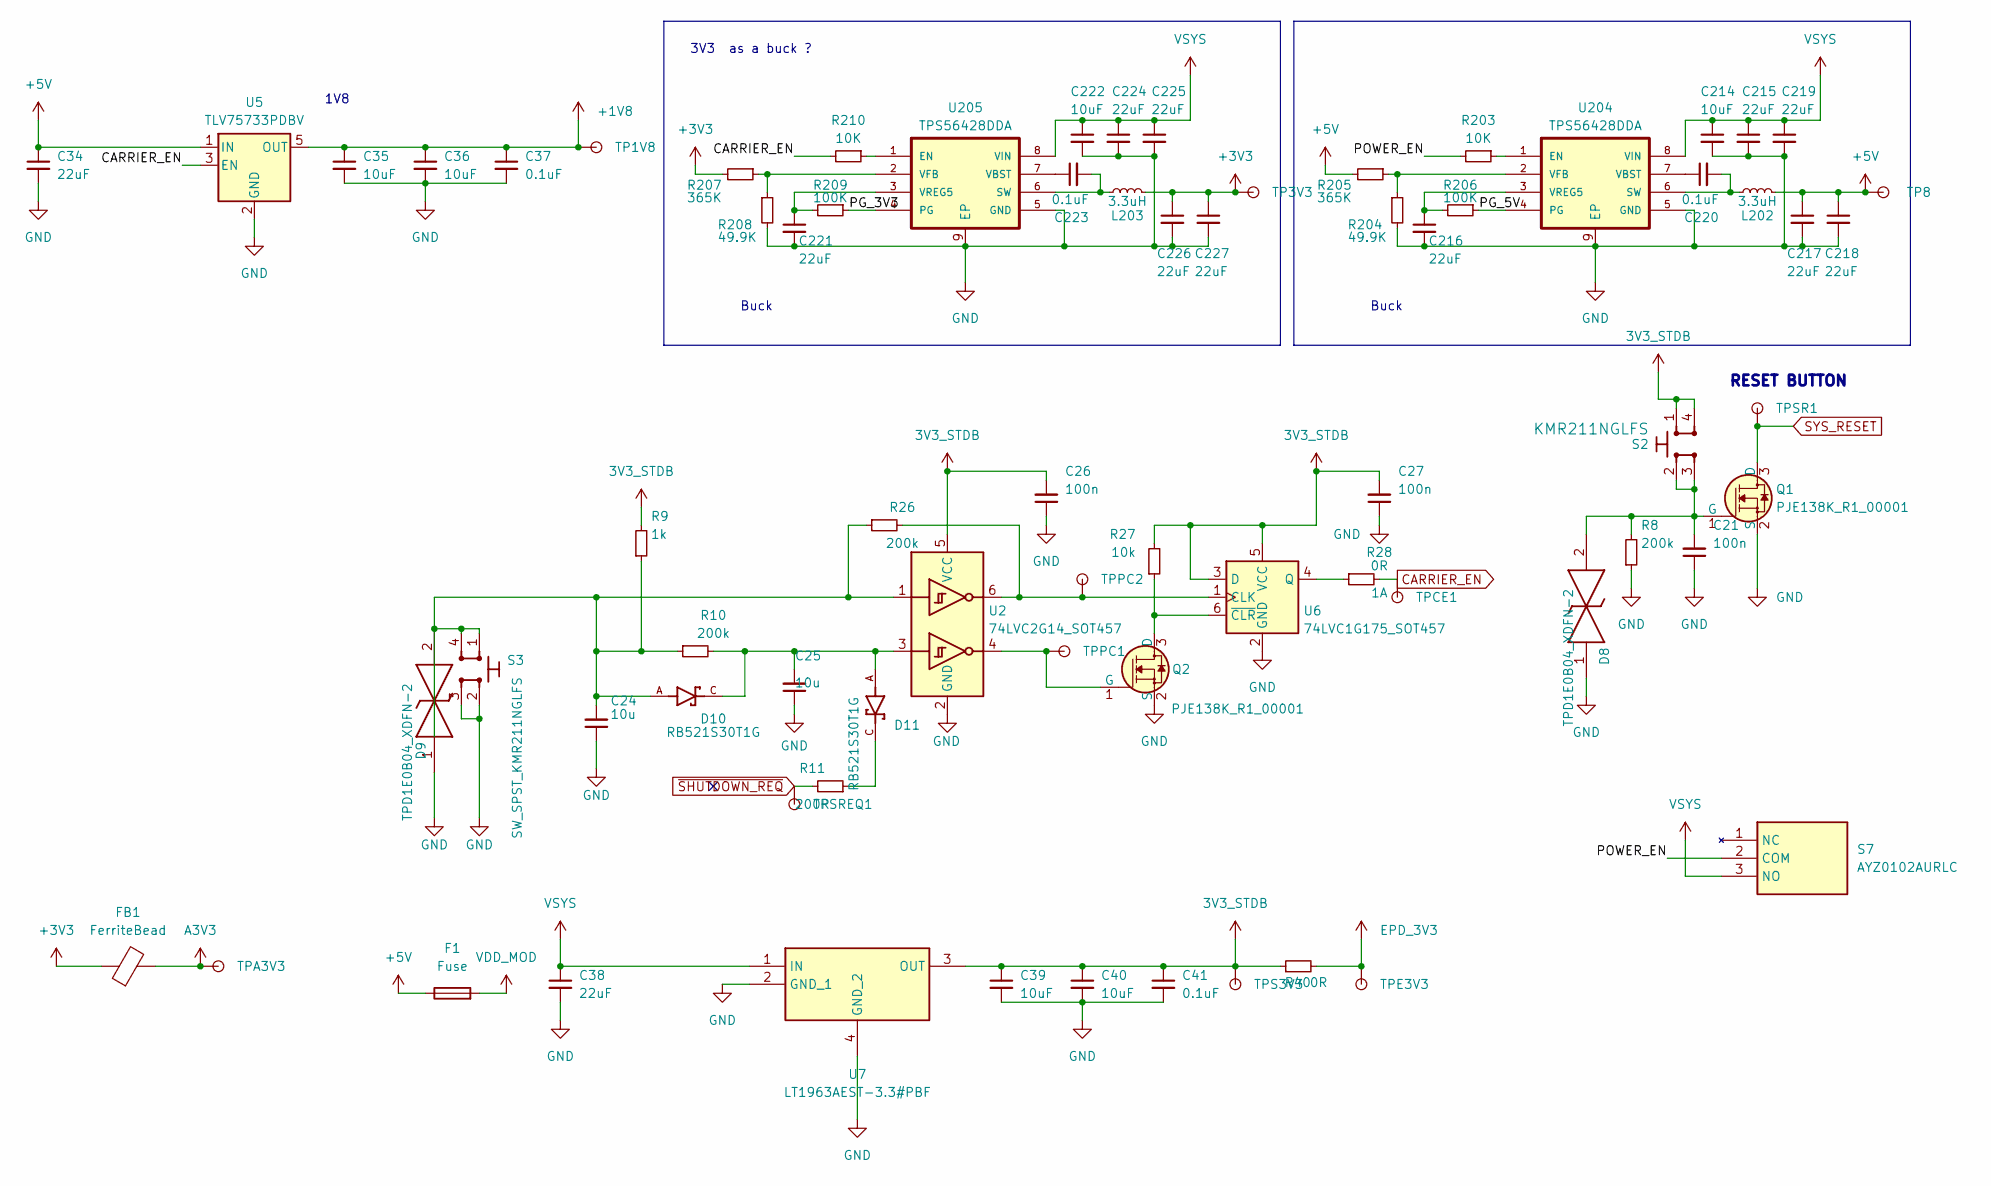
[picture p8: schematic fib_power.kicad_sch]

Parts:
C21, C26, C27: C_Small_Rota; C_0402_1005Metric; Voltage 50V; MPN GRM155R61H104KE14D
C24, C25: C_Small_Rota; C_0402_1005Metric; MPN CC0402MRX5R5BB106
C34, C38, C215, C216, C218, C219, C221, C224, C225, C227: 22uF; C_0805_2012Metric
C35, C36, C39, C40, C214, C222: 10uF; C_0603_1608Metric
C37, C41, C220, C223: 0.1uF; C_0402_1005Metric
C217, C226: 22uF; C_0603_1608Metric
D8, D9: TPD1E0B04_XDFN-2; TPD1E0B04DPYT; MPN TPD1E0B04DPYR; Mouser Part Number 595-TPD1E0B04DPYT
D10, D11: RB521S30T1G; MPN RB521S30T1G
F1: Fuse; Fuse_1206
FB1: FerriteBead; Ferrite_1206
L202, L203: 3.3uH; L_Coilcraft_XAL4030-XXX
Q1, Q2: PJE138K_2; SOT-523; MPN PJE138K_R1_00001
R8, R10, R26: R_Small_Rota; R_0402_1005Metric; Tolerance 1%; MPN CR0402-FX-2003GLF
R9: R_Small_Rota; R_0402_1005Metric; Tolerance 1%; MPN CR0402-FX-1001GLF
R11: R_Small_Rota; R_0402_1005Metric; Tolerance 1%; MPN CR0402-FX-2000GLF
R27: R_Small_Rota; R_0402_1005Metric; Tolerance 1%; MPN CR0402-FX-1002GLF
R28: R_Small_Rota; R_0402_1005Metric; MPN ERJ2GE0R00X
R40: 0R; R_0603_1608Metric
R203, R210: 10K; R_0402_1005Metric
R204, R208: 49.9K; R_0402_1005Metric
R205, R207: 365K; R_0402_1005Metric
R206, R209: 100K; R_0402_1005Metric
S2, S3: SW_SPST_KMR211NGLFS; KMR211NGLFS; MPN KMR211NGLFS
S7: AYZ0102AURLC; Mouser Part Number 611-AYZ0102AURLC
TP1V8, TP3V3, TP8: TestPoint; TestPoint_Pad_D1.0mm
TPA3V3: TestPoint; TestPoint_Pad_D1.0mm
TPCE1: TestPoint; TestPoint_Pad_D1.0mm
TPE3V3: TestPoint; TestPoint_Pad_D1.0mm
TPPC1, TPPC2: TestPoint; TestPoint_Pad_D1.0mm
TPS3V3: TestPoint; TestPoint_Pad_D1.0mm
TPSR1: TestPoint; TestPoint_Pad_D1.0mm
TPSREQ1: TestPoint; TestPoint_Pad_D1.0mm
U2: 74LVC2G14_SOT457; SOT-23-6; MPN 74LVC2G14GV,125
U5: TLV75733PDBV; SOT-23-5
U6: 74LVC1G175_SOT457; SOT-23-6; MPN 74LVC1G175GV,125
U7: LT1963AEST-3.3#PBF; SOT230P700X180-4N; Mouser Part Number 584-1963AEST-3.3PBF
U204, U205: TPS56428DDA

Connections:
3V3_STDB: C26.2, C27.2, C39.1, C40.1, C41.1, R9.2, R27.2, R40.1, S2.1, S2.4, TPS3V3.1, U2.5 (VCC), U6.3 (D), U6.5 (VCC), U7.3 (OUT); also elsewhere on the board
+1V8: C35.1, C36.1, C37.1, TP1V8.1, U5.5 (OUT); also elsewhere on the board
+3V3: C226.1, C227.1, FB1.1, L203.2, R207.2, TP3V3.1; also elsewhere on the board
+5V: C34.1, C217.1, C218.1, F1.1, L202.2, R205.2, TP8.1, U5.1 (IN); also elsewhere on the board
/Power/PG_3V3: R209.1, U205.4 (PG)
/Power/PG_5V: R206.1, U204.4 (PG)
/Power/POWER_EN: R203.2, S7.2 (COM)
A3V3: FB1.2, TPA3V3.1; also elsewhere on the board
CARRIER_EN: R28.2, R210.2, TPCE1.1, U5.3 (EN); also elsewhere on the board
EPD_3V3: R40.2, TPE3V3.1; also elsewhere on the board
GND: C21.1, C24.1, C25.1, C26.1, C27.1, C34.2, C35.2, C36.2, C37.2, C38.2, C39.2, C40.2, C41.2, C214.2, C215.2, C216.2, C217.2, C218.2, C219.2, C221.2, C222.2, C224.2, C225.2, C226.2, C227.2, D8.1, D9.1, Q1.2 (S), Q2.2 (S), R8.1, R204.2, R208.2, S3.2, S3.3, U2.2 (GND), U5.2 (GND), U6.2 (GND), U7.2 (GND_1), U7.4 (GND_2), U204.5 (GND), U204.9 (EP), U205.5 (GND), U205.9 (EP); also elsewhere on the board
unnamed: C24.2, D9.2, D10.A, R9.1, R10.1, R26.1, S3.1, S3.4, U2.1
unnamed: C25.2, D10.C, D11.A, R10.2, U2.3
unnamed: D11.C, R11.1
unnamed: C21.2, D8.2, Q1.1 (G), R8.2, S2.2, S2.3
unnamed: Q2.3 (D), R27.1, U6.6 (~CLR)
unnamed: Q2.1 (G), TPPC1.1, U2.4
unnamed: R26.2, TPPC2.1, U2.6, U6.1 (CLK)
unnamed: R28.1, U6.4 (Q)
unnamed: R203.1, U204.1 (EN)
unnamed: C220.2, L202.1, U204.6 (SW)
unnamed: C220.1, U204.7 (VBST)
unnamed: R204.1, R205.1, U204.2 (VFB)
unnamed: C216.1, R206.2, U204.3 (VREG5)
unnamed: R210.1, U205.1 (EN)
unnamed: C223.2, L203.1, U205.6 (SW)
unnamed: C223.1, U205.7 (VBST)
unnamed: R207.1, R208.1, U205.2 (VFB)
unnamed: C221.1, R209.2, U205.3 (VREG5)
SYS_RESET: Q1.3 (D), TPSR1.1; also elsewhere on the board
VDD_MOD: F1.2; also elsewhere on the board
VSYS: C38.1, C214.1, C215.1, C219.1, C222.1, C224.1, C225.1, S7.3 (NO), U7.1 (IN), U204.8 (VIN), U205.8 (VIN); also elsewhere on the board
~SHUTDOWN_REQ: R11.2, TPSREQ1.1; also elsewhere on the board

Notes on the sheet:
Buck
3V3 as a buck ?
1V8
RESET BUTTON

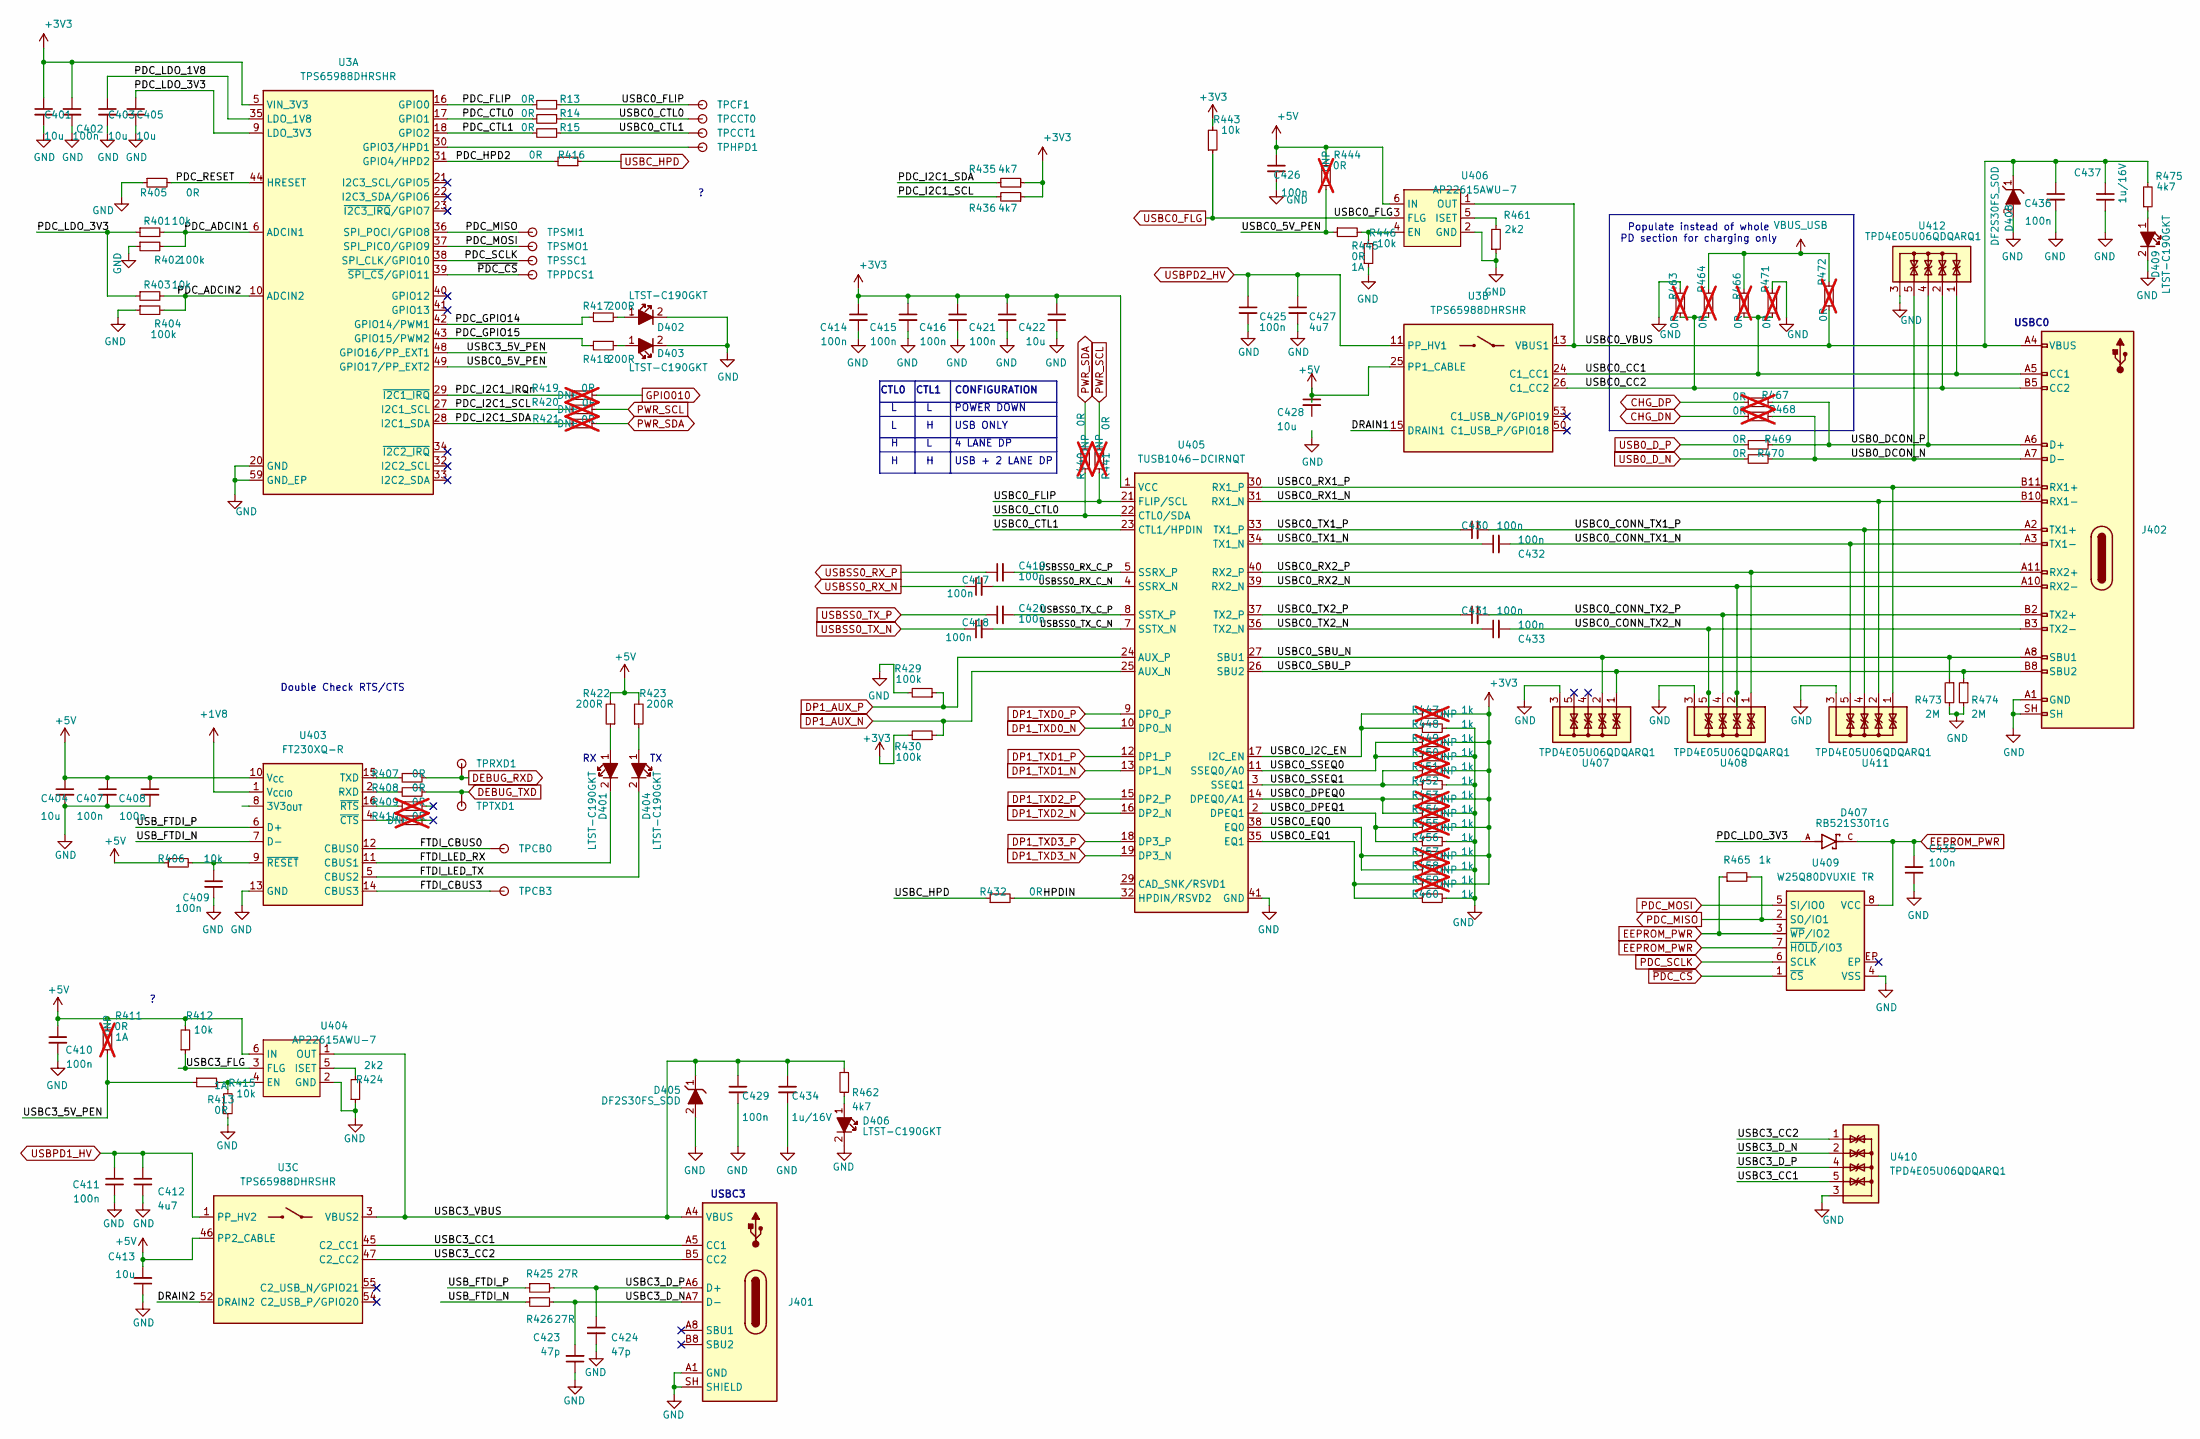
[picture p9: schematic fib_usb.kicad_sch]

Parts:
C401, C403, C404, C405, C413, C422, C428: 10uF; C_0603_1608Metric; MPN CC0402MRX5R5BB106
C402, C407, C408, C409, C410, C411, C414, C415, C416, C417, C418, C419, C420, C421, C425, C426, C429, C430, C431, C432, C433, C435, C436: 100nF; C_0402_1005Metric; Voltage 50V; MPN GRM155R61H104KE14D
C412, C427: 4.7uF; C_0402_1005Metric; Voltage 25V; MPN GRM155C61E475ME15J
C423, C424: 47pF; C_0402_1005Metric; MPN GRM1555C1E470JA01D
C434, C437: 1uF 16V; C_0603_1608Metric; MPN C0402C105M4PACTU
D401, D402, D403, D404, D406, D409: LED_G_0603_LTST-C190GKT; LED_0603_1608Metric; MPN LTST-C190GKT
D405, D408: DF2S30FS_SOD; D_SOD-923; MPN DF2S30FS
D407: RB521S30T1G; MPN RB521S30T1G
J401: USB-C_USB4105-GF-A; USB-C_GCT_USB4105-GF-A; MPN USB4105-GF-A
J402: Conn_USB-C_WE_632723300011; MPN 632723300011
R13, R14, R15, R469, R470: 0R; R_0402_1005Metric
R401, R403, R406, R412, R415, R443, R446: 10K; R_0402_1005Metric; Tolerance 1%; MPN CR0402-FX-1002GLF
R402, R404, R429, R430: 100K; R_0402_1005Metric; Tolerance 1%; MPN CR0402-FX-1003GLF
R405, R407, R408, R413, R416, R432, R445: 0R; R_0402_1005Metric; MPN ERJ2GE0R00X
R409, R410, R411, R419, R420, R421, R440, R441, R444: 0R; R_0402_1005Metric; MPN ERJ2GE0R00X; not fitted
R417, R418, R422, R423: 200R; R_0402_1005Metric; Tolerance 1%; MPN CR0402-FX-2000GLF
R424, R461: 2.2K; R_0402_1005Metric; Tolerance 1%; MPN CR0402-FX-2201GLF
R425, R426: 27R; R_0402_1005Metric; Tolerance 1%; MPN CR0402-FX-27R0GLF
R435, R436, R462, R475: 4.7K; R_0402_1005Metric; Tolerance 1%; MPN CR0402-FX-4701GLF
R447, R449, R450, R451, R453, R454, R455, R457, R458, R459: 2K; R_0402_1005Metric; Tolerance 1%; MPN CR0402-FX-1001GLF; not fitted
R448, R452, R456, R460, R465: 1K; R_0402_1005Metric; Tolerance 1%; MPN CR0402-FX-1001GLF
R463, R464, R466, R467, R468, R471: 0R; R_0402_1005Metric; not fitted
R472: 0R; R_0603_1608Metric; not fitted
R473, R474: 3M; R_0402_1005Metric; Tolerance 1%; MPN CR0402-FX-2004GLF
TPCB0, TPCB3: TestPoint; TestPoint_Pad_D1.0mm
TPCCT0, TPCCT1: TestPoint; TestPoint_Pad_D1.0mm
TPCF1: TestPoint; TestPoint_Pad_D1.0mm
TPHPD1: TestPoint; TestPoint_Pad_D1.0mm
TPPDCS1: TestPoint; TestPoint_Pad_D1.0mm
TPRXD1: TestPoint; TestPoint_Pad_D1.0mm
TPSMI1: TestPoint; TestPoint_Pad_D1.0mm
TPSMO1: TestPoint; TestPoint_Pad_D1.0mm
TPSSC1: TestPoint; TestPoint_Pad_D1.0mm
TPTXD1: TestPoint; TestPoint_Pad_D1.0mm
U3: TPS65988DHRSHR; IC_TPS65987DDHRSHR; MPN TPS65988DHRSHR
U403: FT230X_QFN; QFN-16_1EP_4x4mm_P0.65mm; MPN FT230XQ-R
U404, U406: AP22615_1; TSOT23-6; MPN AP22615AWU-7
U405: TUSB1046-DCIRNQ; WQFN-40_1EP_6x3mm_Pitch0.4mm_EP4.7x2.7mm; MPN TUSB1046-DCIRNQT
U407, U408, U410, U411, U412: TPD4E05U06QDQARQ1; USON-10_2.5x1mm_P0.5mm; MPN TPD4E05U06QDQARQ1
U409: W25Q80DV_USON; USON-8_2x3mm_P0.5mm; MPN W25Q80DVUXIE TR

Connections:
+1V8: U403.1 (V_{CCIO}); also elsewhere on the board
+3V3: C401.1, C402.1, C414.1, C415.1, C416.1, C421.1, C422.1, R430.2, R435.1, R436.1, R443.2, R447.2, R449.2, R451.2, R453.2, R455.2, R457.2, R459.2, U3.5 (VIN_3V3), U405.1 (VCC), U405.6 (VCC), U405.20 (VCC), U405.28 (VCC); also elsewhere on the board
+5V: C404.1, C407.1, C408.1, C410.1, C413.2, C426.1, C428.1, R406.1, R411.2, R412.2, R422.2, R423.2, R444.2, U3.25 (PP1_CABLE), U3.46 (PP2_CABLE), U403.10 (V_{CC}), U404.6 (IN), U406.6 (IN); also elsewhere on the board
/USB/DRAIN1: U3.8 (DRAIN1), U3.15 (DRAIN1), U3.19 (DRAIN1), U3.58 (DRAIN1)
/USB/DRAIN2: U3.7 (DRAIN2), U3.52 (DRAIN2), U3.56 (DRAIN2), U3.57 (DRAIN2)
/USB/FTDI_CBUS0: TPCB0.1, U403.12 (CBUS0)
/USB/FTDI_CBUS3: TPCB3.1, U403.14 (CBUS3)
/USB/FTDI_LED_RX: D401.2, U403.11 (CBUS1)
/USB/FTDI_LED_TX: D404.2, U403.5 (CBUS2)
/USB/HPDIN: R432.2, U405.32 (HPDIN/RSVD2)
/USB/PDC_ADCIN1: R401.2, R402.2, U3.6 (ADCIN1)
/USB/PDC_ADCIN2: R403.2, R404.2, U3.10 (ADCIN2)
/USB/PDC_CTL0: R14.2, U3.17 (GPIO1)
/USB/PDC_CTL1: R15.2, U3.18 (GPIO2)
/USB/PDC_FLIP: R13.2, U3.16 (GPIO0)
/USB/PDC_GPIO14: R417.1, U3.42 (GPIO14/PWM1)
/USB/PDC_GPIO15: R418.1, U3.43 (GPIO15/PWM2)
/USB/PDC_HPD2: R416.2, U3.31 (GPIO4/HPD2)
/USB/PDC_I2C1_IRQn: R419.2, U3.29 (~I2C1_IRQ)
/USB/PDC_I2C1_SCL: R420.2, R436.2, U3.27 (I2C1_SCL)
/USB/PDC_I2C1_SDA: R421.2, R435.2, U3.28 (I2C1_SDA)
/USB/PDC_LDO_1V8: C403.1, U3.35 (LDO_1V8)
/USB/PDC_LDO_3V3: C405.1, D407.A, R401.1, R403.1, U3.9 (LDO_3V3)
/USB/PDC_RESET: R405.2, U3.44 (HRESET)
/USB/USB0_DCON_N: J402.A7 (D-), J402.B7 (D-), R468.1, R470.1, U412.5, U412.6
/USB/USB0_DCON_P: J402.A6 (D+), J402.B6 (D+), R467.1, R469.1, U412.4, U412.7
/USB/USBC0_5V_PEN: R444.1, R445.1, U3.49 (GPIO17/PP_EXT2)
/USB/USBC0_CC1: J402.A5 (CC1), R466.2, R471.2, U3.24 (C1_CC1), U412.1, U412.10
/USB/USBC0_CC2: J402.B5 (CC2), R463.2, R464.2, U3.26 (C1_CC2), U412.2, U412.9
/USB/USBC0_CONN_TX1_N: C432.2, J402.A3 (TX1-), U411.5, U411.6
/USB/USBC0_CONN_TX1_P: C430.2, J402.A2 (TX1+), U411.4, U411.7
/USB/USBC0_CONN_TX2_N: C433.2, J402.B3 (TX2-), U408.5, U408.6
/USB/USBC0_CONN_TX2_P: C431.2, J402.B2 (TX2+), U408.4, U408.7
/USB/USBC0_CTL0: R14.1, R440.1, TPCCT0.1, U405.22 (CTL0/SDA)
/USB/USBC0_CTL1: R15.1, TPCCT1.1, U405.23 (CTL1/HPDIN)
/USB/USBC0_DPEQ0: R453.1, R454.1, U405.14 (DPEQ0/A1)
/USB/USBC0_DPEQ1: R455.1, R456.1, U405.2 (DPEQ1)
/USB/USBC0_EQ0: R457.1, R458.1, U405.38 (EQ0)
/USB/USBC0_EQ1: R459.1, R460.1, U405.35 (EQ1)
/USB/USBC0_FLIP: R13.1, R441.1, TPCF1.1, U405.21 (FLIP/SCL)
/USB/USBC0_I2C_EN: R447.1, R448.1, U405.17 (I2C_EN)
/USB/USBC0_RX1_N: J402.B10 (RX1-), U405.31 (RX1_N), U411.2, U411.9
/USB/USBC0_RX1_P: J402.B11 (RX1+), U405.30 (RX1_P), U411.1, U411.10
/USB/USBC0_RX2_N: J402.A10 (RX2-), U405.39 (RX2_N), U408.2, U408.9
/USB/USBC0_RX2_P: J402.A11 (RX2+), U405.40 (RX2_P), U408.1, U408.10
/USB/USBC0_SBU_N: J402.A8 (SBU1), R473.1, U405.27 (SBU1), U407.2, U407.9
/USB/USBC0_SBU_P: J402.B8 (SBU2), R474.1, U405.26 (SBU2), U407.1, U407.10
/USB/USBC0_SSEQ0: R449.1, R450.1, U405.11 (SSEQ0/A0)
/USB/USBC0_SSEQ1: R451.1, R452.1, U405.3 (SSEQ1)
/USB/USBC0_TX1_N: C432.1, U405.34 (TX1_N)
/USB/USBC0_TX1_P: C430.1, U405.33 (TX1_P)
/USB/USBC0_TX2_N: C433.1, U405.36 (TX2_N)
/USB/USBC0_TX2_P: C431.1, U405.37 (TX2_P)
/USB/USBC0_VBUS: C436.1, C437.2, D408.1, J402.A4 (VBUS), J402.A9 (VBUS), J402.B4 (VBUS), J402.B9 (VBUS), R472.2, R475.2, U3.13 (VBUS1), U406.1 (OUT)
/USB/USBC3_5V_PEN: R411.1, R413.1, U3.48 (GPIO16/PP_EXT1)
/USB/USBC3_CC1: J401.A5 (CC1), U3.45 (C2_CC1), U410.5, U410.6
/USB/USBC3_CC2: J401.B5 (CC2), U3.47 (C2_CC2), U410.1, U410.10
/USB/USBC3_D_N: C423.2, J401.A7 (D-), J401.B7 (D-), R426.2, U410.2, U410.9
/USB/USBC3_D_P: C424.1, J401.A6 (D+), J401.B6 (D+), R425.2, U410.4, U410.7
/USB/USBC3_FLG: R412.1, U404.3 (FLG)
/USB/USBC3_VBUS: C429.1, C434.1, D405.1, J401.A4 (VBUS), J401.A9 (VBUS), J401.B4 (VBUS), J401.B9 (VBUS), R462.1, U3.3 (VBUS2), U404.1 (OUT)
/USB/USBSS0_RX_C_N: C417.2, U405.4 (SSRX_N)
/USB/USBSS0_RX_C_P: C419.2, U405.5 (SSRX_P)
/USB/USBSS0_TX_C_N: C418.2, U405.7 (SSTX_N)
/USB/USBSS0_TX_C_P: C420.2, U405.8 (SSTX_P)
/USB/USB_FTDI_N: R426.1, U403.7 (D-)
/USB/USB_FTDI_P: R425.1, U403.6 (D+)
CHG_DN: R468.2; also elsewhere on the board
CHG_DP: R467.2; also elsewhere on the board
DEBUG_RXD: R407.1, TPRXD1.1; also elsewhere on the board
DEBUG_TXD: R408.1, TPTXD1.1; also elsewhere on the board
DP1_AUX_N: R430.1, U405.25 (AUX_N); also elsewhere on the board
DP1_AUX_P: R429.1, U405.24 (AUX_P); also elsewhere on the board
DP1_TXD0_N: U405.10 (DP0_N); also elsewhere on the board
DP1_TXD0_P: U405.9 (DP0_P); also elsewhere on the board
DP1_TXD1_N: U405.13 (DP1_N); also elsewhere on the board
DP1_TXD1_P: U405.12 (DP1_P); also elsewhere on the board
DP1_TXD2_N: U405.16 (DP2_N); also elsewhere on the board
DP1_TXD2_P: U405.15 (DP2_P); also elsewhere on the board
DP1_TXD3_N: U405.19 (DP3_N); also elsewhere on the board
DP1_TXD3_P: U405.18 (DP3_P); also elsewhere on the board
EEPROM_PWR: C435.2, D407.C, R465.1, U409.3 (~WP/IO2), U409.7 (~HOLD/IO3), U409.8 (VCC)
GND: C401.2, C402.2, C403.2, C404.2, C405.2, C407.2, C408.2, C409.2, C410.2, C411.2, C412.2, C413.1, C414.2, C415.2, C416.2, C421.2, C422.2, C423.1, C424.2, C425.2, C426.2, C427.2, C429.2, C434.2, C435.1, C436.2, C437.1, D402.2, D403.2, D405.2, D406.2, D408.2, D409.2, J401.A1 (GND), J401.A12 (GND), J401.B1 (GND), J401.B12 (GND), J401.SH (SHIELD), J402.A1 (GND), J402.A12 (GND), J402.B1 (GND), J402.B12 (GND), J402.SH, R402.1, R404.1, R405.1, R415.1, R424.1, R429.2, R446.1, R448.2, R450.2, R452.2, R454.2, R456.2, R458.2, R460.2, R461.1, R463.1, R471.1, R473.2, R474.2, U3.20 (GND), U3.51 (GND), U3.59 (GND_EP), U403.3 (GND), U403.13 (GND), U403.17 (GND), U404.2 (GND), U405.41 (GND), U406.2 (GND), U407.3, U407.8, U408.3, U408.8, U409.4 (VSS), U410.3, U410.8, U411.3, U411.8, U412.3, U412.8; also elsewhere on the board
GPIO010: R419.1; also elsewhere on the board
unnamed: D401.1, R422.1
unnamed: D402.1, R417.2
unnamed: D403.1, R418.2
unnamed: D404.1, R423.1
unnamed: D406.1, R462.2
unnamed: D409.1, R475.1
unnamed: TPHPD1.1, U3.30 (GPIO3/HPD1)
unnamed: R408.2, U403.2 (RXD)
unnamed: R407.2, U403.15 (TXD)
unnamed: R410.2, U403.4 (~CTS)
unnamed: C409.1, R406.2, U403.9 (~RESET)
unnamed: R409.2, U403.16 (~RTS)
unnamed: R413.2, R415.2, U404.4 (EN)
unnamed: R424.2, U404.5 (ISET)
unnamed: R445.2, R446.2, U406.4 (EN)
unnamed: R461.2, U406.5 (ISET)
PDC_MISO: R465.2, TPSMI1.1, U3.36 (SPI_POCI/GPIO8), U409.2 (SO/IO1)
PDC_MOSI: TPSMO1.1, U3.37 (SPI_PICO/GPIO9), U409.5 (SI/IO0)
PDC_SCLK: TPSSC1.1, U3.38 (SPI_CLK/GPIO10), U409.6 (SCLK)
PWR_SCL: R420.1, R441.2; also elsewhere on the board
PWR_SDA: R421.1, R440.2; also elsewhere on the board
USB0_D_N: R470.2; also elsewhere on the board
USB0_D_P: R469.2; also elsewhere on the board
USBC0_FLG: R443.1, U406.3 (FLG)
USBC_HPD: R416.1, R432.1
USBPD1_HV: C411.1, C412.1, U3.1 (PP_HV2); also elsewhere on the board
USBPD2_HV: C425.1, C427.1, U3.11 (PP_HV1); also elsewhere on the board
USBSS0_RX_N: C417.1; also elsewhere on the board
USBSS0_RX_P: C419.1; also elsewhere on the board
USBSS0_TX_N: C418.1; also elsewhere on the board
USBSS0_TX_P: C420.1; also elsewhere on the board
VBUS_USB: R464.1, R466.1, R472.1; also elsewhere on the board
~PDC_CS: TPPDCS1.1, U3.39 (~SPI_CS/GPIO11), U409.1 (~CS)

Notes on the sheet:
Double Check RTS/CTS
USBC0
Populate instead of whole PD section for charging only
USB + 2 LANE DP
POWER DOWN
4 LANE DP
USBC3
CTL1
CTL0
USB ONLY
CONFIGURATION
