nikolozka/Fibel2/Fibel2.kicad_pcb

## KiCad design Fibel2.kicad_pcb (continued)

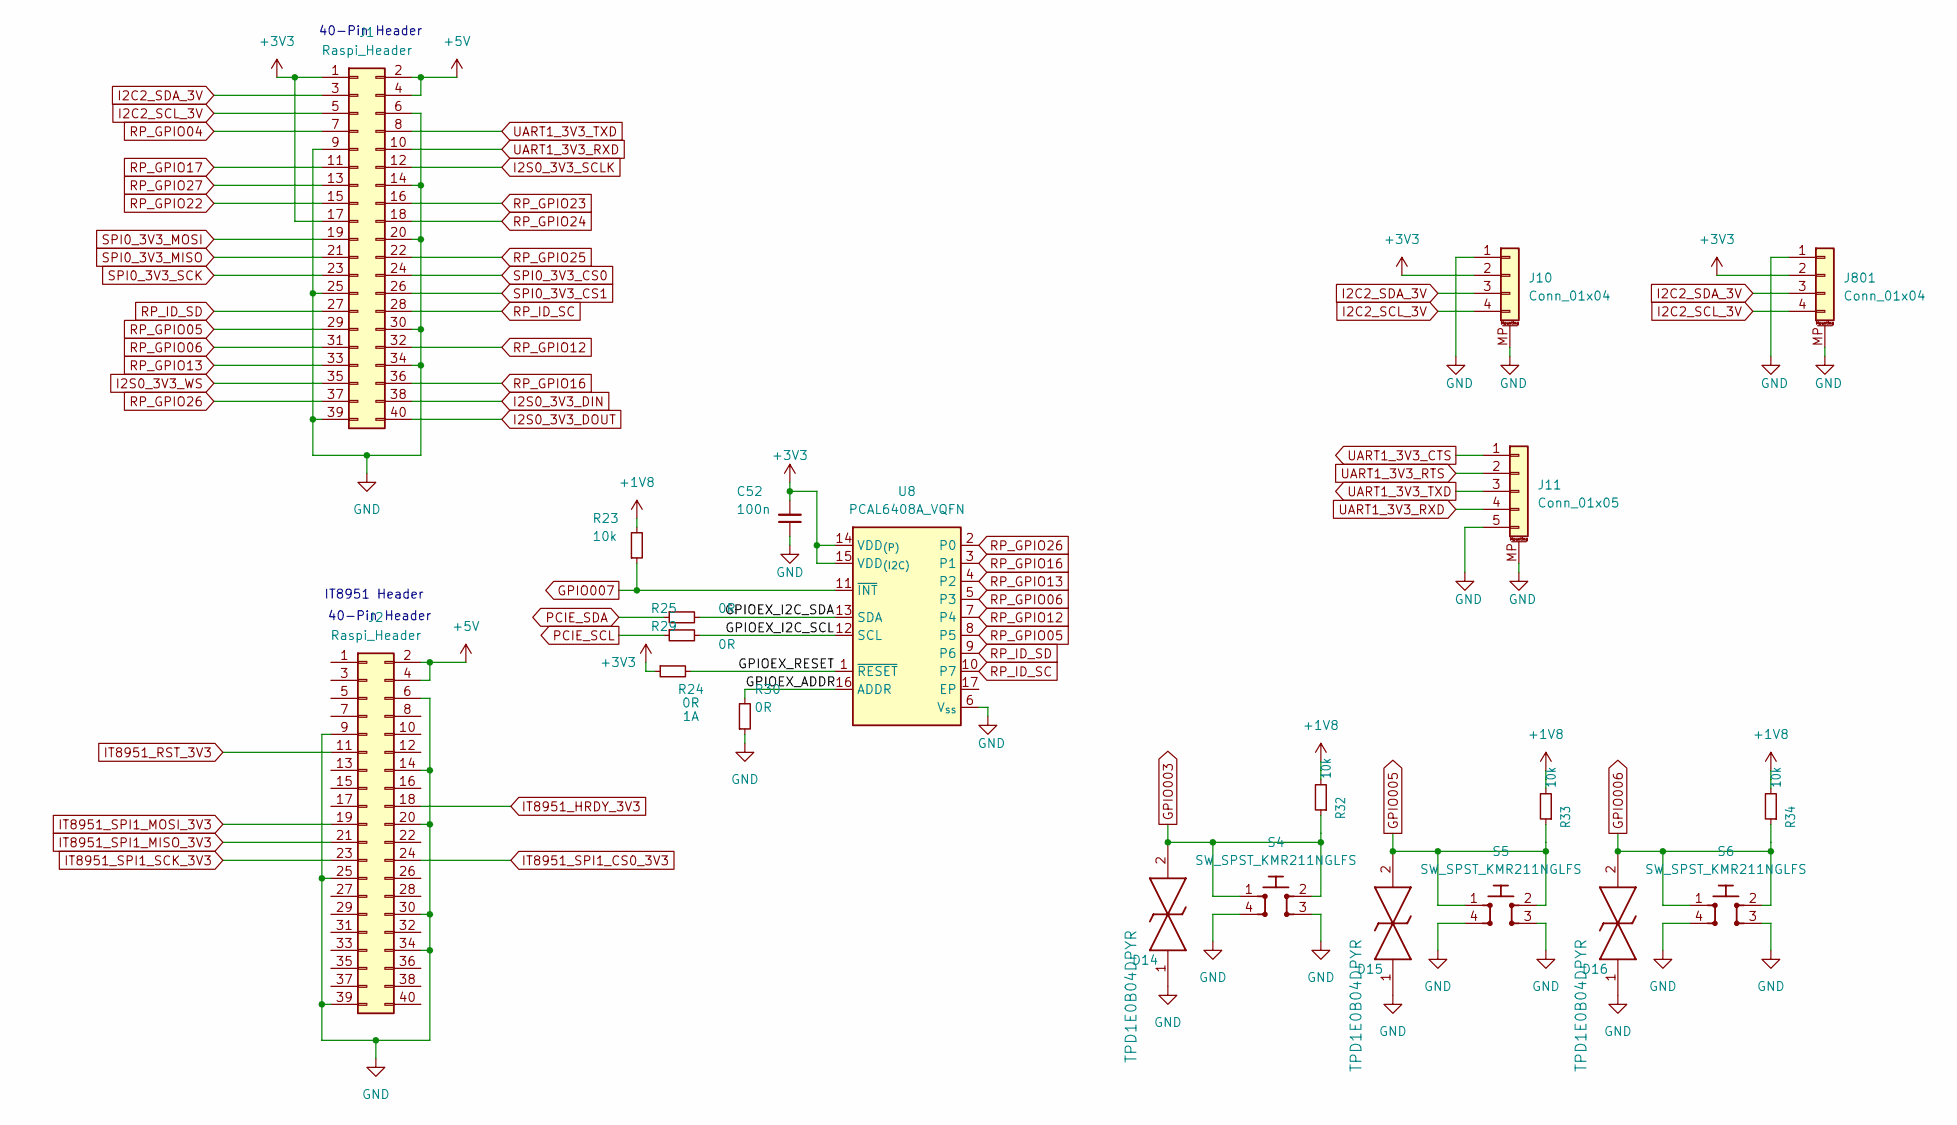
[picture p10: schematic fib_peripherals.kicad_sch]

Parts:
C52: C_Small_Rota; C_0402_1005Metric; Voltage 50V; MPN GRM155R61H104KE14D
D14, D15, D16: TPD1E0B04_XDFN-2; TPD1E0B04DPYT; MPN TPD1E0B04DPYR; Mouser Part Number 595-TPD1E0B04DPYT
J1, J2: Raspi_Header; Raspberry_Bottom_Entry
J10, J801: Conn_01x04; JST_PH_S4B-PH-SM4-TB_1x04-1MP_P2.00mm_Horizontal
J11: Conn_01x05; JST_PH_S5B-PH-SM4-TB_1x05-1MP_P2.00mm_Horizontal
R23: R_Small_Rota; R_0402_1005Metric; Tolerance 1%; MPN CR0402-FX-1002GLF
R24, R25, R29, R30: R_Small_Rota; R_0402_1005Metric; MPN ERJ2GE0R00X
R32, R33, R34: 10k; R_0402_1005Metric
S4, S5, S6: SW_SPST_KMR211NGLFS; KMR211NGLFS; MPN KMR211NGLFS
U8: PCAL6408A_VQFN; QFN50P300X300X100-17N; MPN PCAL6408ABSHP

Connections:
+1V8: R23.2, R32.2, R33.2, R34.2; also elsewhere on the board
+3V3: C52.2, J1.1, J1.17, J10.2, J801.2, R24.1, U8.14 (VDD_{(P)}), U8.15 (VDD_{(I2C)}); also elsewhere on the board
+5V: J1.2, J1.4, J2.2, J2.4; also elsewhere on the board
/Peripherals/GPIOEX_ADDR: R30.2, U8.16 (ADDR)
/Peripherals/GPIOEX_I2C_SCL: R29.2, U8.12 (SCL)
/Peripherals/GPIOEX_I2C_SDA: R25.2, U8.13 (SDA)
/Peripherals/GPIOEX_RESET: R24.2, U8.1 (~RESET)
GND: C52.1, D14.1, D15.1, D16.1, J1.6, J1.9, J1.14, J1.20, J1.25, J1.30, J1.34, J1.39, J2.6, J2.9, J2.14, J2.20, J2.25, J2.30, J2.34, J2.39, J10.1, J10.MP (MountPin), J11.5, J11.MP (MountPin), J801.1, J801.MP (MountPin), R30.1, S4.3, S4.4, S5.3, S5.4, S6.3, S6.4, U8.6 (V_{ss}); also elsewhere on the board
GPIO003: D14.2, R32.1, S4.1, S4.2; also elsewhere on the board
GPIO005: D15.2, R33.1, S5.1, S5.2; also elsewhere on the board
GPIO006: D16.2, R34.1, S6.1, S6.2; also elsewhere on the board
GPIO007: R23.1, U8.11 (~INT); also elsewhere on the board
I2C2_SCL_3V: J1.5, J10.4, J801.4; also elsewhere on the board
I2C2_SDA_3V: J1.3, J10.3, J801.3; also elsewhere on the board
I2S0_3V3_DIN: J1.38; also elsewhere on the board
I2S0_3V3_DOUT: J1.40; also elsewhere on the board
I2S0_3V3_SCLK: J1.12; also elsewhere on the board
I2S0_3V3_WS: J1.35; also elsewhere on the board
IT8951_HRDY_3V3: J2.18; also elsewhere on the board
IT8951_RST_3V3: J2.11; also elsewhere on the board
IT8951_SPI1_CS0_3V3: J2.24; also elsewhere on the board
IT8951_SPI1_MISO_3V3: J2.21; also elsewhere on the board
IT8951_SPI1_MOSI_3V3: J2.19; also elsewhere on the board
IT8951_SPI1_SCK_3V3: J2.23; also elsewhere on the board
PCIE_SCL: R29.1; also elsewhere on the board
PCIE_SDA: R25.1; also elsewhere on the board
RP_GPIO04: J1.7; also elsewhere on the board
RP_GPIO05: J1.29, U8.8 (P5)
RP_GPIO06: J1.31, U8.5 (P3)
RP_GPIO12: J1.32, U8.7 (P4)
RP_GPIO13: J1.33, U8.4 (P2)
RP_GPIO16: J1.36, U8.3 (P1)
RP_GPIO17: J1.11; also elsewhere on the board
RP_GPIO22: J1.15; also elsewhere on the board
RP_GPIO23: J1.16; also elsewhere on the board
RP_GPIO24: J1.18; also elsewhere on the board
RP_GPIO25: J1.22; also elsewhere on the board
RP_GPIO26: J1.37, U8.2 (P0)
RP_GPIO27: J1.13; also elsewhere on the board
RP_ID_SC: J1.28, U8.10 (P7)
RP_ID_SD: J1.27, U8.9 (P6)
SPI0_3V3_CS0: J1.24; also elsewhere on the board
SPI0_3V3_CS1: J1.26; also elsewhere on the board
SPI0_3V3_MISO: J1.21; also elsewhere on the board
SPI0_3V3_MOSI: J1.19; also elsewhere on the board
SPI0_3V3_SCK: J1.23; also elsewhere on the board
UART1_3V3_CTS: J11.1; also elsewhere on the board
UART1_3V3_RTS: J11.2; also elsewhere on the board
UART1_3V3_RXD: J1.10, J11.4; also elsewhere on the board
UART1_3V3_TXD: J1.8, J11.3; also elsewhere on the board

Notes on the sheet:
40-Pin Header
IT8951 Header

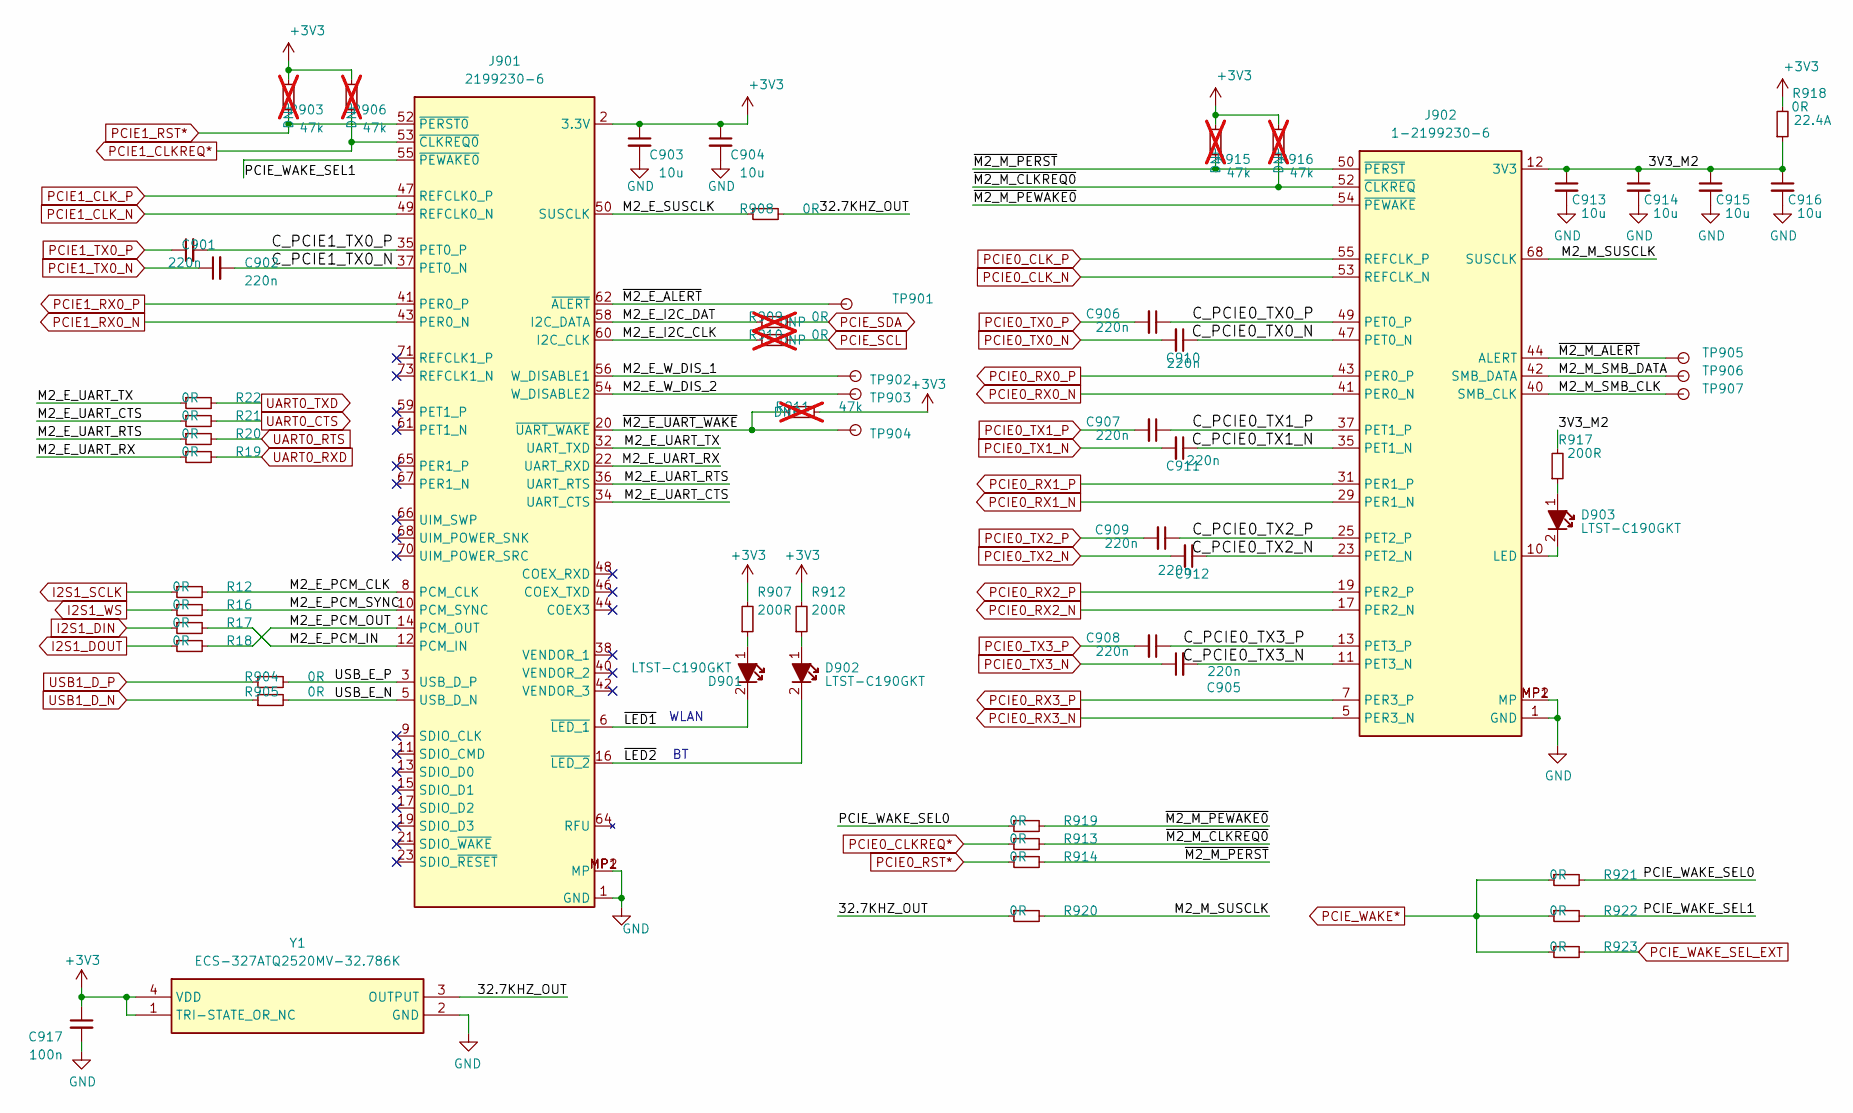
[picture p11: schematic fib_pcie.kicad_sch]

Parts:
C901, C902, C905, C906, C907, C908, C909, C910, C911, C912: 220nF; C_0402_1005Metric; MPN CC0402KRX5R6BB224
C903, C904, C913, C914, C915, C916: 20uF; C_0603_1608Metric; MPN GRM188R61A106KE69D
C917: 100nF; C_0402_1005Metric; Voltage 50V; MPN GRM155R61H104KE14D
D901, D902, D903: LED_G_0603_LTST-C190GKT; LED_0603_1608Metric; MPN LTST-C190GKT
J901: Bus_M.2_2199230-6; 21992306; MPN 2199230-6
J902: Bus_M.2_1-2199230-6; 121992306; MPN 1-2199230-6
R12, R16, R17, R18, R19, R20, R21, R22, R913, R914, R919, R920, R921, R922, R923: R_Small_Rota; R_0402_1005Metric; MPN ERJ2GE0R00X
R903, R906, R911, R915, R916: 47K; R_0402_1005Metric; Tolerance 1%; MPN CR0402-FX-4702GLF; not fitted
R904, R905, R908: 0R; R_0402_1005Metric; MPN ERJ2GE0R00X
R907, R912, R917: 200R; R_0402_1005Metric; Tolerance 1%; MPN CR0402-FX-2000GLF
R909, R910: 0R; R_0402_1005Metric; MPN ERJ2GE0R00X; not fitted
R918: 0R 22A; R_0402_1005Metric; MPN PMR03EZPJ000
TP901, TP902, TP903, TP904, TP905, TP906, TP907: TestPoint; TestPoint_Pad_D1.0mm
Y1: ECS-327ATQ2520MV-32.786K; ECS2520MV; Mouser Part Number 520-327ATQ2520MVBSTR

Connections:
+3V3: C903.1, C904.1, C917.1, J901.2 (3.3V), J901.4 (3.3V), J901.72 (3.3V), J901.74 (3.3V), R903.1, R906.1, R907.2, R911.2, R912.2, R915.1, R916.1, R918.2, Y1.1 (TRI-STATE_OR_NC), Y1.4 (VDD); also elsewhere on the board
/PCIe/3V3_M2: C913.1, C914.1, C915.1, C916.1, J902.2 (3V3), J902.4 (3V3), J902.12 (3V3), J902.14 (3V3), J902.16 (3V3), J902.18 (3V3), J902.70 (3V3), J902.72 (3V3), J902.74 (3V3), R917.2, R918.1
/PCIe/32.7KHZ_OUT: R908.2, R920.1, Y1.3 (OUTPUT)
/PCIe/C_PCIE0_TX0_N: C910.1, J902.47 (PET0_N)
/PCIe/C_PCIE0_TX0_P: C906.1, J902.49 (PET0_P)
/PCIe/C_PCIE0_TX1_N: C911.1, J902.35 (PET1_N)
/PCIe/C_PCIE0_TX1_P: C907.1, J902.37 (PET1_P)
/PCIe/C_PCIE0_TX2_N: C912.1, J902.23 (PET2_N)
/PCIe/C_PCIE0_TX2_P: C909.1, J902.25 (PET2_P)
/PCIe/C_PCIE0_TX3_N: C905.2, J902.11 (PET3_N)
/PCIe/C_PCIE0_TX3_P: C908.1, J902.13 (PET3_P)
/PCIe/C_PCIE1_TX0_N: C902.2, J901.37 (PET0_N)
/PCIe/C_PCIE1_TX0_P: C901.2, J901.35 (PET0_P)
/PCIe/M2_E_I2C_CLK: J901.60 (I2C_CLK), R910.1
/PCIe/M2_E_I2C_DAT: J901.58 (I2C_DATA), R909.1
/PCIe/M2_E_PCM_CLK: J901.8 (PCM_CLK), R12.2
/PCIe/M2_E_PCM_IN: J901.12 (PCM_IN), R17.2
/PCIe/M2_E_PCM_OUT: J901.14 (PCM_OUT), R18.2
/PCIe/M2_E_PCM_SYNC: J901.10 (PCM_SYNC), R16.2
/PCIe/M2_E_SUSCLK: J901.50 (SUSCLK), R908.1
/PCIe/M2_E_UART_CTS: J901.34 (UART_CTS), R21.1
/PCIe/M2_E_UART_RTS: J901.36 (UART_RTS), R20.1
/PCIe/M2_E_UART_RX: J901.22 (UART_RXD), R19.1
/PCIe/M2_E_UART_TX: J901.32 (UART_TXD), R22.1
/PCIe/M2_E_W_DIS_1: J901.56 (W_DISABLE1), TP902.1
/PCIe/M2_E_W_DIS_2: J901.54 (W_DISABLE2), TP903.1
/PCIe/M2_M_SMB_CLK: J902.40 (SMB_CLK), TP907.1
/PCIe/M2_M_SMB_DATA: J902.42 (SMB_DATA), TP906.1
/PCIe/M2_M_SUSCLK: J902.68 (SUSCLK), R920.2
/PCIe/PCIE_WAKE_SEL0: R919.1, R921.2
/PCIe/PCIE_WAKE_SEL1: J901.55 (~PEWAKE0), R922.2
/PCIe/USB_E_N: J901.5 (USB_D_N), R905.2
/PCIe/USB_E_P: J901.3 (USB_D_P), R904.2
/PCIe/~LED1: D901.2, J901.6 (~LED_1)
/PCIe/~LED2: D902.2, J901.16 (~LED_2)
/PCIe/~M2_E_ALERT: J901.62 (~ALERT), TP901.1
/PCIe/~M2_E_UART_WAKE: J901.20 (~UART_WAKE), R911.1, TP904.1
/PCIe/~M2_M_ALERT: J902.44 (ALERT), TP905.1
/PCIe/~M2_M_CLKREQ0: J902.52 (~CLKREQ), R913.2, R916.2
/PCIe/~M2_M_PERST: J902.50 (~PERST), R914.2, R915.2
/PCIe/~M2_M_PEWAKE0: J902.54 (~PEWAKE), R919.2
GND: C903.2, C904.2, C913.2, C914.2, C915.2, C916.2, C917.2, J901.1 (GND), J901.7 (GND), J901.18 (GND), J901.33 (GND), J901.39 (GND), J901.45 (GND), J901.51 (GND), J901.57 (GND), J901.63 (GND), J901.69 (GND), J901.75 (GND), J901.MP1 (MP), J901.MP2 (MP), J902.1 (GND), J902.3 (GND), J902.9 (GND), J902.15 (GND), J902.21 (GND), J902.27 (GND), J902.33 (GND), J902.39 (GND), J902.45 (GND), J902.51 (GND), J902.57 (GND), J902.71 (GND), J902.73 (GND), J902.75 (GND), J902.MP1 (MP), J902.MP2 (MP), Y1.2 (GND); also elsewhere on the board
I2S1_DIN: R17.1; also elsewhere on the board
I2S1_DOUT: R18.1; also elsewhere on the board
I2S1_SCLK: R12.1; also elsewhere on the board
I2S1_WS: R16.1; also elsewhere on the board
unnamed: D901.1, R907.1
unnamed: D902.1, R912.1
unnamed: D903.1, R917.1
unnamed: D903.2, J902.10 (LED)
PCIE0_CLKREQ*: R913.1; also elsewhere on the board
PCIE0_CLK_N: J902.53 (REFCLK_N); also elsewhere on the board
PCIE0_CLK_P: J902.55 (REFCLK_P); also elsewhere on the board
PCIE0_RST*: R914.1; also elsewhere on the board
PCIE0_RX0_N: J902.41 (PER0_N); also elsewhere on the board
PCIE0_RX0_P: J902.43 (PER0_P); also elsewhere on the board
PCIE0_RX1_N: J902.29 (PER1_N); also elsewhere on the board
PCIE0_RX1_P: J902.31 (PER1_P); also elsewhere on the board
PCIE0_RX2_N: J902.17 (PER2_N); also elsewhere on the board
PCIE0_RX2_P: J902.19 (PER2_P); also elsewhere on the board
PCIE0_RX3_N: J902.5 (PER3_N); also elsewhere on the board
PCIE0_RX3_P: J902.7 (PER3_P); also elsewhere on the board
PCIE0_TX0_N: C910.2; also elsewhere on the board
PCIE0_TX0_P: C906.2; also elsewhere on the board
PCIE0_TX1_N: C911.2; also elsewhere on the board
PCIE0_TX1_P: C907.2; also elsewhere on the board
PCIE0_TX2_N: C912.2; also elsewhere on the board
PCIE0_TX2_P: C909.2; also elsewhere on the board
PCIE0_TX3_N: C905.1; also elsewhere on the board
PCIE0_TX3_P: C908.2; also elsewhere on the board
PCIE1_CLKREQ*: J901.53 (~CLKREQ0), R906.2; also elsewhere on the board
PCIE1_CLK_N: J901.49 (REFCLK0_N); also elsewhere on the board
PCIE1_CLK_P: J901.47 (REFCLK0_P); also elsewhere on the board
PCIE1_RST*: J901.52 (~PERST0), R903.2; also elsewhere on the board
PCIE1_RX0_N: J901.43 (PER0_N); also elsewhere on the board
PCIE1_RX0_P: J901.41 (PER0_P); also elsewhere on the board
PCIE1_TX0_N: C902.1; also elsewhere on the board
PCIE1_TX0_P: C901.1; also elsewhere on the board
PCIE_SCL: R910.2; also elsewhere on the board
PCIE_SDA: R909.2; also elsewhere on the board
PCIE_WAKE*: R921.1, R922.1, R923.1; also elsewhere on the board
PCIE_WAKE_SEL_EXT: R923.2
UART0_CTS: R21.2; also elsewhere on the board
UART0_RTS: R20.2; also elsewhere on the board
UART0_RXD: R19.2; also elsewhere on the board
UART0_TXD: R22.2; also elsewhere on the board
USB1_D_N: R905.1; also elsewhere on the board
USB1_D_P: R904.1; also elsewhere on the board

Notes on the sheet:
WLAN

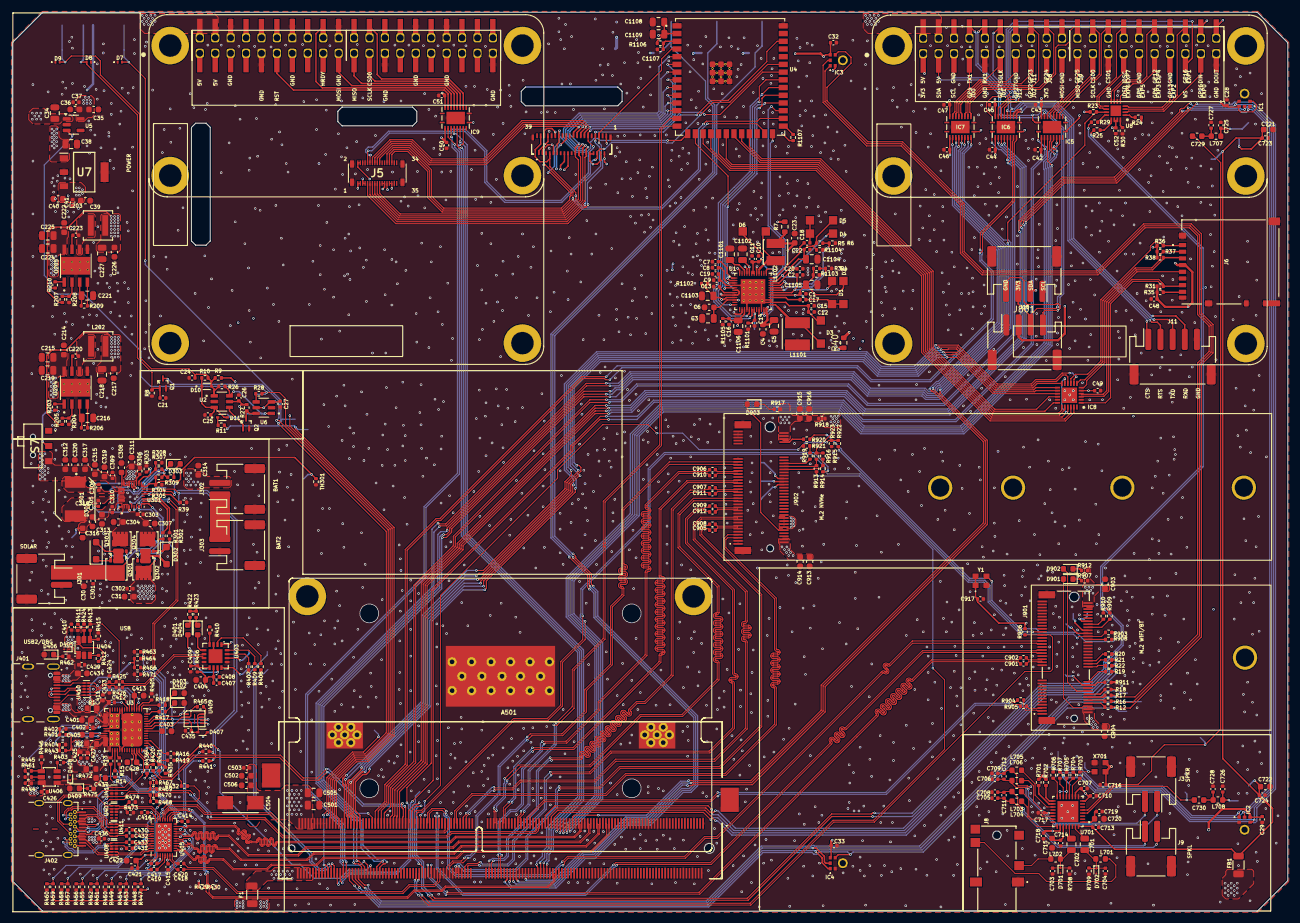
[picture p12: board Fibel2.kicad_pcb from above]

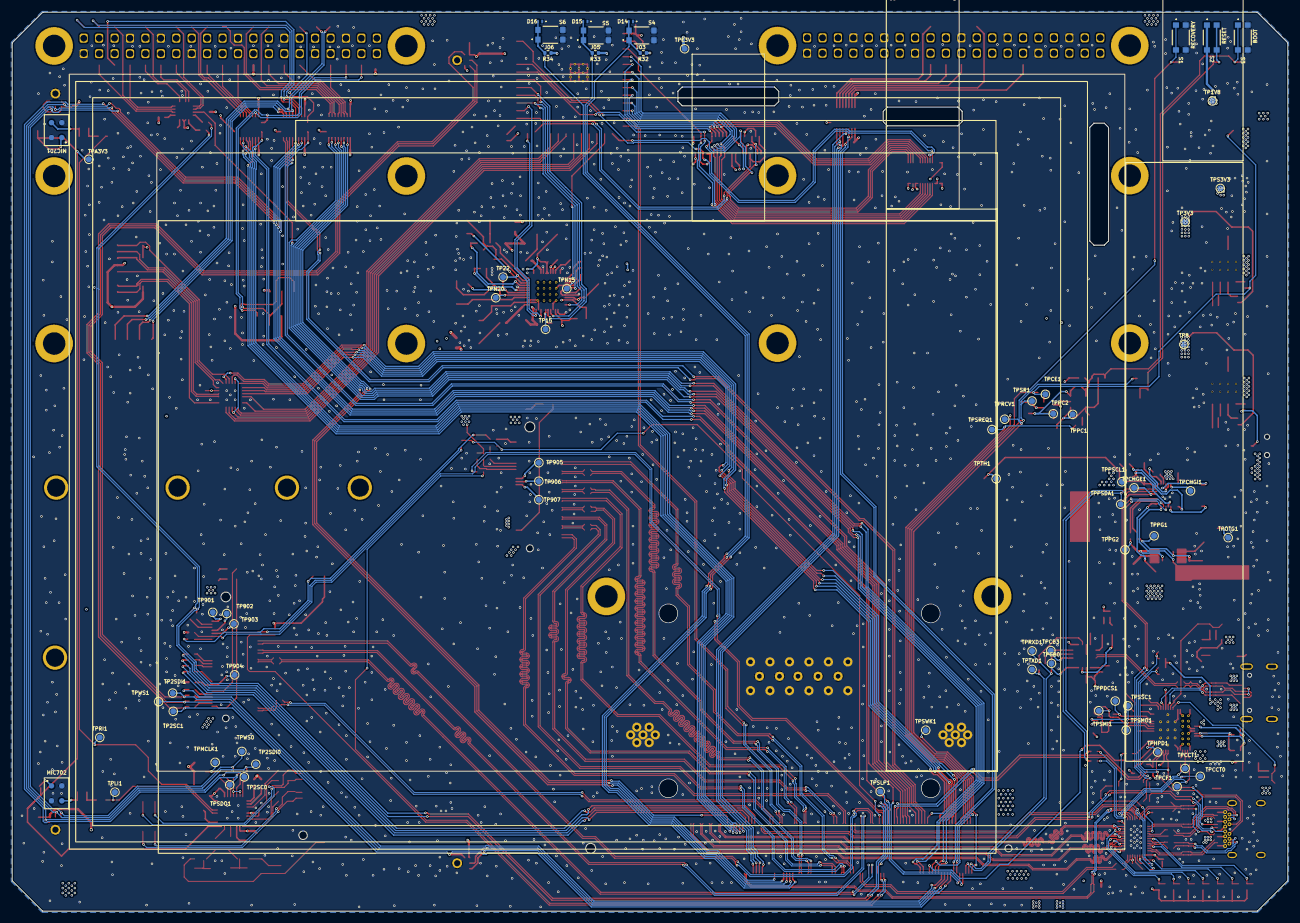
[picture p13: board Fibel2.kicad_pcb from below]

Board: 4 copper layers, 210.0 x 148.0 mm, 514 parts (70 on the bottom side), 427 nets.
