nikolozka/Fibel2/Fib2_Docs/Audio/Respeaker_2mic/ReSpeaker 2-Mics Pi HAT.brd

## EAGLE design Fib2_Docs/Audio/Respeaker_2mic/ReSpeaker 2-Mics Pi HAT.brd (2024-05-04)

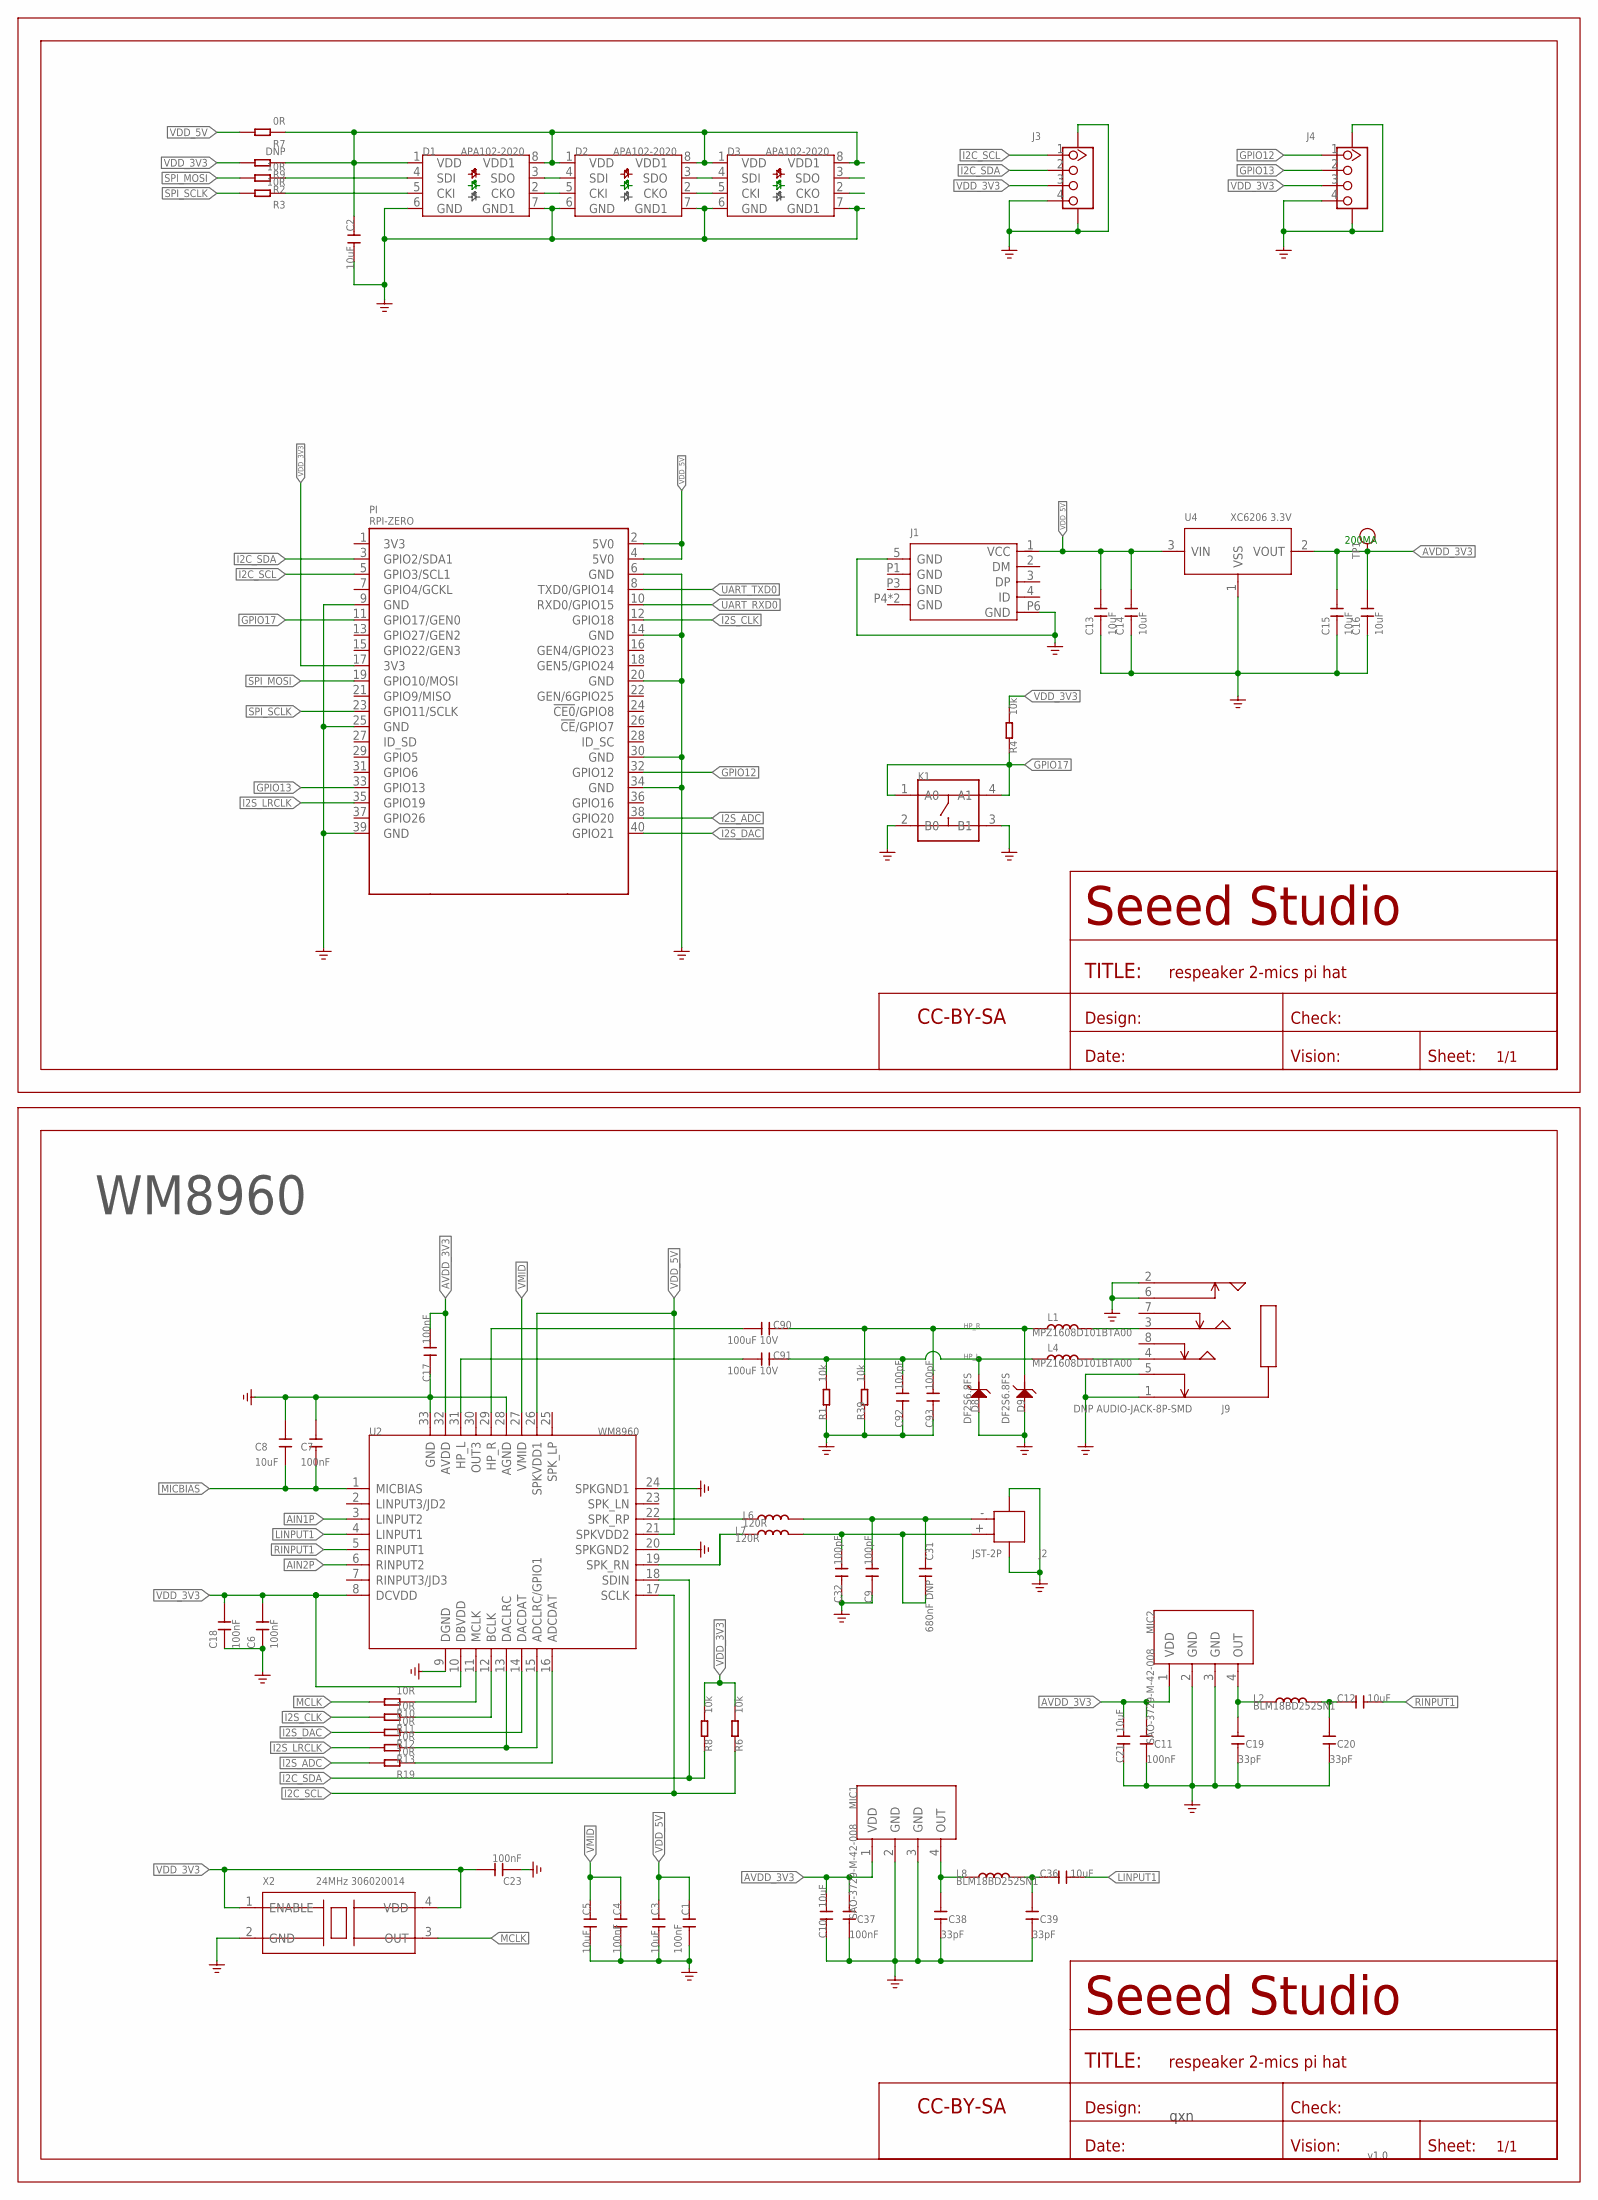
[picture p14: schematic ReSpeaker 2-Mics Pi HAT.sch]

Parts:
C1, C4, C6, C7, C11, C17, C18, C23, C37: 100nF; C0402
C2, C3, C5, C8, C10, C12, C13, C14, C15, C16, C21, C36: 10uF; C0603
C9, C32, C92, C93: 100pF; C0402
C19, C20, C38, C39: 33pF; C0402
C31: 680nF DNP; C0402
C90, C91: 100uF 10V; C0805
D1, D2, D3: APA102-2020; RGB2020
D8, D9: DF2S6.8FS; SOD-923
FR1, FR8: SEEEDSTUDIO-OPEN-SCH-FRAME; SEEEDSTUDIO-PCB-FRAME
J1: MICRO-USB5+4P; MICRO-USB5+5P-SMD-0.65-7.2X5.06MM
J2: JST-2P; HW2-SMD-2.0-90D
J3, J4: GROVE-CONNECTOR-SMD'90D'; HW4-SMD-2.0-90D
J9: DNP AUDIO-JACK-8P-SMD; AUDIO8P-SMD-3.5-14.5X6.1X4.0MM
K1: BUTTON-4PDTSM-62K-S-V-T/R(SN431); SW4-SMD-6.0X6.0X5.0MM
L1, L4: MPZ1608D101BTA00; L0603
L2, L8: BLM18BD252SN1; L0603
L6, L7: 120R; L0603
MIC1, MIC2: SAO-3729-M-42-008; MIC4-SMD-3.76X2.95MM
PI: RPI-ZERO; RASPBERRYPI_BASTELSTUBE_V13_RASPI_BOARD_B+_FULL
R1, R4, R6, R8, R39: 10k; R0402
R2, R3, R10, R11, R12, R13, R19: 10R; R0402
R7: 0R; R0402
R9: DNP; R0402
TP1: TEST-POINT-D65/35; TP-D65/35MIL
U2: WM8960; QFN32G-0.5-5X5MM
U4: XC6206 3.3V; SOT-23
X2: 24MHz 306020014; OSC4-SMD-2.5X2.0X0.8MM

Connections:
$123: C90.1, U2.29 (HP_R)
$124: C91.1, U2.31 (HP_L)
AIN1P: U2.3 (LINPUT2)
AIN2P: U2.6 (RINPUT2)
AVDD_3V3: C10.2, C11.2, C15.2, C16.2, C17.2, C21.2, C37.2, MIC1.1 (VDD), MIC2.1 (VDD), TP1.P1, U2.32 (AVDD), U4.2 (VOUT)
GND: C1.1, C2.2, C3.2, C4.1, C5.2, C6.1, C7.2, C8.1, C9.1, C10.1, C11.1, C13.1, C14.1, C15.1, C16.1, C17.1, C18.1, C19.1, C20.1, C21.1, C23.1, C32.1, C37.1, C38.1, C39.1, C92.1, C93.1, D1.6 (GND), D1.7 (GND1), D2.6 (GND), D2.7 (GND1), D3.6 (GND), D3.7 (GND1), D8.2 (1), D9.2 (1), J1.5 (GND), J1.P6 (GND), J2.3, J2.4, J3.4, J3.SS1, J3.SS2, J4.4, J4.SS1, J4.SS2, J9.1, J9.2, J9.5, J9.6, K1.2 (B0), K1.3 (B1), MIC1.2 (GND), MIC1.3 (GND), MIC2.2 (GND), MIC2.3 (GND), PI.6 (GND), PI.9 (GND), PI.14 (GND), PI.20 (GND), PI.25 (GND), PI.30 (GND), PI.34 (GND), PI.39 (GND), R1.1, R39.1, U2.9 (DGND), U2.20 (SPKGND2), U2.24 (SPKGND1), U2.28 (AGND), U2.33 (GND), U4.1 (VSS), X2.2 (GND)
GPIO12: J4.1, PI.32 (GPIO12)
GPIO13: J4.2, PI.33 (GPIO13)
GPIO17: K1.1 (A0), K1.4 (A1), PI.11 (GPIO17/GEN0), R4.1
HP_L: C91.2, C92.2, D8.1 (2), L4.1, R1.2
HP_R: C90.2, C93.2, D9.1 (2), L1.1, R39.2
I2C_SCL: J3.1, PI.5 (GPIO3/SCL1), R6.1, U2.17 (SCLK)
I2C_SDA: J3.2, PI.3 (GPIO2/SDA1), R8.1, U2.18 (SDIN)
I2S_ADC: PI.38 (GPIO20), R19.2
I2S_CLK: PI.12 (GPIO18), R11.2
I2S_DAC: PI.40 (GPIO21), R12.2
I2S_LRCLK: PI.35 (GPIO19), R13.2
LINPUT1: C36.2, U2.4 (LINPUT1)
MCLK: R10.2, X2.3 (OUT)
MICBIAS: C7.1, C8.2, U2.1 (MICBIAS)
unnamed: D1.2 (CKO), D2.5 (CKI)
unnamed: D1.4 (SDI), R2.1
unnamed: C12.1, C20.2, L2.2
unnamed: D1.3 (SDO), D2.4 (SDI)
unnamed: D1.5 (CKI), R3.1
unnamed: C38.2, L8.1, MIC1.4 (OUT)
unnamed: C19.2, L2.1, MIC2.4 (OUT)
unnamed: D2.2 (CKO), D3.5 (CKI)
unnamed: L6.1, U2.22 (SPK_RP)
unnamed: R12.1, U2.14 (DACDAT)
unnamed: D2.3 (SDO), D3.4 (SDI)
unnamed: L7.1, U2.19 (SPK_RN)
unnamed: J9.3, L1.2
unnamed: C36.1, C39.2, L8.2
unnamed: R19.1, U2.16 (ADCDAT)
unnamed: R13.1, U2.13 (DACLRC), U2.15 (ADCLRC/GPIO1)
unnamed: R11.1, U2.12 (BCLK)
unnamed: R10.1, U2.11 (MCLK)
unnamed: C9.2, C31.1, J2.- (2), L6.2
unnamed: C31.2, C32.2, J2.+ (1), L7.2
unnamed: J9.4, L4.2
RINPUT1: C12.2, U2.5 (RINPUT1)
SPI_MOSI: PI.19 (GPIO10/MOSI), R2.2
SPI_SCLK: PI.23 (GPIO11/SCLK), R3.2
UART_RXD0: PI.10 (RXD0/GPIO15)
UART_TXD0: PI.8 (TXD0/GPIO14)
VDD_3V3: C6.2, C18.2, C23.2, J3.3, J4.3, PI.17 (3V3), R4.2, R6.2, R8.2, R9.2, U2.8 (DCVDD), U2.10 (DBVDD), X2.1 (ENABLE), X2.4 (VDD)
VDD_5V: C1.2, C3.1, C13.2, C14.2, J1.1 (VCC), PI.2 (5V0), PI.4 (5V0), R7.2, U2.21 (SPKVDD2), U2.26 (SPKVDD1), U4.3 (VIN)
VDD_LED: C2.1, D1.1 (VDD), D1.8 (VDD1), D2.1 (VDD), D2.8 (VDD1), D3.1 (VDD), D3.8 (VDD1), R7.1, R9.1
VMID: C4.2, C5.1, U2.27 (VMID)

Notes on the sheet:
WM8960
qxn
v1.0
200MA

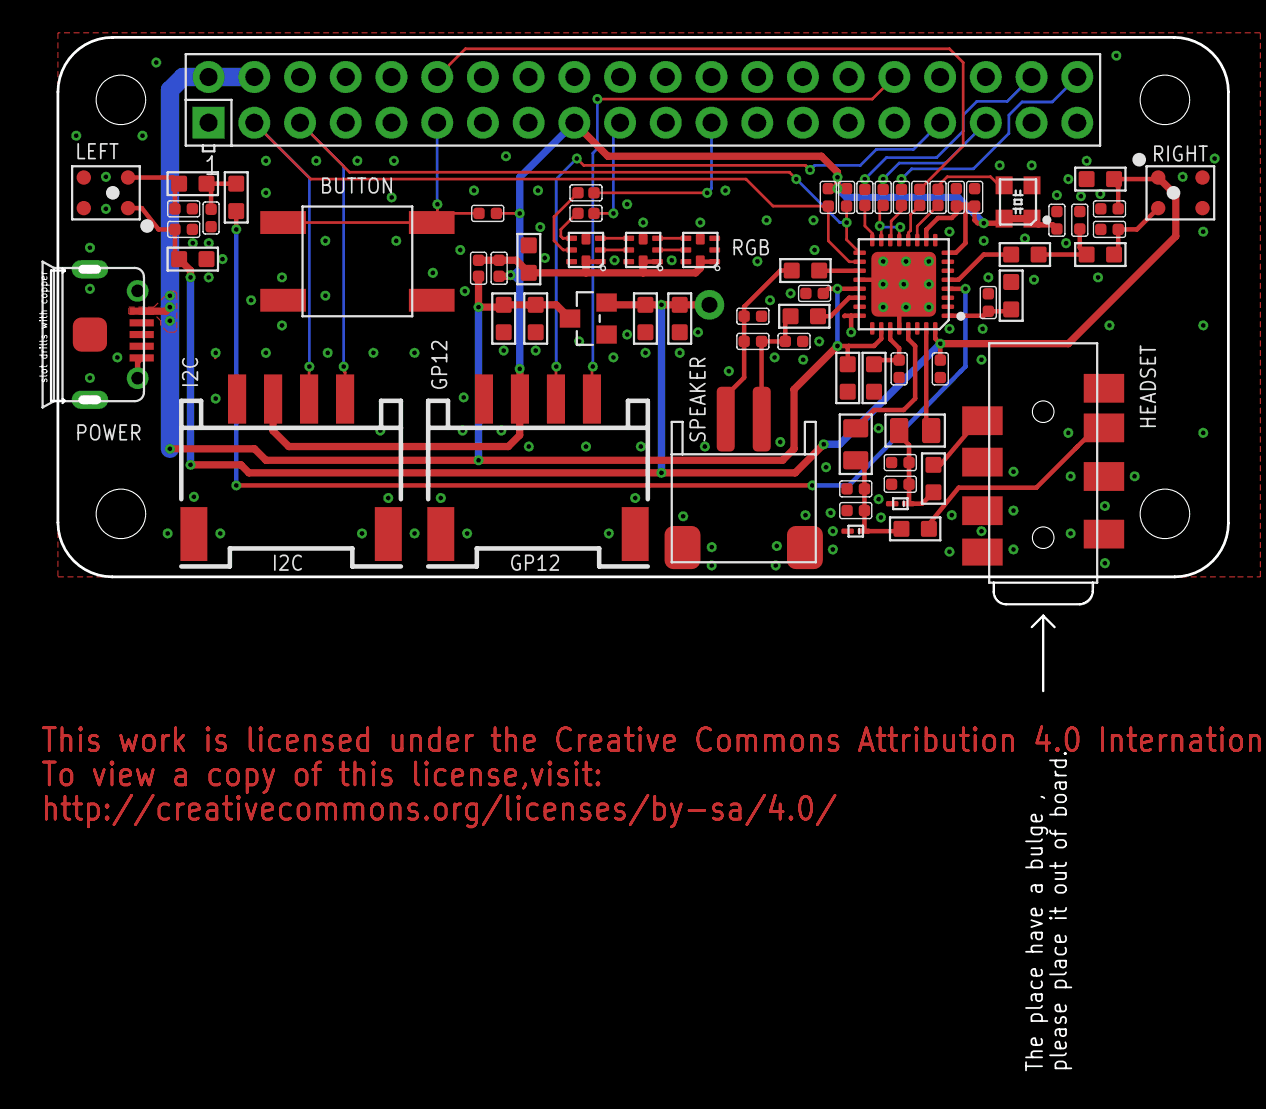
[picture p15: board ReSpeaker 2-Mics Pi HAT.brd from above]

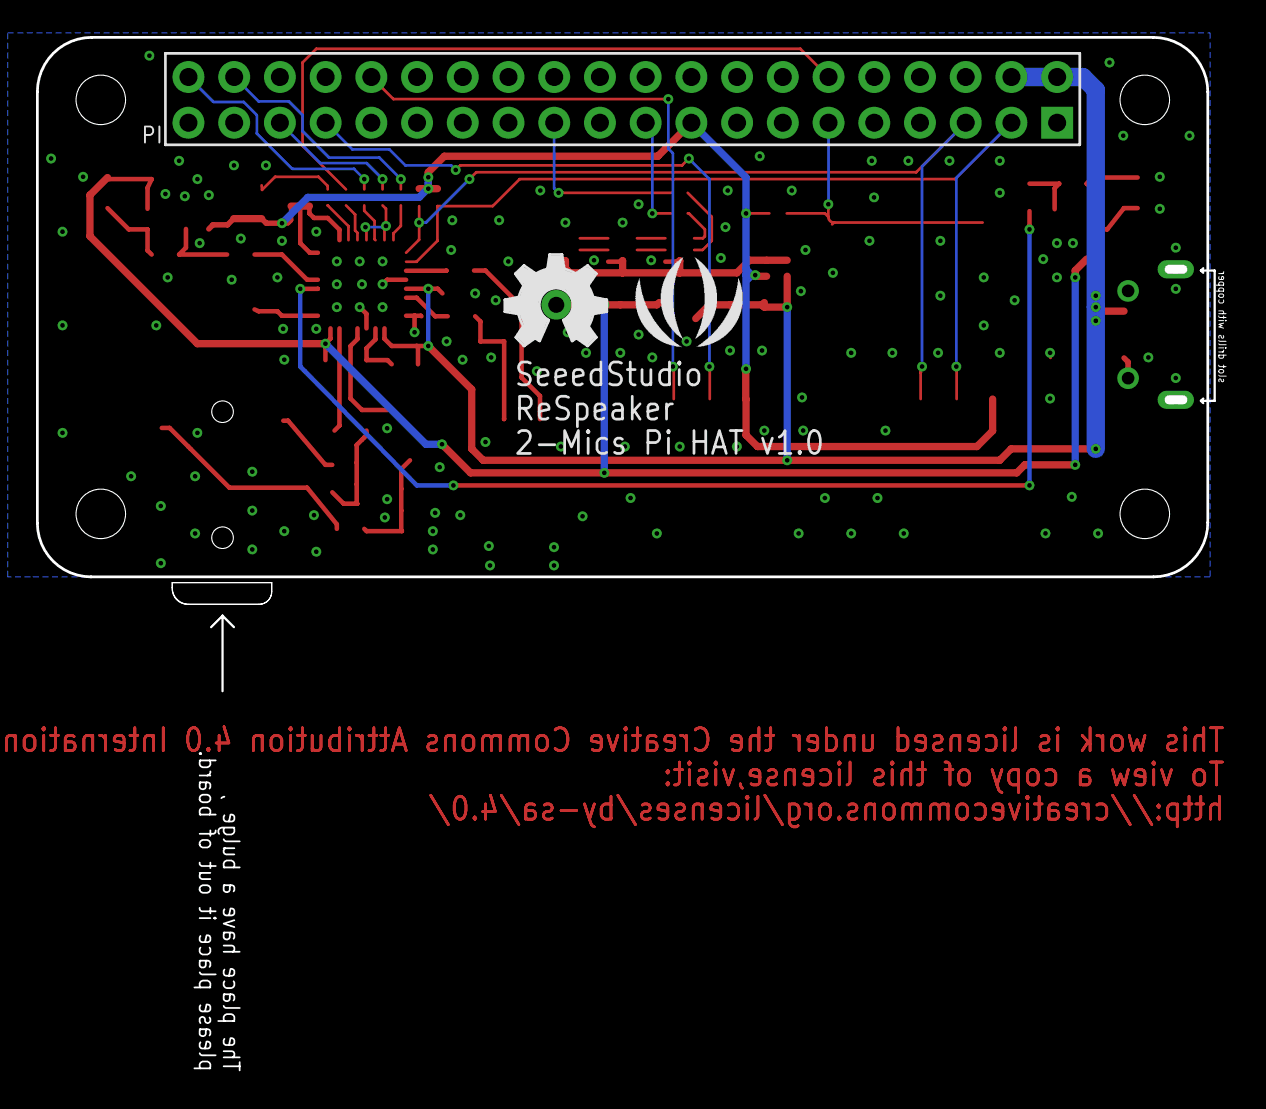
[picture p16: board ReSpeaker 2-Mics Pi HAT.brd from below]

Board: 2 copper layers, 65.0 x 30.0 mm, 74 parts (2 on the bottom side), 46 nets.

Other parts of the board:
U$13: SEEED-SILK-280*268MIL
U$22: OSHW_FILLX200_NOTEXT_TNAME
