nikolozka/Fibel2/(commit log)

2024-04-29 added documentation for Orin and other ics i'm planning to use, created hierarchy for schematics
    [Fibel2.kicad_sch, P3768_A04_BOM.xls, fib_audio.kicad_sch, fib_charging.kicad_sch, fib_it8951.kicad_sch, fib_network.kicad_sch, fib_peripherals.kicad_sch, fib_power.kicad_sch]
2024-05-04 added several ICs, implementted schematics for charger, boost converter and LDOs
    [Fibel2.kicad_pcb, Fibel2.kicad_sch, fib_audio.kicad_sch, fib_charging.kicad_sch, fib_epd.kicad_sch, fib_it8951.kicad_sch, fib_network.kicad_sch, fib_peripherals.kicad_sch]
2024-05-04 added symbol&footprint for orin/sodimm, added a bunch of specs and docs, partially implemented audio, full steam ahead
    [Fibel2.kicad_pcb, Fibel2.kicad_sch, ReSpeaker 2-Mics Pi HAT.brd, ReSpeaker 2-Mics Pi HAT.sch, fib_audio.kicad_sch, fib_charging.kicad_sch, fib_network.kicad_sch, fib_orin_1.kicad_sch]
2024-05-20 added usb+PD+DP & pcie implementations from antmicro design, added specs for USB components, rethought power+usb arch
    [Fibel2.kicad_pcb, fib_audio.kicad_sch, fib_charging.kicad_sch, fib_it8951.kicad_sch, fib_network.kicad_sch, fib_power.kicad_sch, fib_storage.kicad_sch, fib_usb.kicad_sch]
2024-05-20 added footprint, symbol and model for TPS65987
    [Fibel2.kicad_pcb]
2024-05-29 added nets for 40 pin headers (epd & rpi header) connected some of the nets i'm reeusing
    [Fibel2.kicad_pcb, Fibel2.kicad_sch, fib_audio.kicad_sch, fib_charging.kicad_sch, fib_it8951.kicad_sch, fib_network.kicad_sch, fib_orin.kicad_sch, fib_orin_1.kicad_sch]
2024-05-29 added net labels for pcie (m&e key), reusing a lot of blocks from antmicro
    [fib_orin.kicad_sch]
2024-06-05 continuing schematic work for pcie and other high speed interfaces
    [fib_charging.kicad_sch, fib_orin.kicad_sch, fib_storage.kicad_sch, fib_usb.kicad_sch]
2024-06-17 restructured EPD side of things, replaced rp2040 with esp32 s3 because of it's LCD controller, USB, LP WIFI_BT & EPDiy compat, repurposed USB0 for ESP interfacing, added e-ink pmic
    [Fibel2.kicad_pcb, Fibel2.kicad_sch, fib_audio.kicad_sch, fib_charging.kicad_sch, fib_epd.kicad_sch, fib_esp32_s3.kicad_sch, fib_it8951.kicad_sch, fib_network.kicad_sch]
2024-06-19 added notest regarding the audio codec
    [fib_audio.kicad_sch, fib_charging.kicad_sch, fib_orin.kicad_sch]
2024-06-19 added buck converter, refactoored peripherals and updated gpio/SPI/i2c mapping
    [Fibel2.kicad_sch, fib_audio.kicad_sch, fib_charging.kicad_sch, fib_epd.kicad_sch, fib_esp32_s3.kicad_sch, fib_it8951.kicad_sch, fib_network.kicad_sch, fib_orin.kicad_sch]
2024-06-21 partially implemented E-INK PMIC
    [Fibel2.kicad_sch, epdiy-v7_BoM.csv, fib_audio.kicad_sch, fib_charging.kicad_sch, fib_epd.kicad_sch, fib_esp32_s3.kicad_sch, fib_network.kicad_sch, fib_orin.kicad_sch]
2024-06-21 added decoupling and inductors for EPD PMIC
    [Fibel2.kicad_sch, fib_audio.kicad_sch, fib_charging.kicad_sch, fib_epd.kicad_sch, fib_esp32_s3.kicad_sch, fib_network.kicad_sch, fib_orin.kicad_sch, fib_peripherals.kicad_sch]
2024-06-22 added connections to ESP32 S3, most oof EPD stuff that we're gooing to use is included
    [Fibel2.kicad_pcb, Fibel2.kicad_sch, fib_epd.kicad_sch, fib_esp32_s3.kicad_sch, fib_it8951.kicad_sch, fib_power.kicad_sch, fib_rp2040.kicad_sch, tmp.kicad_sch]
2024-06-23 refactored PCIe pages
    [Fibel2.kicad_sch, fib_epd.kicad_sch, fib_orin.kicad_sch, fib_pcie.kicad_sch, fib_peripherals.kicad_sch, fib_power.kicad_sch, fib_storage.kicad_sch]
2024-06-25 added some missing footprints, stared working ono power-on and sequencing
    [Fibel2.kicad_pcb, fib_audio.kicad_sch, fib_epd.kicad_sch, fib_orin.kicad_sch, fib_pcie.kicad_sch, fib_power.kicad_sch, fib_usb.kicad_sch]
2024-06-29 started arranging the components on the board, added some more missing footprints. starting to think about the overall distribution of parts
    [Fibel2.kicad_pcb, Fibel2.kicad_sch, fib_audio.kicad_sch, fib_charging.kicad_sch, fib_epd.kicad_sch, fib_orin.kicad_sch, fib_pcie.kicad_sch, fib_peripherals.kicad_sch]
2024-06-30 started routing the SODIMM, updated connector footprint, started arranging component into sub-areas
    [fib_epd.kicad_sch, fib_orin.kicad_sch, fib_power.kicad_sch, fib_usb.kicad_sch]
2024-06-30 did a ton of routing and modeling for SOM, USB, DP & Charging/Power, things starting to take shape
    [fib_charging.kicad_sch, fib_epd.kicad_sch, fib_usb.kicad_sch]
2024-07-02 did some work on the ports and layout
    [fib_usb.kicad_sch]
2024-07-05 implemented most of USB and Power Supplies
    [Fibel2.kicad_pcb, fib_audio.kicad_sch, fib_charging.kicad_sch, fib_epd.kicad_sch, fib_orin.kicad_sch, fib_pcie.kicad_sch, fib_power.kicad_sch, fib_usb.kicad_sch]
2024-07-07 did a big portion of pcie, optimized placement of components and subsections. power, usb and charging is largely done. still need to do length matching though. will need to take a second look at sche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
    [Fibel2.kicad_pcb, fib_epd.kicad_sch, fib_pcie.kicad_sch]
2024-07-07 further optimized placement, finished most of buck array, expanded pcie, added tons of missing footprints, diff pair spacing optimization
    [Fibel2.kicad_pcb, fib_audio.kicad_sch, fib_charging.kicad_sch, fib_epd.kicad_sch, fib_pcie.kicad_sch, fib_power.kicad_sch, fib_usb.kicad_sch]
2024-07-08 90 percent done with routing. need to go over all schematic pages, double check everything thoroughly, do lengthmatching add any missing footprints, take care of startup, ferrites, audio, eink connec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
    [Fibel2.kicad_pcb, fib_charging.kicad_sch, fib_epd.kicad_sch, fib_orin.kicad_sch, fib_pcie.kicad_sch, fib_power.kicad_sch, fib_usb.kicad_sch]
2024-07-11 replaced 1v8 buck with ldo, added startup circuit, added footprints for eink connectors
    [Fibel2.kicad_pcb, fib_audio.kicad_sch, fib_epd.kicad_sch, fib_orin.kicad_sch, fib_pcie.kicad_sch, fib_peripherals.kicad_sch, fib_power.kicad_sch, fib_usb.kicad_sch]
2024-07-12 added all missing footprints, fixed library & footprint links, did layout out 99% of components, all that's left is rtc(?), peripherals, routing & lengthmatching and final sanity checks
    [Fibel2.kicad_pcb, fib_audio.kicad_sch, fib_epd.kicad_sch, fib_orin.kicad_sch, fib_pcie.kicad_sch, fib_peripherals.kicad_sch, fib_power.kicad_sch, fib_usb.kicad_sch]
2024-07-12 removed redundant schematic files
    [Fibel2.kicad_pcb, fib_network.kicad_sch, fib_storage.kicad_sch]
2024-07-14 did length tuning, routing of final submodules and most of power routing
    [Fibel2.kicad_pcb, fib_audio.kicad_sch, fib_orin.kicad_sch, fib_peripherals.kicad_sch, fib_power.kicad_sch, fib_usb.kicad_sch]
2024-07-14 added port expander and level shifters, routed peripherals fixed most drc errors, assigned gpios etc.
    [Fibel2.kicad_pcb, fib_audio.kicad_sch, fib_epd.kicad_sch, fib_orin.kicad_sch, fib_pcie.kicad_sch, fib_peripherals.kicad_sch, fib_power.kicad_sch]
2024-07-16 routed epd displays, added testpoints and all the little checks and fixe, (regrettably) removed the i80 connector, 99% there, need to double check some things add peripheral connectors, shared-ish st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
    [Fibel2.kicad_pcb, fib_audio.kicad_sch, fib_charging.kicad_sch, fib_epd.kicad_sch, fib_orin.kicad_sch, fib_pcie.kicad_sch, fib_peripherals.kicad_sch, fib_power.kicad_sch]
2024-07-16 finished routing, sanity check and prep fabrication files next
    [Fibel2.kicad_pcb, fib_audio.kicad_sch, fib_charging.kicad_sch, fib_epd.kicad_sch, fib_orin.kicad_sch, fib_peripherals.kicad_sch]
2024-07-18 added second i2c, modified 40 pin headers
    [Fibel2.kicad_pcb, Fibel2.kicad_sch, fib_audio.kicad_sch, fib_charging.kicad_sch, fib_epd.kicad_sch, fib_orin.kicad_sch, fib_pcie.kicad_sch, fib_peripherals.kicad_sch]
2024-07-19 adde testpoints, fixed power supplies, ready to order
    [Fibel2.kicad_pcb, Fibel2.kicad_sch, fib_audio.kicad_sch, fib_charging.kicad_sch, fib_epd.kicad_sch, fib_orin.kicad_sch, fib_pcie.kicad_sch, fib_peripherals.kicad_sch]
2024-07-19 added gerbers
    [Fibel2-B_Cu.gbr, Fibel2-B_Mask.gbr, Fibel2-B_Paste.gbr, Fibel2-B_Silkscreen.gbr, Fibel2-Edge_Cuts.gbr, Fibel2-F_Cu.gbr, Fibel2-F_Mask.gbr, Fibel2-F_Paste.gbr]
